HexaGaN-org/gan-buck-converter/docs/design/input_supply.md

# Input and Supply — Design Notes

Sheet: `sheets/input_supply.kicad_sch`

**Owner:** Reza Rahimzadeh · **Reviewer:** [NAME] · **Last updated:** 2026-11-12

---

## Purpose and requirements

Protect the board from the 48 V input, measure the input current, and generate the low-voltage rails every other sheet runs on (`+5V`, `+3V3`), from either the 48 V bus or an external 5 V bench supply.

Targets are in [specifications.md](../specifications.md); boundaries and interface signals are in the **Input and supply** section of [schematic-hierarchy.md](../schematic-hierarchy.md).

**Requirements**

- Accept the full input voltage range in the specifications: 40–51 V, 48 V nominal (decision #2).
- Carry the input current: 3.95 A at 150 W and 40 V, with parts sized for the 200 W headroom (5.3 A).
- Clamp input transients below the switch-node limit published by power_stage: **90 V** (the LM5113-Q1's HS rating), including ringing. Choose the TVS clamp voltage, the fuse rating and that limit together; GaN has essentially no avalanche capability, so the clamp must stop a transient before it gets there.
- Target an ordinary hot-plug below the TVS's breakdown voltage, so the TVS is reserved for faults. This target is **unverified**: the no-TVS model reaches about 56.6 V with nominal values and 0.5 µH leads, 0.1 V below the 56.7 V minimum breakdown specification, and up to 67.1 V across the assumed part ranges.
- Protect against reverse polarity on both J201 (48 V) and J202 (5 V).
- Supply about 150 mA on `+5V` (GaN driver bias, 3.3 V LDO, USB bridge, LEDs) from an aux regulator rated for at least 300 mA.
- Select automatically between J202 and the aux regulator, with reverse-current blocking. Favor a healthy aux supply after it starts while retaining J202-only bring-up; verify that the `+5V` rail rides through every source change without resetting the MCU. If the MCU does reset, the enable sheet holds both gates off.
- Set the mux crossover so aux can take over while J202 still supplies a healthy 5 V, subject to comparator and resistor tolerances (decision #28).
- Rate J202 for at least 0.5 A. Overcurrent on the 5 V path is limited by the bench supply and the mux's current limit (decision #15).
- Provide `+3V3` for the MCU (VDDIO and VDDA, decision #19) and logic, regulating through the `+5V` hand-over dip (input down to ≈ 4.4 V).
- Allow full low-voltage bring-up from J202 with no 48 V connected.
- Measure the board's input current with a high-side shunt (decision #17), so firmware can report input power, estimate efficiency and limit input current.

**Status (2026-11-10):** schematic complete, including the indicator LEDs, and `I_SH_IN_P` / `I_SH_IN_N` are wired to sensing on the root sheet.

---

## Decision log

One row per significant choice. Never delete a row: mark it *Superseded* and add the new decision below it.

| # | Date | Decision | Options considered | Rationale | Impact on other sheets | Status |
|---|---|---|---|---|---|---|
| 1 | 2026-11-03 | 5 V source selection with a two-input power mux (TPS2121-class), external input J202 has priority | Schottky diode-OR; a jumper | The mux selects automatically with milliohms of drop and blocks reverse current, so the bench supply can never back-feed the 48 V bus. A Schottky OR drops 0.3–0.5 V, which can push the GaN driver's bias out of its 4.5–5.5 V range. Plugging in a bench supply is deliberate, so it wins; unplugging hands the rail back to the aux regulator | power_stage: `+5V` must stay within 4.5–5.5 V | Superseded by #28 for source priority |
| 2 | 2026-11-04 | Input voltage range **40 V min, 48 V typ, 51 V max** | 36–54 V (the simulation's assumption), which needs an SMBJ54A: 87.1 V clamp, 2.9 V below the 90 V limit; 40–54 V (same TVS problem) | 51 V matches the SMBJ51CA 51 V standoff. Its 82.4 V clamp at the specified 7.3 A pulse leaves 7.6 V to the driver's 90 V recommended HS limit before wiring and switching overshoot; it is not a universal surge ceiling. 40 V matches the common floor of 48 V systems; going lower raises the 200 W input current to 5.8 A for no benefit on a bench board. Below 40 V the board can still run at reduced load for bring-up, with the firmware UVLO overridden | specifications.md updated. Everything on `V_IN` must survive at least the 82.4 V rated-pulse reference and the measured application transient. power_stage input ceramics still pass at 40 V (calculation below). sensing: `V_IN_SENSE` covers the range. Simulation updated, no change to the loop margins (feedforward) | Accepted |
| 3 | 2026-11-04 | J201: Kefa KF635-6.35-2P screw terminal (C475102), the same part as J301 | XT60 (polarized, but needs an adapter lead to the bench supply, the reason it was rejected for J301); 4 mm binding posts (two extra part numbers) | 32 A and 10 AWG against at most 5.3 A; bench leads land directly; no extra loading fee | Layout: J201 and J301 are identical terminals, and 48 V on J301 would destroy the 25 V output capacitors. Put them on opposite board edges with large `48 V IN` / `12 V OUT` silkscreen and the same polarity orientation | Superseded by #30 |
| 4 | 2026-11-04 | Front-end order: J201 → fuse F201 → TVS D201 across the input → reverse-polarity FET Q201 in the return → damping capacitor C203 → `V_IN` | TVS downstream of the reverse-polarity FET; fuse after the TVS | The fuse comes first so a TVS that fails short (their usual failure) opens it. The TVS sits at the point of entry so a surge is stopped before it reaches Q201 or the power stage; being bidirectional (#5), it ignores reversed leads | none | Accepted |
| 5 | 2026-11-04 | TVS: SMBJ51CA, **bidirectional**, 600 W (hongjiacheng, C41376101) | SMBJ51A unidirectional (Littelfuse C1973217); SMBJ54A (87.1 V clamp) | 51 V standoff = maximum input; 56.7 V minimum breakdown; 82.4 V clamp at the specified 7.3 A pulse. The original hot-plug model predicted a peak below breakdown, but decision #26's added U201 capacitance removes that modeled margin. Bidirectional polarity means reversed 48 V leads do not forward-bias it; a unidirectional part across J201 could conduct continuously behind a current-limited supply. Preferred part, no loading fee | power_stage: 82.4 V `V_IN` clamp reference at the specified pulse | TVS retained; hot-plug margin pending validation |
| 6 | 2026-11-04 | Reverse polarity: **low-side N-FET** Infineon BSC070N10NS3G (C501502) in the J201 return, drain to J201−, source to GND; gate from the protected input through R202 100 kΩ 1206, clamped to 12 V by zener D202 (BZT52C12) | High-side P-FET (best 100 V part at JLCPCB with a datasheet: Vishay SUM70101EL, 10.1 mΩ, D²PAK, $4.41); high-side N-FET with an ideal-diode controller (LM74700-Q1 / LM74800-Q1 are rated 65 V, below the 82.4 V clamp); series Schottky (≈ 2 W at 4 A) | Lowest loss (≈ 0.16 W at 3.95 A), $0.60, 5 × 6 mm, and its 100 V rating exceeds the TVS's 82.4 V clamp at the specified rated pulse, with no controller to protect. Larger surges and lead-inductance overshoot still need validation. The cost is that board GND is no longer the supply's negative; acceptable because this is a standalone board on a floating bench supply. **Revisit for any design that shares ground with other boards** (signal grounds would carry return current in parallel with the FET) | Bench: keep the 48 V supply floating; measure at the board's `V_IN` / GND test points, not at J201 | Accepted |
| 7 | 2026-11-04 | Fuse F201: Littelfuse 0451007.MRL, 7 A, 125 V DC, fast-acting, 2410 (C99548) | 7 A 1206 fuses rated 32 V (below the clamp voltage); time-lag 2410 parts (I²t 100+ A²s, no need) | Voltage rating above the 82.4 V clamp. 56 % of rating at 150 W and 40 V. Melting I²t 10.3 A²s is about 19× the current nominal hot-plug model's largest 0.53 A²s; confirm real lead conditions and repeated-pulse behavior. 50 A interrupting rating is intended for a current-limited bench supply. It protects wiring and the supply from a hard short; it cannot save the GaN FETs from switching faults | none | Accepted; updated hot-plug estimate in #26 |
| 8 | 2026-11-04 | Damping capacitor C203: JARSON FZ2A101M1313, 100 µF 100 V aluminum electrolytic, 320 mΩ ESR (C5260780), from `V_IN` to GND downstream of Q201 | No bulk capacitor; a polymer capacitor (ESR too low to damp anything) | Original calculation used only the power stage's 10.4 µF of ceramics and predicted about 54 V on a 51 V hot-plug with C203. It omitted U201's ceramics on the same `V_IN` bus; decision #26 and the current calculation below replace the hot-plug conclusion. C203 also lowers the input-filter output-impedance peak in the original model | none | Superseded by #27: 0.32 Ω is impedance, not a specified ESR; hot-plug margin pending validation |
| 9 | 2026-11-05 | Keep the single C203 (decision #8); judge its ripple current against its ambient-derated rating, not the 105 °C figure | Two 47 µF 100 V electrolytics in parallel (high-ESR parts are rated only 0.2 A each, which is worse); two low-ESR 47 µF parts (AISHI C3038651) plus a 0.20 Ω metal-strip damping resistor (Vishay WSL2512R2000FEA, C844905): works, 3 parts; a single larger-can 100 µF (Ymin VKME1452A101MV, C487440, 1.04 A) | An electrolytic's ripple rating is set at its maximum temperature (105 °C) to cap core temperature; at a 25–45 °C bench ambient the allowed ripple is typically 1.7–2× higher. The 0.75 A worst case is a sweep corner (40 V, 300 kHz, full load); at 48 V and 400 kHz it is 0.49 A, inside even the 105 °C rating. Moving C203 farther from the power stage barely helps (20 → 80 nH: 0.75 → 0.71 A), because ESR, not inductance, sets the split | none | Superseded by #27: revised model and exact JARSON datasheet remove the claimed ripple margin; ambient multiplier unverified |
| 10 | 2026-11-05 | Aux regulator U201: TI LM5164DDAR (C477928), 100 V 1 A synchronous buck, constant on-time | LM5163 (0.5 A, same family, $2.28; datasheet not checked); LM5017 / LM5018 (older 100 V parts); SCT2A10A (100 V, $2.89); SY8511 and other non-synchronous parts (need a catch diode); 60–80 V parts (below the 82.4 V clamp) | VIN absolute maximum 100 V, 17.6 V above the TVS clamp reference at its specified pulse; 6–100 V operating, so it also starts during reduced-voltage bring-up; synchronous, internally compensated and with an internal VCC regulator, so few parts; 1 A against a ≈ 150 mA load | none | Accepted |
| 11 | 2026-11-05 | U201 configuration: ≈ 620 kHz (R207 20 kΩ), Type-3 ripple injection (R205 / C202 / C204), EN/UVLO tied to `V_IN`, PGOOD unused, output on local net `5V_AUX` | 750 kHz with 16.9 kΩ (Extended part); Type-1 ripple (1 resistor, but ≈ 80 mV on the GaN driver's supply); an EN divider for a 38 V hardware UVLO (2 parts) | 620 kHz sits above the power stage's 300–500 kHz band and keeps 97 ns on-time at the 82.4 V clamp (50 ns minimum). Type 3 keeps output ripple ≈ 2 mV on the rail that drives the low-side GaN gate directly. Tying EN to `V_IN` costs nothing; input UVLO stays with firmware. `5V_AUX` must be a local label, not the `+5V` power symbol, or the bench supply on J202 back-feeds the regulator and charges `V_IN` through its high-side body diode | firmware: owns input UVLO (open questions) | Accepted |
| 12 | 2026-11-05 | Power mux U203: TI TPS2121RUXR (C485916) | TPS2116DRLR (C3235557, $0.39, 1.6–5.5 V, no overvoltage cutoff) | `+5V` drives the GaN driver's VDD, which drives the low-side gate with no clamp (power_stage #5). The TPS2121 survives 22 V on its inputs, and OV1 cuts J202 off before `+5V` exceeds the gate's limit; a bench supply set to 12 V by mistake destroys a TPS2116 and passes through. 56 mΩ on-resistance: ≈ 10 mV at 150 mA | power_stage: `+5V` protected against J202 overvoltage | Accepted |
| 13 | 2026-11-05 | Mux configuration: XCOMP fast switchover (≈ 5 µs), following TPS2121 datasheet Figure 10-9. IN1 = `5V_EXT`, IN2 = `5V_AUX`. PR1 and OV1 share one divider from IN1 (R210 75 k / R213 8.2 k / R216 20 k); CP2 from IN2 (R212 30 k / R215 10 k); OV2 and ST to GND; ILM R214 100 kΩ; SS C215 100 nF | Plain priority mode (≈ 100 µs switchover, needs ≈ 100 µF effective on `+5V`, about six 22 µF parts); separate OV1 and PR1 dividers as in Figure 10-9 (one more resistor); ST driving the SOURCE LED (ST is open-drain and needs a 6–20 kΩ pull-up) | At the TPS2121's typical 5 µs fast transfer, one 22 µF capacitor predicts ≈ 55 mV of dip; no maximum transfer time or minimum rail voltage is established. Ratiometric switch point: J202 hands over below 0.915 × `5V_AUX` (≈ 4.54–4.68 V). OV1 cuts J202 at 5.47 V nominal (5.21–5.68 V), between a 5.0 V bench setting and the GaN gate limit. Current limit ≈ 1.24 A. SOURCE LED (LED203) powered from `5V_EXT` instead, so it lights whenever J202 is live | power_stage, mcu: illustrative `+5V` value ≈ 4.48 V during a hand-over; see current margin review | Source preference and R212 superseded by #28; XCOMP and OV1 retained |
| 14 | 2026-11-05 | J202: JST B2B-XH-A(LF)(SN) 2-pin keyed header (C158012), with a dedicated banana-to-XH bench cable | 5.08 mm screw terminal (C8465); 2.54 mm pin header; barrel jack | A keyed wire-to-board connector physically can't take the 48 V bench leads; a screw terminal accepts any wire, and 48 V on J202 exceeds the TPS2121's 24 V absolute maximum. Keying also makes reversed polarity unlikely. 3 A rating; genuine JST, 600k in stock, $0.04 | Bench: build one J202 cable (XH housing and crimps to banana plugs) | Accepted |
| 15 | 2026-11-05 | J202 reverse polarity: high-side P-FET Q202 AO3401A (C15127, Basic), drain to J202 pin 1, source to `5V_EXT`, gate to GND. No PTC on J202 | PTC (e.g. 500 mA 1206); Schottky diode (0.3–0.4 V drop, too much for the driver's 4.5 V minimum); the TPS2121's GND-pin diode scheme (protects only the mux) | 60 mΩ at 4.5 V, ≈ 9 mV drop; gate rated ±12 V, so no zener at 5 V. Overcurrent is already limited by the bench supply, the TPS2121's ≈ 1.24 A current limit and the 3 A connector; between J202 and the mux there is only Q202 and a short trace. Changes the requirement that J202 have a fuse or PTC | none | Accepted |
| 16 | 2026-11-05 | USB-C (USBC701, comms_debug) stays data only; J202 remains the 5 V bring-up input | USB VBUS as mux IN1 in place of J202 | Keeps comms_debug.md's requirement that USB never powers the board or back-powers the MCU. VBUS can sag to ≈ 4.75 V, tight against the driver's 4.5 V minimum, and a board fault would load the laptop's port | none | Accepted |
| 17 | 2026-11-05 | Input current sense: **1 mΩ shunt R201, the same part as power_stage R301** (FOJAN FPM253WFR001TML, C7420016), high side, between the protected input (after F201 and D201; Q201 sits in the return) and the `V_IN` node, so it carries C203's, U201's and the power stage's current. Kelvin pair `I_SH_IN_P` / `I_SH_IN_N` to sensing through net ties (#21) | No input sensing (firmware infers input power from the output); 2 mΩ shunt (2× the signal, 22 mW, but a new Extended part); low-side shunt in the return (ground-referenced, but it splits board ground from J201− further and a bench ground loop can bypass it) | One unique part already on the board, so no loading fee; 16 mW at 40 V full load. Gives on-board input power for telemetry, an input-current limit, fault diagnosis (input power that doesn't match output power), and coarse on-board efficiency (about ±1–2 %, ±0.3 % after bench calibration). It is **not** accurate enough to label the edge-AI training data, which still comes from bench instruments | sensing: new amplifier channel with common mode at `V_IN`, surviving the 82.4 V transient. mcu: one more ADC pin. schematic-hierarchy: new signals `I_SH_IN_P`, `I_SH_IN_N`, `I_IN_SENSE` | Accepted |
| 18 | 2026-11-05 | 3.3 V LDO U202: ST LDL1117S33R (C435835), SOT-223, 1.2 A, from `+5V` | AMS1117-3.3 (C6186, Basic, no loading fee); ME6211C33 (C82942) and RT9013-33 (C47773), both SOT-23-5 | Dropout 350 mV typ / 600 mV max at 1.2 A; the original #13 illustrative 4.48 V hand-over point gives ≈ 1 V of headroom, but the actual minimum is unbounded and 3.3 V regulation through transfer requires measurement. The AMS1117's 1.1–1.3 V dropout needs ≥ 4.6 V in, and it wants 5 mA quiescent current and traditionally a 22 µF tantalum output. ME6211 / RT9013 are rated 6 V / 5.5 V maximum input, too close to the 5.68 V worst-case J202 cutoff, and ≈ 0.26 W in SOT-23-5 runs hot. LDL1117: 20 V absolute maximum, θJA 56 °C/W, ±2 % at 25 °C, ±3 % over temperature, stable with ceramics | mcu: `+3V3` 3.3 V ±3 % | Accepted |
| 19 | 2026-11-05 | No separate `+3V3A`: MCU VDDA stays on `+3V3`, as the MCU sheet already draws it | Ferrite bead (Murata BLM18PG121SN1D, C14709) plus 1 µF on this sheet feeding a `+3V3A` net to VDDA | TI permits a common source for VDDIO and VDDA. Saves two parts and a cross-sheet net, and needs no change on the MCU sheet, where VDDA is decoupled to `GNDA` and `GNDA` joins `GND` at one net tie. Revisit if the ADC noise floor turns out to matter (verification test 15) | schematic-hierarchy: `+3V3A` removed. sensing: clamp signals to `+3V3`, not `+3V3A` | Accepted |
| 20 | 2026-11-05 | Power LED LED202 (KENTO KT-0805G, green) on `+3V3` through R209 2.2 kΩ | Power LED on `+5V` | `+3V3` is the last rail in the chain, so a lit LED means every upstream rail is up. Green keeps it distinct from the yellow SOURCE LED. 2.2 kΩ reuses the MCU sheet's part | none | Accepted; R209 value superseded by #25 |
| 21 | 2026-11-05 | Shunt Kelvin connections through net ties NT201 and NT202, brought out as hierarchical labels `I_SH_IN_P` (fuse side) and `I_SH_IN_N` (`V_IN` side) | Labels directly on the shunt's power wires (how power_stage R301 is drawn today) | Without the ties, `I_SH_IN_N` would be the `V_IN` net under a second name and `I_SH_IN_P` the whole fuse node, so layout could tap the sense lines anywhere on 5 A copper. With a 3–5 mV signal, a few centimetres of power copper in the measurement path is a few percent of error. The ties make two separate nets that can only meet the power copper at the shunt's pads, and DRC enforces it | root sheet: sheet pins to sensing (pending). power_stage: R301 had the same issue; resolved 2026-11-06 with NT302 / NT301 (power_stage #14) | Accepted |
| 22 | 2026-11-05 | Test points TP201–TP205 on `5V_EXT`, `5V_AUX`, GND, `+5V` and `+3V3`. `V_IN` uses power_stage's `TP_VIN301`. No test point on `V_IN_RTN` | A second `V_IN` test point; a pad on `V_IN_RTN` | One `V_IN` pad is enough on one net. The ground pad sits beside the rail points so the 5 µs hand-over dip (test 9) can be scoped with a short ground spring; power_stage's ground pads are by the switch node and `V_OUT`. A pad on `V_IN_RTN` invites a ground clip that bypasses Q201 | none | Accepted |
| 23 | 2026-11-06 | Keep the J202 overvoltage cutoff as designed (#13: OV1 5.47 V nominal, 5.21–5.68 V) and treat it as a mistake-catcher, not a guarantee that `+5V` stays at or below 5.5 V | Retune OV1 to ≈ 5.30 V nominal (5.05–5.50 V), which keeps `+5V` ≤ 5.5 V but can cut off a 5.0 V bench supply at worst-case $V_{REF}$, and moves the hand-over ratio (#13) | No divider satisfies both: with $V_{REF}$ at ±4 %, a cutoff that never exceeds 5.5 V reaches down to 5.05 V. The bench rule is 5.0 V on J202, so the band between 5.5 V and the cutoff is reachable only with a mis-set supply. In that band the low-side GaN gate sees up to 5.68 V continuously, above Infineon's 5.5 V recommended maximum (its ±6.5 V rating is for pulsed, abnormal conditions only). Accepted risk on a bench board | power_stage: published `+5V` maximum now states this exception (power_stage #15) | Accepted |
| 24 | 2026-11-06 | Fast input-overvoltage trip: `V_IN_SENSE` on a CMPSS comparator routed through the ePWM X-BAR to the trip zone, threshold ≈ 55 V (≈ 1.43 V at sensing's $V_{IN}/38.5$ scale), latched | ADC-only input OVLO (the 53 V proposal in the open questions: tens of microseconds or slower, too slow for a surge); a hardware comparator on this sheet feeding the enable logic | The 7.6 V clamp margin (#2) covers `V_IN` alone. A surge that arrives while the converter is switching adds switch-node overshoot on top of the clamped `V_IN` (power_stage verification test 2 allows up to ≈ 32 V of overshoot at 48 V). The target is to stop switching within about a microsecond of a qualifying input surge, before the two voltages can stack toward the 90 V HS limit. The nominal 1 µs RC alone takes about 1.61 µs to cross a 55 V threshold for an ideal 51-to-56 V step, so the target remains unproven. 55 V sits above the 51 V maximum (plus ≈ 0.4 V of filtered switching ripple) and the proposed 53 V slow OVLO, and below the TVS's 56.7 V minimum breakdown. A hot-plug transient can latch the trip while the stage is idle; its revised nominal model peaks around 56.0–57.5 V, so firmware clears the latch before enabling switching | sensing: C405 changed to 1 nF, giving a nominal 1 µs RC time constant. mcu: `V_IN_SENSE` stays on pin 15, CMPSS3 low comparator with inverted output; its trip is separate from the CMPSS3 high overcurrent path. firmware: configure, latch, clear before enable. Verify end-to-end response on hardware | Accepted topology; response-time target pending verification |
| 25 | 2026-11-06 | Indicator LEDs per [indicator-leds.md](indicator-leds.md): LED202 `POWER` (KT-0805G) through R209 **330 Ω**; LED203 `EXT 5V` changed to white KT-0805W (C34499) through R211 **2.2 kΩ**; new LED201 `48V` (red NCD0805R1, C84256) fed from the fuse node through **R203 ∥ R204**, 100 kΩ 1206 each, cathode to GND. Supersedes #20's R209 value | 48V tap on `V_IN` (after R201), as first planned; a single 100 kΩ (≈ 0.5 mA) | One color scheme and ≈ 1 mA across the board (indicator-leds.md); the 2.2 kΩ that R209 had left the green POWER LED at 0.1–0.3 mA. Tapping the fuse node (like R202) keeps the LED's ≈ 1 mA out of the input-current reading. With the cathode on GND, a reversed input finds no path through the LED: Q201 blocks it | none | Accepted |
| 26 | 2026-11-11 | Increase U201's local input bank from C206/C207 to **C206/C207/C208/C209/C210**, five Samsung CL31B225KCHSNNE 2.2 µF, 100 V X7R 1206 parts in parallel | Keep two (below TI's recommended 2.2 µF after the recorded DC-bias loss); use four (small estimated corner margin at 51 V); change to a larger 1210 part | The [recorded Samsung curve readback](../guides/preferred-parts.md) retains 37.5% at 48 V and 29% at 60 V. Linear interpolation gives about 35.4% at 51 V: five parts estimate 3.89 µF there, or 2.98 µF after multiplying by the part's -10% initial tolerance and X7R's -15% temperature allowance from the [manufacturer specification](https://evelta.com/content/datasheets/110-CL31B225KCHSNNE.pdf). This is an engineering budget, **not a guaranteed minimum at bias**; verify the exact-part bias data and local VIN/GND placement before layout freeze. The additional bus capacitance changes the hot-plug model and TVS margin | input_supply: update hot-plug sensitivity; layout: all five form U201's local high-frequency bank | Schematic change made; capacitance and hot-plug margin pending validation |
| 27 | 2026-11-11 | Keep D201 and C203 provisionally while correcting the hot-plug model; do not claim ordinary 51 V live hot-plug is TVS-free | Replace the TVS or bulk cap immediately from nominal voltage alone | The revised model includes all five U201 input capacitors and a sensitivity TVS branch. The [exact JARSON FZ datasheet](https://atta.szlcsc.com/upload/public/pdf/source/20240702/CB724D03555E79E98CBC22F7BB5AFDA6.pdf) rates C203 at **0.45 A rms at 100 kHz/105 °C**, below the modeled 0.56 A at 40 V/300 kHz, and its 0.32 Ω number is impedance at 100 kHz/20 °C, not a guaranteed ESR. This leaves both ripple life and hot-plug damping unqualified. Ymin [VKME1452A101MV](https://www.ymin.cn/chip-miniature-type-aluminum-electrolytic-capacitors-vkm-product/) is a 100 V/100 µF, 1.04 A-rated candidate but gives no exact-part ESR/impedance data; it also needs a new footprint and assembly check. Ask for impedance/ripple data or select and model a documented alternative before freezing the BOM | layout: keep C203 placement flexible; test: measure actual hot-plug and C203 heating | Input protection and C203 part choice remain open |
| 28 | 2026-11-11 | Move the TPS2121 crossover earlier by changing R212 from 30 kΩ to 26.1 kΩ (UNI-ROYAL 0603WAF2612T5E, JLC C23356); keep R215 10 kΩ, the J202 OV1 divider, the 4.96 V aux set point, and C214 unchanged. Healthy aux may take over before J202 is removed; J202-only bring-up still works. Supersedes #1 priority and #13 R212 setting | Retune aux or add output hold-up now; keep J202 unconditionally preferred; add an XREF reference and qualification circuit | The nominal XCOMP ratio rises from 0.915 to 1.014. At 4.96 V aux, the nominal falling-J202 crossover is near 5.03 V; during aux rise with J202 near 4.99 V, takeover is near 4.92 V. Source selection with both rails near 5 V is tolerance dependent (only about 10 mV nominal CP2−PR1 at 4.99 V ext/4.96 V aux, versus 40 mV maximum comparator offset). A screening calculation using 1 % resistors, 40 mV offset, 4.81 V low aux, 150 mA, 5 µs and 13.6 µF effective C214 gives a lowest illustrative rail near 4.52 V, including an assumed 10 mV mux drop; 300 mA, a longer transfer, or lower effective capacitance can cross 4.5 V. TPS2121 specifies no maximum fast-transfer time | input_supply: measure both ramp-up source change and J202 removal; power_stage: check U301 VDD; layout: no new capacitor or active part | Schematic updated; rail margin and source selection pending bench validation |
| 29 | 2026-11-11 | Replace C203 with Ymin VKME1452A101MV (LCSC C487440), 100 µF/100 V, 1.04 A rms at 100 kHz/105 °C; supersedes #27's provisional JARSON part choice | Keep the JARSON 0.45 A part; Vishay MAL215099907E3 at 0.66 A | The modeled worst operating ripple was 0.47 A rms, a 2.21× nameplate margin at the stated rating conditions; with power_stage's three-part bank (its decision #24) it is 0.68 A rms and 1.53×. The new part is smaller, Ø10 × 14.5 mm, and now uses the C487440-specific JLCImport land pattern and 3D model. Its ESR is not published for the exact part, so hot-plug damping and TVS pulse exposure remain assumptions in the model. The imported footprint has 4.50 × 1.65 mm pads on 9.00 mm centers, with pad 1 positive; confirm board placement/rotation, JLC assembly availability, and measured transient behavior before release | layout: C203 footprint and placement change; simulations: ESR remains a swept assumption | Exact-part JLC CAD footprint assigned; placement preview, stock and damping pending verification |

| 30 | 2026-11-13 | Replace J201 with Amass XT30PW-M30.G.Y PCB male (C431092), pad 2 positive, pad 1 `V_IN_RTN`; supersedes #3 | Keep the screw terminal; use XT60 at the input | Different size from the 12 V output connector, polarized cable interface, 15 A listing against at most 5.3 A estimated input; the source cable uses a female XT30U-F solder plug and must be built before bench use | Layout: right edge placement, solder and mounting holes, copper routing, cable clearance, and [harness note](input-output-connectors.md). JLCPCB: Extended, Economic-compatible wave soldering | Implemented in schematic and PCB footprint; routing and physical fit pending |
---

## Calculations

One row per calculation. Note where each input came from (specification, datasheet, measurement) in Notes.

| Calculation | Formula | Result | Notes |
|---|---|---|---|
| Input current, 150 W | $P_{out} / (\eta V_{in})$ | 3.95 A at 40 V · 3.29 A at 48 V · 3.10 A at 51 V | η ≈ 95 % (specifications) |
| Input current, 200 W | same | 5.26 A at 40 V · 4.39 A at 48 V | Rating case for F201, Q201, J201 and copper |
| TVS clamp margin | $V_{HS,max} - V_{C}$ | $90 - 82.4 = 7.6$ V | SMBJ51CA $V_C$ at $I_{PP}$ = 7.3 A (datasheet); LM5113-Q1 HS 90 V (power_stage). Trace inductance between D201 and the protected node spends this margin |
| TVS dynamic resistance (worst case) | $(V_C - V_{BR,max}) / I_{PP}$ | $(82.4 - 62.7) / 7.3 \approx 2.7\,\Omega$ | Clamp ≈ $V_{BR} + I R_{dyn}$: about 65 V at 1 A, 71 V at 3 A. A bench supply can't drive the rated current, so real clamps sit low on this slope |
| Input ceramics at 40 V (power_stage check) | $I_{out} D(1-D) / (f_{sw} \Delta V_{in})$ | $12.5 \cdot 0.21 / (300\,kHz \cdot 1\,V) \approx 8.7$ µF needed | D = 0.3. At the 400 kHz nominal frequency the need is 6.6 µF. power_stage's three-part bank (decision #24) gives at least its 8.12 µF 48 V estimate at 40 V (less DC-bias loss), so it meets the 400 kHz figure and is close to the 300 kHz one. The bias estimate is typical, not a guaranteed minimum |
| Q201 conduction loss | $I^2 R_{DS(on),hot}$ | $3.95^2 \cdot 10.5\,m\Omega \approx 0.16$ W (0.29 W at 5.3 A) | 7 mΩ max at 10 V (datasheet) × 1.5 assumed hot |
| Q201 gate-source voltage | zener clamp | ≈ 11–12 V from 15 V input up to the 82.4 V clamp | BZT52C12: 11.4–12.6 V at its 5 mA test current, a little lower at 0.3–0.4 mA. $R_{DS(on)}$ is specified at 10 V; FET limit ±20 V |
| Q201 turn-on time constant | $R_{202} C_{iss}$ | $100\,k\Omega \cdot 3\,nF \approx 0.3$ ms | The body diode carries the current meanwhile; the converter isn't switching yet (UVLO) |
| R202 voltage and power | $(V_{IN} - V_Z)$; $(V_{IN} - V_Z)^2 / R$ | 39 V, 15 mW at 51 V; 70 V, 50 mW at the 82.4 V clamp | 1206 rated 200 V / 250 mW. An 0603 (≈ 75 V working voltage) is too close |
| D202 current | $(V_{IN} - V_Z) / R_{202}$ | 0.28 mA at 40 V, 0.39 mA at 51 V | R202 taps upstream of the shunt, so this current isn't measured: 0.01 % of full-load input current |
| Fuse loading | $I_{in} / I_{rated}$ | 56 % at 150 W, 40 V; 76 % at 200 W, 40 V | Littelfuse suggests ≤ 75 % continuous at 25 °C |
| Hot-plug characteristic impedance | $Z_0 = \sqrt{L_{lead} / C_{cer}}$ | $\sqrt{1\,\mu H / 11.51\,\mu F} \approx 0.295\,\Omega$ | The 51 V estimate interpolates the power-stage bank (three 10 µF + four 100 nF, power_stage decision #24) between 8.12 µF at 48 V and 6.14 µF at 60 V (7.62 µF at 51 V), then adds U201's five capacitors at about 3.89 µF total. These are unverified typical curve readbacks; lead inductance and 0.32 Ω C203 ESR are assumed. |
| Hot-plug peak, 51 V | `simulations/input_hotplug_sim.py` | With C203 and nominal values, about 56.6 / 55.1 / 54.6 V for 0.5 / 1 / 2 µH leads | One-node, no-TVS screening model with an ideal 51 V step and 50 mΩ round trip assumed. The illustrative ceramic range is 8.34–15.14 µF using separate X7S/X7R tolerance and temperature factors; sweeping that range, C203 at 80–120 µF, and assumed ESR from 0.16–0.64 Ω gives up to 67.1 V. These are **not** guaranteed component corners. D201 is upstream of Q201, so the lumped-node result does not prove its pad voltage. Do not claim normal live hot-plug stays below breakdown. |
| TVS pulse sensitivity, 51 V | Piecewise-linear $I_{TVS} = \max(0, (V-V_{BR})/R_{dyn})$ | For $V_{BR}=56.7$ V the nominal lead sweep stays just below breakdown, so the TVS does not conduct; with the assumed ESR/capacitance sweep, up to 2.86 A peak and 1.21 mJ | Illustrative same-node model, not a guaranteed I–V or pulse-rating check. The [Hongjiacheng SMBJ51CA datasheet](https://xonstorage.z8.web.core.windows.net/pdf/hongjiacheng_smbj170a__xonlink.pdf) gives 56.7–62.7 V breakdown at 1 mA and 82.4 V maximum clamp at 7.28 A for a 10/1000 µs pulse. Its 600 W rating must be evaluated with pulse width and temperature; unknown board parasitics and bench-source behavior dominate here. |
| Hot-plug I²t | $\int i^2\,dt$ (simulation) | Up to about 0.53 A²s in the nominal no-TVS lead sweep | Against 10.3 A²s melting I²t for F201. The ideal-step model also predicts up to 229 A peak inrush; source current limit and Q201's initial body-diode path are omitted. Neither figure is a fuse or semiconductor surge approval. |
| Input-filter stability (Middlebrook) | peak $\lvert Z_{out,filter} \rvert$ vs $V_{in}^2 / P_{in}$ | 0.27 Ω with C203 (1.60 Ω without) vs 10.1 Ω at 40 V, full load | Nominal 11.51 µF lumped-bank model over 1–100 kHz; layout parasitics can change the result. |
| C203 ripple current | harmonic split of the pulsed input current (simulation) | About 0.44 A rms at 48 V, 400 kHz; 0.68 A at 40 V, 300 kHz | The model uses the 51 V ceramic estimate at all operating voltages and assumes 20 nH of can ESL plus trace. [Ymin rates the selected C203 at 1.04 A rms](https://www.ymin.cn/chip-miniature-type-aluminum-electrolytic-capacitors-vkm-product/) at 100 kHz/105 °C, 1.53× the modeled worst operating estimate. C203 carries more ripple since power_stage decision #24 reduced the ceramic bank beside it. Actual ripple and can temperature need measurement; published ESR data for this exact part are unavailable. |
| **Input current sense (R201)** | | | |
| Shunt loss | $I_{in}^2 R$ | $3.95^2 \cdot 1\,m\Omega \approx 16$ mW at 40 V, 150 W; 28 mW at 5.3 A | 3 W part, so no thermal concern |
| Shunt signal | $I_{in} R$ | 3.3 mV at 48 V / 150 W · 3.95 mV at 40 V · 5.3 mV at 200 W, 40 V · 0.66 mV at 20 % load | Amplifier offset (tens of µV) is a few percent at 20 % load: calibrate the zero at start-up with switching off |
| **Aux regulator (U201, LM5164)** | | | Equations from the LM5164 datasheet (SNVSAU4D) |
| Output voltage | $1.2\,V (1 + R_{206}/R_{208})$ | $1.2 (1 + 470/150) = 4.96$ V | Type-3 ripple adds about half the FB ripple as offset (≈ 12 mV at FB, ≈ 50 mV at the output), so ≈ 5.0 V expected; confirm on the bench |
| Switching frequency | $2500\,V_{OUT} / R_{207}$ (kHz, V, kΩ) | $2500 \cdot 4.96 / 20 \approx 620$ kHz | Eq. 1. Above the power stage's 300–500 kHz band |
| On-time | $R_{207} / (2.5\,V_{IN})$ (µs, kΩ, V) | 200 ns at 40 V · 167 ns at 48 V · 97 ns at the 82.4 V clamp | Eq. 11. Minimum 50 ns; below 300 ns the minimum off-time is 250 ns |
| Highest input before frequency fold-back | $V_{OUT} / (t_{ON,min} F_{SW})$ | $4.96 / (50\,ns \cdot 620\,kHz) \approx 160$ V | Eq. 17 |
| Inductor ripple | $\frac{V_{OUT}}{F_{SW} L}(1 - V_{OUT}/V_{IN})$ | 0.153 A p-p at 48 V (0.19 A with L at −20 %) | Eq. 18. 47 µH; continuous conduction above ≈ 76 mA load |
| Peak inductor current | $I_{OUT} + \Delta I_L / 2$ | 0.38 A at a 0.3 A design load | L201 saturates at 2 A, above the 1.5 A current limit as the datasheet asks |
| Output capacitance | $\Delta I_L / (8 F_{SW} \Delta V_{OUT})$ | 1.2 µF needed for 25 mV; C205 gives 13.6 µF effective, ≈ 2 mV ripple | Eq. 21. C12891 keeps 62 % at 5 V |
| Input capacitance | $I_{OUT} D(1-D) / (F_{SW} \Delta V_{IN})$ | 0.09 µF ripple-only estimate; five 2.2 µF parts C206/C207/C208–C210 give about 4.13 µF at 48 V and 3.89 µF at 51 V using the recorded bias-curve percentages | Eq. 23 is a ripple estimate, not the full layout recommendation. [TI recommends at least 2.2 µF high-frequency input capacitance](https://www.ti.com/lit/ds/symlink/lm5164.pdf) close to U201. At 51 V, the preliminary 3.89 µF becomes about 2.98 µF if -10% initial tolerance and -15% temperature allowance are applied multiplicatively. The curve values are typical readbacks, so this is not a guaranteed minimum; verify the exact part and layout. |
| Type-3 CA (C202) | $C_A \ge 10 / (F_{SW} (R_{FB1} \parallel R_{FB2}))$ | ≥ 142 pF; 1 nF fitted | Eq. 24 |
| Type-3 RA·CA (R205·C202) | $R_A C_A \le t_{ON}(V_{IN} - V_{OUT}) / 20\,mV$ | ≤ 3.6 × 10⁻⁴ s; 300 kΩ × 1 nF = 3.0 × 10⁻⁴ s | Eq. 25. FB ripple 24 mV at 48 V, 23 mV at 40 V, 16 mV at 12 V (≥ 12 mV minimum) |
| Type-3 CB (C204) | $C_B \ge t_{settle} / (3 R_{FB1})$ | ≥ 53 pF for 75 µs; 100 pF C0G fitted | Eq. 26 |
| R205 (RA) voltage | $V_{SW} - V_{OUT}$ | up to ≈ 77 V at the clamp | 0805 (150 V); 0603 (75 V) is too close |
| **Power mux (U203, TPS2121)** | | | Equations and limits from the TPS2121 datasheet (SLVSEA3F); $V_{REF}$ 1.06 V typ (1.01–1.10 V) |
| J202 overvoltage cutoff (OV1) | $V_{REF}(R_{210}+R_{213}+R_{216}) / R_{216}$ | 5.47 V nominal, 5.21–5.68 V | Keep the bench supply at 5.0 V |
| Aux feedback-only corner | 1.181–1.218 V FB reference and 1 % extremes of R206 = 470 kΩ, R208 = 150 kΩ | 4.81–5.11 V ideal DC | Screening range before Type-3 ripple-injection offset, output ripple, temperature effects beyond the reference specification and wiring drop; measure the actual rail. |
| Hand-over point (XCOMP) | k1 = 28.2/103.2 = 0.2733; k2 = 10/36.1 = 0.2770; IN2 is selected when k1 × V_EXT falls below k2 × V_AUX | Nominal falling-J202 crossover V_EXT ≈ 1.014 × V_AUX = 5.03 V at 4.96 V aux. With V_EXT near 4.99 V, aux-ramp crossover is about 4.92 V. | Comparator offset up to 40 mV and 1 % resistors shift either crossover; aux selection with both rails near 5 V is not guaranteed. |
| Fast-mode condition | V_CP2 ≥ V_REF | 0.2770 × 4.96 = 1.374 V versus 1.10 V maximum V_REF | Nominal XCOMP fast-mode condition is met above about 3.97 V aux, and remains met at both screened crossover corners. |
| Source comparison near nominal | V_CP2 − V_PR1 at V_EXT = 4.99 V, V_AUX = 4.96 V | About +10 mV, favoring aux nominally | Smaller than the TPS2121 40 mV maximum comparator offset; source selection varies with tolerances. |
| J202 valid with no 48 V | $V_{REF} / k_1$ | 3.88 V (3.70–4.03 V) | Plain priority mode when CP2 = 0 |
| Screened crossover corners | Use 1 % extremes of both dividers and a 40 mV adverse comparator offset | During aux rise with V_EXT = 4.99 V, earliest takeover is near V_AUX = 4.64 V; with V_AUX = 4.81 V, latest falling-J202 transfer is near V_EXT = 4.59 V. | With 150 mA, 5 µs, 13.6 µF and an assumed 10 mV mux drop, the latter gives about 4.52 V at OUT. These combined corners are a screening calculation, not a guaranteed minimum. |
| Hand-over dip | ΔV = t_FSW × I_OUT / C_OUT | 5 µs × 0.15 A / 13.6 µF ≈ 55 mV. The combined low-aux, 1 % divider and 40 mV offset screening case gives an illustrative floor near 4.52 V after an assumed 10 mV mux drop. | Nominally aux takes over while J202 is still healthy, so later J202 removal causes no transfer. The screening floor is not a guaranteed minimum: TPS2121 gives 5 µs only typically and the capacitance, load and source voltages require hardware validation. |
| Current limit | $65.2 / R_{214}^{0.861}$ (A, kΩ) | 1.24 A at 100 kΩ; fast trip ≈ 2.4 × that | Eq. 2; 100 kΩ is the largest allowed value |
| Soft-start | Table 9-1 | 780 V/s with 100 nF (C215); ≈ 16 mA inrush into ≈ 20 µF | |
| Divider currents | $V / R$ | 48 µA (PR1/OV1 chain), about 138 µA (CP2 at 5 V aux) | |
| Q202 drop | $I \cdot R_{DS(on)}$ | $0.15\,A \cdot 60\,m\Omega \approx 9$ mV | AO3401A at 4.5 V drive |
| EXT 5V LED (LED203) current | $(V_{EXT} - V_F) / R_{211}$ | $(5 - 2.9) / 2.2\,k\Omega \approx 0.95$ mA (0.82–1.09) | KT-0805W $V_F$ 2.6–3.2 V |
| **3.3 V LDO (U202, LDL1117S33R)** | | | ST LDL1117 datasheet |
| `+3V3` load budget (estimate) | sum of loads | ≈ 120–150 mA; designed for 300 mA | MCU ≈ 100 mA (ESTIMATE: confirm in the TMS320F280039C datasheet §6.5.1, internal VREG at 120 MHz), LEDs ≈ 5–10 mA, USB bridge I/O and enable logic ≈ 10–20 mA |
| Headroom in the hand-over dip | V_IN − V_OUT versus dropout | At the revised illustrative 4.52 V screening point, 4.52 − 3.3 = 1.22 V versus ≤ 600 mV dropout (max, at 1.2 A) | The 4.52 V point is not a guaranteed minimum; measure the actual rail and U202 output through both source transitions. |
| Dissipation | $(V_{IN} - V_{OUT}) I$ | 0.26 W at 5.0 V, 150 mA (≈ +15 °C); 0.51 W at 300 mA (≈ +29 °C); 0.71 W at 5.68 V, 300 mA (≈ +40 °C) | θJA 56 °C/W (ST datasheet, with copper on the tab) |
| Capacitors | datasheet | C211 1 µF at VIN (≥ 1 µF required); C212 10 µF 0603 at VOUT | ST characterizes the output with 4.7 µF ceramic; C212's effective value at 3.3 V is lower than 10 µF but should stay above that |
| POWER LED (LED202) current | $(3.3 - V_F) / R_{209}$ | ≈ 1.4 mA (0.6–2.1) | KT-0805G $V_F$ 2.6–3.1 V; R209 330 Ω (#25) |
| 48V LED (LED201) current | $(V - V_F) / (R_{203} \parallel R_{204})$ | 0.76 mA at 40 V · 0.92 mA at 48 V · 0.98 mA at 51 V · 1.6 mA at the 82.4 V clamp | NCD0805R1 $V_F$ ≈ 2.1 V. Each 1206 dissipates 24 mW at 51 V, 64 mW at the clamp (250 mW rated). Tapped at the fuse node, so not seen by R201 |

---

## Part selection

Refs follow the current schematic, including the 2026-11-11 U201 capacitor addition.

| Ref des | Part | Manufacturer / MPN | LCSC # | Key parameters that justified it | Datasheet |
|---|---|---|---|---|---|
| J201 | 48 V input connector | Amass XT30PW-M30.G.Y | C431092 | Right angle PCB male, 15 A, pad 2 positive to F201, pad 1 `V_IN_RTN`; JLCPCB Extended / Economic wave soldering; [harness and footprint](input-output-connectors.md) | [JLCPCB](https://jlcpcb.com/partdetail/XT30PW-M30.G.Y/C431092) |
| F201 | Input fuse | Littelfuse 0451007.MRL | C99548 | 7 A fast-acting, 125 V DC, 50 A interrupting, melting I²t 10.3 A²s, 2410 | [LCSC](https://www.lcsc.com/product-detail/C99548.html) |
| D201 | Input TVS | hongjiacheng SMBJ51CA | C41376101 | Bidirectional 600 W; $V_{RWM}$ 51 V, $V_{BR}$ 56.7 V min, $V_C$ 82.4 V at 7.3 A; SMB; Preferred (no loading fee) | [LCSC](https://www.lcsc.com/product-detail/C41376101.html) |
| Q201 | Reverse-polarity FET | Infineon BSC070N10NS3G | C501502 | N-channel 100 V, 7 mΩ max at $V_{GS}$ = 10 V, 90 A, ±20 V gate, TDSON-8 5 × 6 mm. Pins 1–3 source, 4 gate, 5–8 and the exposed pad drain | [LCSC](https://www.lcsc.com/product-detail/C501502.html) |
| R202 | Q201 gate pull-up | UNI-ROYAL 1206W4F1003T5E | C17900 | 100 kΩ 1 %, 1206, 250 mW, 200 V; Basic. 1206 for voltage, not power | [LCSC](https://www.lcsc.com/product-detail/C17900.html) |
| D202 | Q201 gate clamp | hongjiacheng BZT52C12 | C19077410 | 12 V zener, 350 mW, SOD-123; Preferred | [LCSC](https://www.lcsc.com/product-detail/C19077410.html) |
| C203 | Input bulk and hot-plug damping capacitor | Ymin VKME1452A101MV | C487440 | 100 µF ±20 %, 100 V SMD aluminum electrolytic, Ø10 × 14.5 mm, 1.04 A rms ripple at 100 kHz/105 °C, 10000 h at 105 °C. ESR is unpublished; the screening model's 0.32 Ω is an assumption. Exact C487440 JLCImport footprint assigned; board placement, JLC assembly stock and damping still need confirmation; decision #29 | [Ymin VKM series](https://www.ymin.cn/chip-miniature-type-aluminum-electrolytic-capacitors-vkm-product/) |
| R201 | Input current-sense shunt | FOJAN FPM253WFR001TML | C7420016 | 1 mΩ 1 % 3 W 2512, ±50 ppm/°C; same part as power_stage R301 | |
| NT201, NT202 | Shunt Kelvin net ties | KiCad `Device:NetTie_2` | — | Footprint only (copper), no part placed | |
| U201 | Aux regulator | TI LM5164DDAR | C477928 | 100 V (abs max) 1 A synchronous buck, COT, internal compensation and VCC; SO-8 PowerPAD; EP to GND | [Datasheet](../datasheets/lm5164.pdf) |
| L201 | Aux inductor | cjiang FNR8040S470MT | C168137 | 47 µH ±20 %, 2 A $I_{sat}$, 1.7 A rated, 177 mΩ, shielded 8 × 8 mm | [LCSC](https://www.lcsc.com/product-detail/C168137.html) |
| C206, C207, C208–C210 | U201 input | Samsung CL31B225KCHSNNE | C170101 | Five 2.2 µF 100 V X7R 1206 parts; this MPN remains on U201 after the power-stage bank changes. Estimated 3.89 µF at 51 V before tolerance/temperature; confirm exact-part DC-bias data | [Samsung product](https://product.samsungsem.com/mlcc/CL31B225KCHSNN.do) |
| C201 | U201 bootstrap | FH 0603B222K500NT | C1604 | 2.2 nF 50 V X7R 0603, Basic. Must be 2.2 nF: a larger value can damage the LM5164 | |
| R207 | U201 RON (frequency) | UNI-ROYAL 0603WAF2002T5E | C4184 | 20 kΩ 1 %, Basic | |
| R205 | Type-3 RA, SW to the RA/CA node | UNI-ROYAL 0805W8F3003T5E | C17616 | 300 kΩ 1 % **0805** (150 V), Preferred | |
| C202 | Type-3 CA, RA/CA node to `5V_AUX` | Samsung CL10B102KB8NNNC | C1588 | 1 nF 50 V X7R 0603, Basic | |
| C204 | Type-3 CB, RA/CA node to FB | Samsung CL10C101JB8NNNC | C14858 | 100 pF 50 V **C0G** 0603, Basic | |
| R206, R208 | U201 feedback divider | UNI-ROYAL 0603WAF4703T5E; 0603WAF1503T5E | C23178; C22807 | 470 kΩ / 150 kΩ 1 %, Basic | |
| C205 | U201 output | Samsung CL31A226KAHNNNE | C12891 | 22 µF 25 V X5R 1206, Basic; 62 % kept at 5 V | |
| U203 | Power mux | TI TPS2121RUXR | C485916 | 2.8–22 V (24 V abs max), 56 mΩ, OV per input, 5 µs fast switchover, VQFN-HR-12 2 × 2.5 mm | [Datasheet](../datasheets/tps2121.pdf) |
| J202 | 5 V bring-up input | JST B2B-XH-A(LF)(SN) | C158012 | 2-pin keyed XH header, 2.5 mm pitch, 3 A, through-hole | [LCSC](https://www.lcsc.com/product-detail/C158012.html) |
| Q202 | J202 reverse-polarity FET | AOS AO3401A | C15127 | P-channel 30 V, 60 mΩ at 4.5 V, ±12 V gate, SOT-23; Basic | |
| C213 | U203 IN1 (`5V_EXT`) | Samsung CL31A226KAHNNNE | C12891 | 22 µF 25 V 1206; large input capacitance for a long bench cable, per the TPS2121 datasheet | |
| C214 | U203 OUT (`+5V`) | Samsung CL31A226KAHNNNE | C12891 | 22 µF 25 V 1206; 13.6 µF effective for the hand-over dip | |
| C215 | U203 SS | YAGEO CC0603KRX7R9BB104 | C14663 | 100 nF 50 V X7R 0603, Basic | |
| R210, R213, R216 | PR1 / OV1 chain from IN1 | UNI-ROYAL 0603WAF7502T5E; 0603WAF8201T5E; 0603WAF2002T5E | C23242; C25981; C4184 | 75 kΩ → PR1 → 8.2 kΩ → OV1 → 20 kΩ → GND, 1 %, Basic | |
| R212, R215 | CP2 divider from IN2 | UNI-ROYAL 0603WAF2612T5E; 0603WAF1002T5E | C23356; C25804 | 26.1 kΩ → CP2 → 10 kΩ → GND, 1 %; R212 Extended | |
| R214 | U203 ILM | UNI-ROYAL 0603WAF1003T5E | C25803 | 100 kΩ 1 %, Basic | |
| LED203, R211 | `EXT 5V` LED on `5V_EXT` | KENTO KT-0805W; UNI-ROYAL 0603WAF2201T5E | C34499; C4190 | White 0805 LED ($V_F$ 2.6–3.2 V), 2.2 kΩ (≈ 0.95 mA); Basic | |
| LED201, R203, R204 | `48V` LED, fuse node → R203 ∥ R204 → LED → GND | NationStar NCD0805R1; UNI-ROYAL 1206W4F1003T5E | C84256; C17900 | Red 0805 LED ($V_F$ 1.6–2.6 V); 100 kΩ 1206 (200 V, 250 mW) ×2, same part as R202; Basic | |
| U202 | 3.3 V LDO | ST LDL1117S33R | C435835 | 1.2 A, 350 mV typ dropout, 20 V abs max, ±2 %, SOT-223; pin 1 GND, pin 2 VOUT, pin 3 VIN, tab = VOUT | [Datasheet](../datasheets/ldl1117.pdf) |
| C211 | U202 input | Samsung CL10A105KB8NNNC | C15849 | 1 µF 50 V X5R 0603, Basic | |
| C212 | U202 output | Samsung CL10A106MA8NRNC | C96446 | 10 µF 25 V X5R 0603, Basic | |
| LED202, R209 | `POWER` LED on `+3V3` | KENTO KT-0805G; UNI-ROYAL 0603WAF3300T5E | C2297; C23138 | Green 0805 LED ($V_F$ 2.6–3.1 V), 330 Ω (#25); Basic | |
| TP201–TP205 | Test points: `5V_EXT`, `5V_AUX`, GND, `+5V`, `+3V3` | KiCad `Connector:TestPoint` | — | Footprint only (`TestPoint_Pad_D2.0mm`, as on power_stage), no part placed; excluded from BOM and position files | |

---

## Values published to other sheets

Numbers other sheets depend on. Update the dependent sheet's owner when one changes.

| Value | Result | Used by | Notes |
|---|---|---|---|
| `V_IN` operating range | 40–51 V (48 V nominal) | all sheets, firmware | UVLO thresholds still to be set (open questions) |
| `V_IN` rated-pulse clamp reference | 82.4 V at the TVS's specified 7.3 A pulse; not a universal worst-case voltage | power_stage, sensing, this sheet | Check 100 V-class ICs/capacitors and 1206 (200 V) resistors against the measured application surge including lead inductance. The `V_IN_SENSE` divider also sees this node. |
| Input overvoltage trip (fast) | ≈ 55 V (1.43 V on `V_IN_SENSE`), CMPSS3 low comparator on pin 15 to a one-shot ePWM trip | sensing, mcu, firmware | Decision #24. Nominal filter τ = 1 µs; low-comparator output inverted to trip above the DAC threshold. Can latch on a hot-plug while idle; firmware clears it before enabling |
| `V_IN` hot-plug peak | About 54.6–56.6 V in the current nominal lumped model, depending on assumed leads | power_stage | Not a guaranteed peak: the assumed capacitance and C203 ESR sweep reaches 67.1 V without TVS, and an illustrative same-node TVS model gives brief conduction. D201 is physically upstream of Q201, so measure the real input transient before claiming part-voltage or hot-plug margin. |
| Board GND vs J201 negative | GND sits I × 10 mΩ (≈ 40 mV) above J201−, which is net `V_IN_RTN` | sensing, firmware, bench | Measure `V_IN` against board GND, never against J201−. Never connect `V_IN_RTN` to GND anywhere but through Q201 |
| Input current, full load | 3.95 A at 40 V (150 W); 5.3 A at 200 W | power_stage, layout | Copper and connector sizing |
| Input shunt | 1 mΩ high side (R201); Kelvin pair `I_SH_IN_P` / `I_SH_IN_N` through NT201 / NT202; 0.66–5.3 mV over the load range | sensing, firmware | Common mode is `V_IN`: 40–51 V in operation, 82.4 V at the TVS rated-pulse clamp; validate the actual surge waveform |
| `+5V` steady state | ≈ 5.0 V from `5V_AUX` (4.96 V set point); bench voltage minus ≈ 20 mV from J202 | power_stage, mcu, comms_debug | GaN driver VDD 4.5–5.5 V |
| `+5V` minimum during source change | About 4.52 V in the revised adverse-corner screening example at 150 mA and a 5 µs transfer; no guaranteed minimum established | power_stage, mcu, enable | The revised ratio normally selects aux before J202 removal. With low aux, resistor and comparator corners it can still wait for J202 to sag; at 300 mA or a longer transfer the rail can drop below the LM5113-Q1 4.5 V minimum. No dedicated 5 V hardware inhibit is fitted. Firmware holds PWM off until the rail is stable at startup, but that alone does not address a dip during active switching. Scope U301 VDD and both driver inputs through both transitions. |
| `+5V` overvoltage protection | J202 is cut off above 5.21–5.68 V | power_stage | The high end exceeds the GaN gate's 5.5 V recommended maximum; accepted for a mis-set bench supply only (decision #23). `5V_AUX` is regulated, so it has no cutoff (OV2 grounded) |
| `+5V` current limit | ≈ 1.24 A (TPS2121 ILM) | all `+5V` loads | Fast trip at ≈ 3 A |
| `+3V3` | 3.3 V ±2 % at 25 °C, ±3 % over temperature; 1.2 A rating, designed for 300 mA | mcu, comms_debug, enable, sensing | Feeds MCU VDDIO **and** VDDA (decision #19); there is no `+3V3A` |

---

## Layout notes

What the layout owner must know: loops to keep small, parts to place first, keep-outs, thermal needs.

- **D201 right at J201**, with short, wide connections to both terminals. Every nanohenry between them adds L·di/dt on top of the 82.4 V clamp and spends the 7.6 V margin.
- **`V_IN_RTN` is its own copper.** It runs from J201− to D201 and Q201's drain pads only; it reaches GND only through Q201. A stray via or pour that touches GND bypasses the reverse-polarity protection.
- Route D202's anode straight to Q201's source pad, not into the general ground pour, so the zener clamps the FET's actual gate-source voltage.
- Q201's drain pads and exposed pad carry the full input current: pour copper on them for current and heat.
- J201 XT30 input and J301 XT60 output are different sizes. Their present placement is tentative and puts both near the right board edge; move J301 and its `12V OUT` label so the connectors have safe mating clearance. Check J201 pad 2 positive and J301 pad 3 positive on the active JLC footprints, and leave room to grip and fully mate the [soldered harness plugs](input-output-connectors.md). J202 can sit anywhere convenient: its keyed JST XH plug is a third, distinct interface.
- Place C203 between Q201 and the power stage, not inside the power loop. The trace inductance between C203 and the power-stage ceramics keeps switching ripple out of C203 (the ripple estimate assumes about 20 nH).
- Size `V_IN`, `V_IN_RTN` and GND copper for 5.3 A (200 W at 40 V).
- **R201 (shunt):** in the high-side path after the front end, before C203 and U201's tap. Place each net tie (NT201, NT202) against the **inner edge** of its shunt pad, and route `I_SH_IN_P` / `I_SH_IN_N` as a tight pair from there to the sensing amplifier, away from the switch node.
- **U201 (LM5164):** Place C206, C207 and C208–C210 as one local bank across VIN (2) and GND (1), with the shortest two parts immediately at the pins and the other three closely beside them. All five need a short return to the same local GND copper to count as high-frequency input capacitance. Keep SW (8) short to L201; put R206, R208 and C204 at FB (5); route the Type-3 network and FB away from SW except R205's own end; tie the exposed pad to GND copper.
- **U203 (TPS2121):** C213 and C214 as close to IN1 and OUT as possible; wide traces for IN1, IN2 and OUT. Keep the dividers short to PR1, OV1 and CP2.
- **U202 (LDL1117):** the tab is **VOUT**, not GND. Give it a copper pour on the `+3V3` net for heat, kept clear of ground copper. C211 at pin 3, C212 at pin 2.
- **Test points:** TP203 (GND) right beside TP201, TP202, TP204 and TP205, so a scope probe's ground spring reaches.
- **48V LED (LED201):** beside J201, without pushing D201 away from J201 (indicator-leds.md). LED201's cathode goes to GND, never to `V_IN_RTN`.

---

## Grounding and scope measurements

The present Q201 interrupts the input return between J201− (`V_IN_RTN`) and board `GND`. With correct polarity, an earth-bonded supply negative and an earthed scope ground clip on board `GND` form a parallel return around Q201; USB, JTAG and grounded loads can do the same. Use a supply whose **DC output floats from earth** for the prototype, while keeping instrument chassis protective earth connected. Attach ordinary scope ground clips only to board `GND`, never J201−. Reversing the leads alone does not create the same bypass: supply negative then lands on J201+, and Q201 blocks J201−. A clip on J201− would instead contact supply positive. [Tektronix explains the probe-ground earth connection and ground-loop current](https://www.tek.com/en/documents/whitepaper/abcs-probes-primer).

Moving reverse protection to the positive rail and directly joining J201− to board `GND` is **not a complete grounded-scope fix**. It removes the low-side FET from the return, but an earth-bonded supply negative and scope still provide parallel return paths, so some current can flow through the probe ground lead. Worse, if the input leads are reversed with the grounded scope attached, supply positive lands on J201− and can flow through board `GND`, the scope lead and earth to supply negative. That short bypasses F201, which is on J201+. A high-side-only replacement must not be presented as safe for that hookup.

Board-level alternatives need a new design: an isolated measurement output can keep a scope earth connection away from board `GND` for selected signals, subject to bandwidth and fault-rating checks; a coordinated two-pole input disconnect can isolate J201− during reversed hookup, but does not by itself remove the normal-operation earth loop. Neither is implemented. Retain the floating-output bench setup until the complete input and probing arrangement is reviewed.

---

## Verification

How bring-up confirms this sheet works.

| # | Test | Method / equipment | Pass criterion | Result | Date |
|---|---|---|---|---|---|
| 1 | Low-voltage bring-up | Current-limited 5 V bench supply on J202, no 48 V connected | MCU, firmware, sensing and enable logic all work | | |
| 2 | 48 V hand-over | Apply 48 V with J202 connected, then unplug J202 | `+5V` stays in regulation; the MCU does not reset | | |
| 3 | Hot-plug | With PWM disabled and a current-limited **floating** supply, use suitable differential/isolated probes to record D201's pad-to-pad voltage and `V_IN` at C203 against board GND (single shot, starting near 1 µs/div) during a controlled 51 V live connection with the intended shortest and longest leads. Record input current with a suitable current probe if available. Never clip an earthed scope ground to J201− / `V_IN_RTN`. | Record both node peaks, ringing, lead/source behavior and any TVS pulse; fit measured parameters back into `input_hotplug_sim.py`. Compare measured TVS pulse width/current/temperature against its datasheet derating and keep every connected component within its voltage limit. Repeat only after the first pulse is reviewed; absence of heating alone is not proof. | | |
| 4 | Reverse polarity | With the 48 V supply floating and USB/JTAG/scope earth paths disconnected, use a clearly marked, deliberately cross-wired XT30 test harness to apply reversed polarity at J201 with the supply limited to 0.5 A, then restore the normal harness | Under 1 mA drawn while reversed; board works normally afterwards. Check separately that the intended bench hookup cannot earth J201 negative and board GND around Q201 | | |
| 5 | Q201 enhancement | Measure $V_{GS}$ of Q201 at 40 and 51 V; measure J201− to GND at full load | $V_{GS}$ 11–12.6 V; drop below 60 mV at 3.95 A | | |
| 6 | C203 ripple heating | Thermocouple on C203 after 30 min at full load, 300 kHz and 40 V | Rise below 5 °C above the board; otherwise act on the open question | | |
| 7 | TVS idle in normal operation | Thermal camera on D201 at 51 V, full load | No heating | | |
| 8 | Aux regulator | `5V_AUX` (TP202) with no load and at 300 mA, at 12, 40 and 51 V; scope SW and FB | 4.9–5.1 V; steady switching near 620 kHz with no bursting; FB ripple 15–30 mV | | |
| 9 | Both 5 V source changes | With J202 supplying 5.0 V and PWM disabled, apply 48 V and scope TP201 (5V_EXT), TP202 (5V_AUX), TP204 (+5V), U301 VDD and J202 current during aux rise. Then remove J202 with 48 V still present; repeat at the highest intended +5 V load and near the lowest allowed 48 V input. | Record which source wins, crossover voltages, minimum U301 VDD and transfer time in both directions. Keep U301 VDD at 4.5–5.5 V throughout tested changes and confirm the MCU does not reset. A dip below 4.5 V requires hold-up or PWM inhibition before full-power switching. | | |
| 10 | J202 overvoltage cutoff | With PWM disabled, raise J202 slowly from 5.0 V with 48 V off, then with 48 V on; record U301 VDD during the sweep | J202 cuts off between 5.2 and 5.7 V. This characterizes the accepted mis-set-supply protection, not a normal operating point: keep U301 VDD at or below 5.5 V whenever switching is enabled | | |
| 11 | J202 reverse polarity | Reverse the J202 cable with the bench supply limited to 0.2 A | Under 1 mA drawn; board works normally afterwards | | |
| 12 | Input current reading | Compare `I_IN_SENSE` (firmware readout) with a bench meter at 0, 20 %, 50 % and 100 % load | Within ±2 % of reading above 50 % load after zero calibration; record the gain correction | | |
| 13 | 3.3 V rail | `+3V3` (TP205) with `+5V` swept 4.4–5.7 V, MCU running; scope during test 9 | 3.20–3.40 V throughout, including the hand-over dip; no oscillation on C212 | | |
| 14 | U202 temperature | Thermocouple on the U202 tab after 30 min with the MCU running and `+5V` from J202 at 5.5 V | Below 85 °C | | |
| 15 | ADC noise floor | Sample a grounded or DC-held ADC input with the power stage switching at full load | Noise small enough for the current-sense resolution sensing needs; otherwise revisit decision #19 | | |

---

## Open questions

- **Mounting holes and the reverse-polarity FET.** H101–H104 are plated 3.2 mm holes with their pads on no net (`MountingHole_3.2mm_M3_Pad`, no-connect flags on the schematic). Plating gives the screw heads a durable bearing surface; leaving the pads unconnected keeps the board isolated from the mounting hardware. Never tie them to `GND`. In layout, check that every inner plane clears each plated barrel, and keep other copper clear of the mounting hardware on both outer layers: a fixed J201−-to-GND short defeats Q201 in either input orientation. With normal lead polarity, an earthed 48 V supply negative plus earthed USB, JTAG, or scope ground provides a parallel return around Q201 and can carry input current through external equipment. It does not automatically make a simple reversed-lead hookup power the board, because the supply negative then lands on J201+ instead. Use a floating supply for this standalone prototype; see [grounding and scope measurements](#grounding-and-scope-measurements) before planning a shared-ground installation.
- **MCU current.** The `+3V3` budget assumes ≈ 100 mA for the F280039C; confirm from its datasheet §6.5.1.
- **C203 damping and assembly (decisions #27 and #29):** The selected Ymin VKME1452A101MV has adequate nameplate ripple margin against the present model, but no published exact-part ESR or impedance. The 0.32 Ω hot-plug model input remains a scenario, not a property of the replacement. Obtain ESR/impedance versus frequency and temperature or measure samples; rerun the hot-plug/filter analysis with that data and verify test 3 on hardware. The [Ymin VKM dimensional table](https://www.ymin.cn/chip-miniature-type-aluminum-electrolytic-capacitors-vkm-product/) confirms a 10 mm can, 14.5 mm height and 10.3 mm square base for this part. The C487440-specific JLCImport footprint and STEP model are now in the project, replacing the Vishay-derived assignment. Its two pads are 4.50 × 1.65 mm on 9.00 mm centers. The imported symbol marks pin 1 positive; the netlist connects C203 pin 1 to `V_IN` and pin 2 to GND. Check the 14.5 mm height, orientation and solder joints in the JLC assembly preview after placement. The JLC CAD data confirms the catalog mapping, but is not a manufacturer land-pattern approval. Confirm JLC assembly availability and live stock. Verification test 6 checks ripple heating.
- **Other evaluated part:** [Vishay MAL215099907E3](https://www.vishay.com/docs/28395/150crz.pdf) (JLC C1984845) is 100 µF/100 V, rated 0.66 A rms at 105 °C/100 kHz, with 0.35 Ω maximum **impedance** at 20 °C/100 kHz and a 12.5 × 12.5 × 13 mm nominal can. [JLC lists Economic SMT assembly](https://jlcpcb.com/partdetail/VishayIntertech-MAL215099907E3/C1984845), but live stock is unverified. It offers less ripple margin than the selected Ymin part, and its impedance is not a guaranteed hot-plug ESR.
- **Input UVLO and OVLO.** Proposed: UVLO on at 38 V, off at 36 V (hysteresis); input overvoltage lockout at 53 V, between the 51 V maximum and the TVS's 56.7 V breakdown. This is the slow, ADC-based layer; the fast ≈ 55 V CMPSS trip is decided (#24). Decide with sensing (`V_IN_SENSE`) and firmware, then fill in specifications.md. U201's EN is tied to `V_IN` (decision #11), so input UVLO is firmware's job; a 2-resistor EN divider could add a hardware UVLO later.
- **Fuse at 200 W, 40 V** runs at 76 % of its rating. Fine for 150 W; choose 8 A if sustained 200 W runs at low input are planned.
- **Bench rules** (also in the README's safety section): keep the 48 V supply floating (no earth strap), and set its OVP at about 55 V. A supply set above about 57 V drives the TVS into continuous conduction. Until the input path is measured, connect leads with the supply output off and enable it afterward; deliberate 51 V live hot-plug is a controlled verification test, not the routine operating procedure.
- **Lead inductance and resistance** in the hot-plug simulation are assumptions; verification test 3 replaces them with a measurement.
- **5V_AUX set point.** Confirm it lands near 5.0 V (test 8). The R212 change makes aux takeover during J202-first startup depend on the actual aux voltage and mux comparator corner; measure both transitions rather than assuming one fixed source. A low aux setting shrinks the handover margin. R208 can be trimmed after measurement without raising the driver above 5.5 V.
- **Driver-supply hand-over validation.** The R212 change lets healthy aux take over before J202 is unplugged in the nominal case, without changing C214 or the aux set point. It does not prove the LM5113-Q1 4.5 V minimum at every load and transfer corner because TPS2121 gives no maximum fast-transfer time. The added 5 V hardware monitor was removed at the owner's request. Firmware will leave PWM off until `+5V` is stable at startup, but a dip during active switching has no dedicated hardware inhibit. Scope U301 VDD and both driver inputs during aux ramp-up and J202 loss before full-power switching. If guaranteed uninterrupted 4.5 V operation is required, add effective output hold-up or qualify a faster transfer path.
- **Normal cold start.** The LM5113-Q1 datasheet instructs VDD before the half-bridge input bus. The current bench rule applies J202 first, but standalone 48 V-only start does the reverse. Obtain TI confirmation for this exact single-source startup with HI/LI held low, or add a rated bus switch so U201 establishes `+5V` before the power stage receives 48 V. A first-board cold-start waveform is required either way; observing one successful start does not override the datasheet sequence instruction.
- **J202 cable**: build one XH-to-banana lead and label it 5 V.
