HexaGaN-org/gan-buck-converter/docs/design/figures/common-source-inductance.png

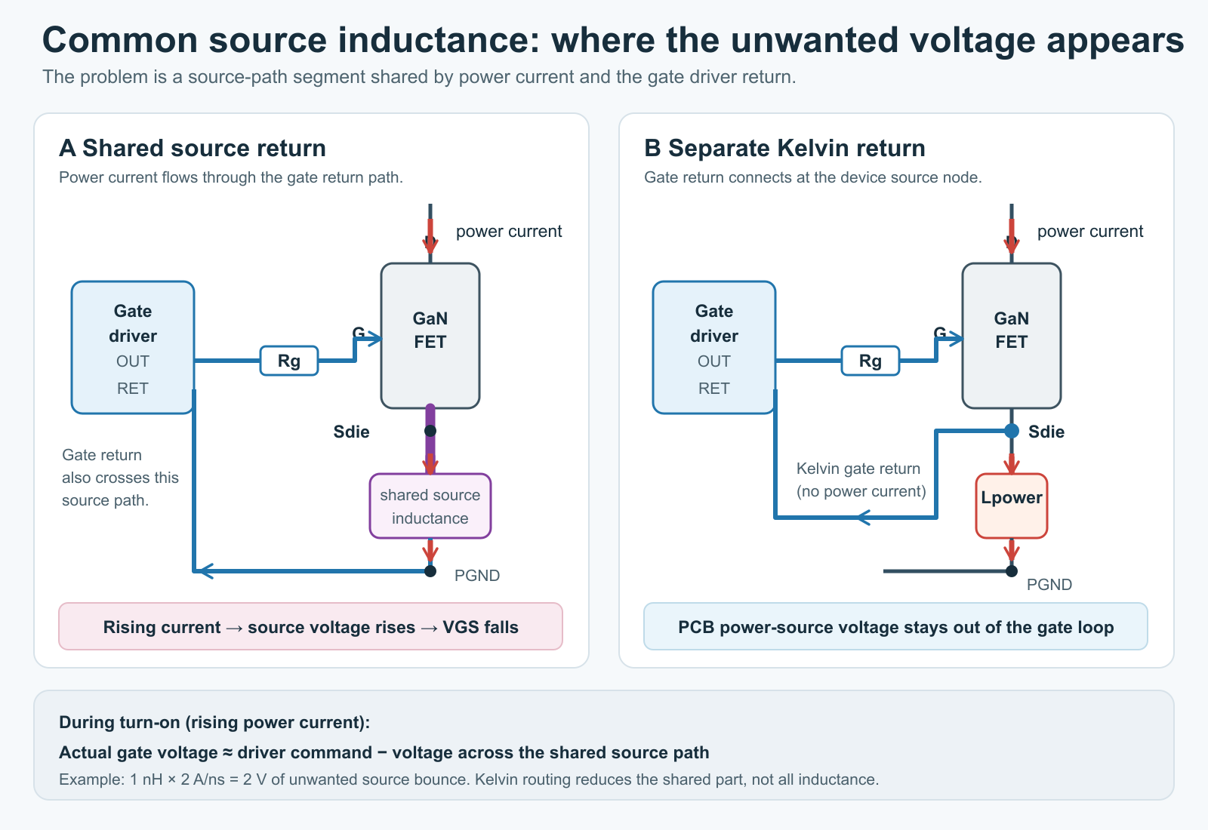
docs/design/figures/common-source-inductance.png
