HexaGaN-org/gan-buck-converter/docs/design/figures/gan-current-loop-fields.png

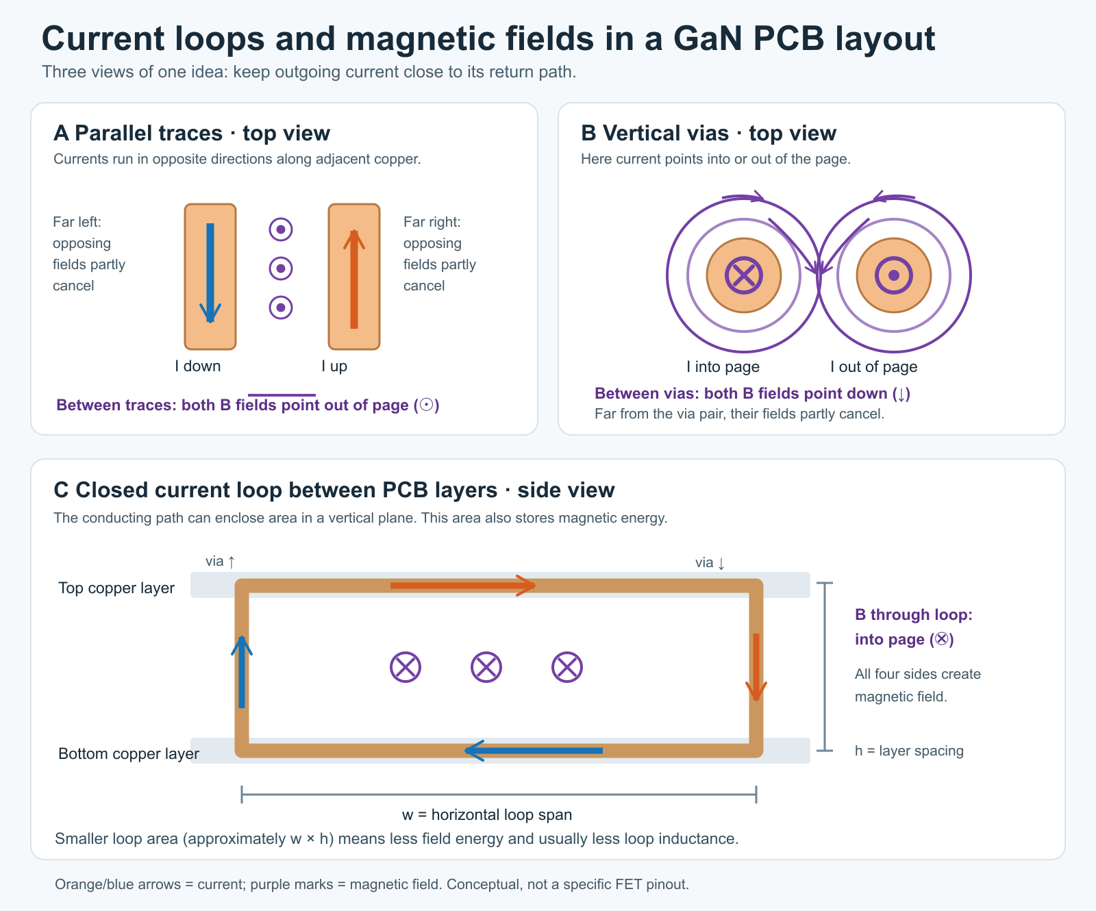
docs/design/figures/gan-current-loop-fields.png
