HexaGaN-org/gan-buck-converter/docs/gan-buck-converter-block-diagram.png

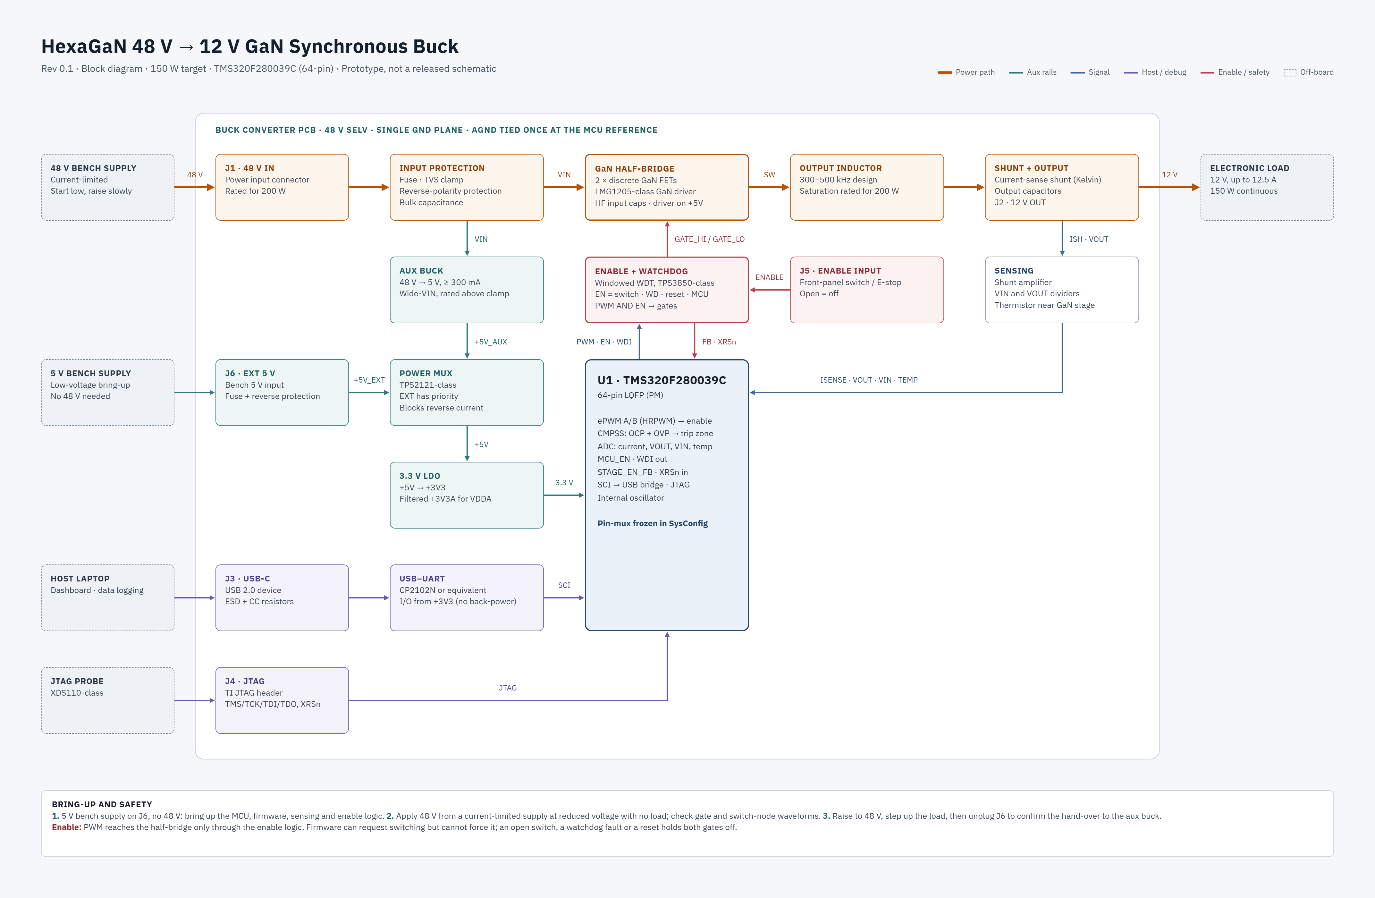
docs/gan-buck-converter-block-diagram.png
