HexaGaN-org/gan-buck-converter/simulations/ltspice/output/ngspice_02_edges.png

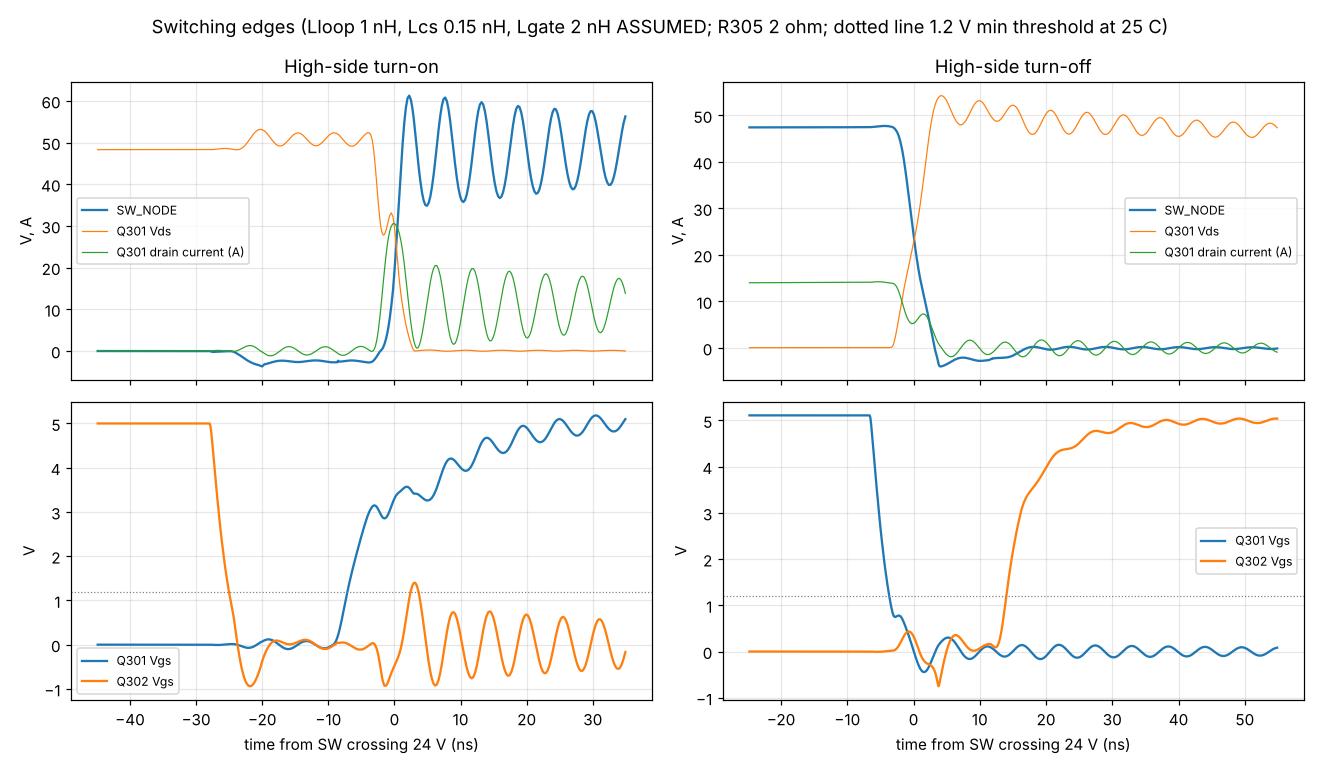
simulations/ltspice/output/ngspice_02_edges.png
