HexaGaN-org/gan-buck-converter/docs/gan-buck-converter-BOM.xlsx

Sheet: input_supply
input_supply — sheets/input_supply.kicad_sch (page 2): 48 V input, protection and aux rails
Cost and notes, one row per unique part (fill the yellow cells). The KiCad symbol fields (MPN, LCSC number, footprint) are the record of what is on the board: refresh this tab from a KiCad BOM export whenever the sheet's parts change. Reference designators on this sheet use the 200 range. Line number and extended cost fill in automatically.
Line | Ref Des | Qty / board | Description | Value / Rating | Package / Footprint | Manufacturer | MPN | LCSC # | JLC Part Type | Unit Cost (USD) | Ext. Cost / board (USD) | Assembly | Status | Notes
 | C201 | 1 | LM5164 bootstrap capacitor | 2.2 nF, 50 V, X7R | 0603 | FH (Guangdong Fenghua Advanced Tech) | 0603B222K500NT | C1604 | Basic | $0.0109 |  | JLC | Selected | Must be 2.2 nF (LM5164 datasheet). Decision #11
 | C202 | 1 | LM5164 Type-3 ripple injection, CA | 1 nF, 50 V, X7R | 0603 | Samsung Electro-Mechanics | CL10B102KB8NNNC | C1588 | Basic | $0.0098 |  | JLC | Selected | Decision #11
 | C203 | 1 | Input bulk and hot-plug damping capacitor | 100 µF, 100 V, 1.04 A rms | SMD Ø10 × 14.5 mm | Ymin | VKME1452A101MV | C487440 | Extended | $0.3481 |  | JLC | Selected | Decisions #8, #29. 1.04 A rms rating vs 0.68 A modeled worst case
 | C204 | 1 | LM5164 Type-3 ripple injection, CB | 100 pF, 50 V, C0G | 0603 | Samsung Electro-Mechanics | CL10C101JB8NNNC | C14858 | Basic | $0.0083 |  | JLC | Selected | Decision #11
 | C205, C213, C214 | 3 | LM5164 output (C205); mux IN1 (C213) and OUT (C214) | 22 µF, 25 V, X5R | 1206 | Samsung Electro-Mechanics | CL31A226KAHNNNE | C12891 | Basic | $0.1176 |  | JLC | Selected | Same part as power_stage output ceramics. Decisions #11, #13
 | C206–C210 | 5 | LM5164 input | 2.2 µF, 100 V, X7R | 1206 | Samsung Electro-Mechanics | CL31B225KCHSNNE | C170101 | Extended | $0.1185 |  | JLC | Selected | Same part as power_stage input bank
 | C211 | 1 | LDO input | 1 µF, 50 V, X5R | 0603 | Samsung Electro-Mechanics | CL10A105KB8NNNC | C15849 | Basic | $0.0140 |  | JLC | Selected | Decision #18
 | C212 | 1 | LDO output | 10 µF, 25 V, X5R | 0603 | Samsung Electro-Mechanics | CL10A106MA8NRNC | C96446 | Basic | $0.0352 |  | JLC | Selected | Decision #18
 | C215 | 1 | Mux soft-start (SS) | 100 nF, 50 V, X7R | 0603 | YAGEO | CC0603KRX7R9BB104 | C14663 | Basic | $0.0067 |  | JLC | Selected | Decision #13
 | D201 | 1 | Input TVS, bidirectional | SMBJ51CA, 51 V standoff, 82.4 V clamp, 600 W | SMB | hongjiacheng | SMBJ51CA | C41376101 | Preferred Extended | $0.0470 |  | JLC | Selected | Decisions #2, #5
 | D202 | 1 | Q201 gate clamp zener | 12 V, 350 mW | SOD-123 | hongjiacheng | BZT52C12 | C19077410 | Preferred Extended | $0.0169 |  | JLC | Selected | Decision #6
 | F201 | 1 | Input fuse, fast-acting | 7 A, 125 V DC | 2410 | Littelfuse | 0451007.MRL | C99548 | Extended | $0.2493 |  | JLC | Selected | Decision #7
 | J201 | 1 | 48 V input connector, screw terminal | 2-pin, 32 A, 6.35 mm pitch | THT | Cixi Kefa Elec | KF635-6.35-2P | C475102 | Extended | $0.2078 |  | JLC | Selected | Through-hole: JLCPCB hand-solders it. Same part as J301. Decision #3
 | J202 | 1 | 5 V bring-up input, keyed header | 2-pin, 3 A, 2.5 mm pitch | THT | JST | B2B-XH-A(LF)(SN) | C158012 | Extended | $0.0409 |  | JLC | Selected | Through-hole: JLCPCB hand-solders it. Decision #14
 | L201 | 1 | LM5164 inductor, shielded | 47 µH, 2 A Isat, 177 mΩ | 8 × 8 mm | cjiang (Changjiang Microelectronics Tech) | FNR8040S470MT | C168137 | Extended | $0.1289 |  | JLC | Selected | Decision #11
 | LED201 | 1 | 48V indicator LED, red | Red, 1.6–2.6 V | 0805 | Foshan NationStar Optoelectronics | NCD0805R1 | C84256 | Basic | $0.0131 |  | JLC | Selected | See design/indicator-leds.md
 | LED202 | 1 | POWER indicator LED, green | Green | 0805 | Hubei KENTO Elec | KT-0805G | C2297 | Basic | $0.0164 |  | JLC | Selected | See design/indicator-leds.md
 | LED203 | 1 | EXT 5V indicator LED, white | White, 2.6–3.2 V | 0805 | Hubei KENTO Elec | KT-0805W | C34499 | Basic | $0.0198 |  | JLC | Selected | See design/indicator-leds.md
 | Q201 | 1 | Reverse-polarity FET, low side (J201 return) | N-ch 100 V, 7 mΩ, 90 A | TDSON-8 5 × 6 mm | Infineon Technologies | BSC070N10NS3G | C501502 | Extended | $0.6036 |  | JLC | Selected | Decision #6
 | Q202 | 1 | J202 reverse-polarity FET, high side | P-ch 30 V, 60 mΩ at 4.5 V | SOT-23 | Alpha & Omega Semicon | AO3401A | C15127 | Basic | $0.0962 |  | JLC | Selected | Decision #15
 | R201 | 1 | Input current-sense shunt, high side | 1 mΩ, 1 %, 3 W | 2512 | FOJAN | FPM253WFR001TML | C7420016 | Extended | $0.0645 |  | JLC | Selected | Same part as power_stage R301, so no extra loading fee. Kelvin pair I_SH_IN_P / I_SH_IN_N. Decision #17
 | R202–R204 | 3 | Q201 gate pull-up (R202); 48V LED resistors in parallel (R203, R204) | 100 kΩ, 1 %, 250 mW, 200 V | 1206 | UNI-ROYAL(Uniroyal Elec) | 1206W4F1003T5E | C17900 | Basic | $0.0096 |  | JLC | Selected | 1206 for voltage rating. Decision #6
 | R205 | 1 | LM5164 Type-3 ripple injection, RA | 300 kΩ, 1 %, 150 V | 0805 | UNI-ROYAL(Uniroyal Elec) | 0805W8F3003T5E | C17616 | Preferred Extended | $0.0072 |  | JLC | Selected | 0805 for voltage rating. Decision #11
 | R206 | 1 | LM5164 feedback, top | 470 kΩ, 1 % | 0603 | UNI-ROYAL(Uniroyal Elec) | 0603WAF4703T5E | C23178 | Basic | $0.0030 |  | JLC | Selected | Decision #11
 | R207, R216 | 2 | LM5164 RON (R207); mux OV1 divider bottom (R216) | 20 kΩ, 1 % | 0603 | UNI-ROYAL(Uniroyal Elec) | 0603WAF2002T5E | C4184 | Basic | $0.0021 |  | JLC | Selected | Decisions #11, #13
 | R208 | 1 | LM5164 feedback, bottom | 150 kΩ, 1 % | 0603 | UNI-ROYAL(Uniroyal Elec) | 0603WAF1503T5E | C22807 | Basic | $0.0017 |  | JLC | Selected | Decision #11
 | R209 | 1 | POWER LED resistor | 330 Ω, 1 % | 0603 | UNI-ROYAL(Uniroyal Elec) | 0603WAF3300T5E | C23138 | Basic | $0.0020 |  | JLC | Selected | See design/indicator-leds.md
 | R210 | 1 | Mux PR1/OV1 divider, top | 75 kΩ, 1 % | 0603 | UNI-ROYAL(Uniroyal Elec) | 0603WAF7502T5E | C23242 | Basic | $0.0021 |  | JLC | Selected | Decision #13
 | R211 | 1 | EXT 5V LED resistor | 2.2 kΩ, 1 % | 0603 | UNI-ROYAL(Uniroyal Elec) | 0603WAF2201T5E | C4190 | Basic | $0.0018 |  | JLC | Selected | See design/indicator-leds.md
 | R212 | 1 | Mux CP2 divider, top | 26.1 kΩ, 1 % | 0603 | UNI-ROYAL(Uniroyal Elec) | 0603WAF2612T5E | C23356 | Extended | $0.0018 |  | JLC | Selected | Decision #28: 26.1 kΩ so healthy aux takes over before J202 is unplugged
 | R213 | 1 | Mux PR1/OV1 divider, middle | 8.2 kΩ, 1 % | 0603 | UNI-ROYAL(Uniroyal Elec) | 0603WAF8201T5E | C25981 | Basic | $0.0035 |  | JLC | Selected | Decision #13
 | R214 | 1 | Mux current limit (ILM) | 100 kΩ, 1 % | 0603 | UNI-ROYAL(Uniroyal Elec) | 0603WAF1003T5E | C25803 | Basic | $0.0029 |  | JLC | Selected | ≈ 1.24 A. Decision #13
 | R215 | 1 | Mux CP2 divider, bottom | 10 kΩ, 1 % | 0603 | UNI-ROYAL(Uniroyal Elec) | 0603WAF1002T5E | C25804 | Basic | $0.0024 |  | JLC | Selected | Decision #13
 | U201 | 1 | Aux regulator, 100 V 1 A synchronous buck | LM5164, 5 V out, ≈ 620 kHz | SO-8 PowerPAD | Texas Instruments | LM5164DDAR | C477928 | Extended | $2.5667 |  | JLC | Selected | Decisions #10, #11
 | U202 | 1 | 3.3 V LDO | 1.2 A, 350 mV dropout, 20 V abs max | SOT-223 | STMicroelectronics | LDL1117S33R | C435835 | Extended | $0.4956 |  | JLC | Selected | Tab = VOUT. Decision #18
 | U203 | 1 | Power mux, 2 inputs, fast switchover | 2.8–22 V, 56 mΩ, OV cutoff | VQFN-HR-12 2 × 2.5 mm | Texas Instruments | TPS2121RUXR | C485916 | Extended | $0.9185 |  | JLC | Selected | Decisions #12, #13
 | Sheet total |  |  |  |  |  |  |  |  | Cost / board

Sheet: power_stage
power_stage — sheets/power_stage.kicad_sch (page 3): GaN FETs, gate driver, inductor, output
Cost and notes, one row per unique part (fill the yellow cells). The KiCad symbol fields (MPN, LCSC number, footprint) are the record of what is on the board: refresh this tab from a KiCad BOM export whenever the sheet's parts change. Reference designators on this sheet use the 300 range. Line number and extended cost fill in automatically.
Line | Ref Des | Qty / board | Description | Value / Rating | Package / Footprint | Manufacturer | MPN | LCSC # | JLC Part Type | Unit Cost (USD) | Ext. Cost / board (USD) | Assembly | Status | Notes
 | C301–C303 | 3 | Input ceramic, main bank | 10 µF, 100 V, X7S | 1210 | Samsung Electro-Mechanics | CL32Y106KCV6PNE | C22380050 | Extended | $0.8807 |  | JLC | Selected | Decision #24; 8.12 µF typical at 48 V with the four 100 nF parts (5.9 µF needed at 400 kHz). Exact-part bias and ripple-current data pending
 | C304–C307 | 4 | Input ceramic, closest to FETs (power loop) | 100 nF, 100 V, X7R | 0603 | Samsung Electro-Mechanics | CL10B104KC8NNNC | C15725 | Extended | $0.0138 |  | JLC | Selected | Decision #22; 42 % typical at 48 V
 | C308, C309 | 2 | Output ceramic | 22 µF, 25 V, X5R | 1206 | Samsung Electro-Mechanics | CL31A226KAHNNNE | C12891 | Basic | $0.1198 |  | JLC | Selected | 26 % kept at 12 V (Samsung data). High-frequency bypass beside the polymers. Decision #24
 | C311, C313 | 2 | Bootstrap capacitor (C313); driver VDD bypass at pins (C311) | 100 nF, 50 V, X7R | 0603 | YAGEO | CC0603KRX7R9BB104 | C14663 | Basic | $0.0083 |  | JLC | Selected | Decision #5
 | C312 | 1 | Driver VDD bypass, bulk | 10 µF, 25 V, X5R | 0603 | Samsung Electro-Mechanics | CL10A106MA8NRNC | C96446 | Basic | $0.0352 |  | JLC | Selected | Decision #16
 | C314, C315 | 2 | HI / LI input-filter capacitors | 22 pF, 50 V, C0G | 0603 | Samsung Electro-Mechanics | CL10C220JB8NNNC | C1653 | Basic | $0.0089 |  | JLC | Selected | Datasheet Figure 16
 | C316, C317 | 2 | Output bulk, polymer | 270 µF, 16 V, 10 mΩ | SMD D6.3 × 7.7 mm | NCC(Nippon Chemi-Con) | APXJ160ARA271MF80J | C2944013 | Extended | $0.4000 |  | JLC | Selected | Carries the output ripple and the load step; pad 1 positive. 10 mΩ max ESR, 5.08 A rms ripple at 105 °C / 100 kHz (NCC PXJ catalog). Decision #24
 | D301 | 1 | External bootstrap diode, VDD → HB | 100 V Schottky | SOD-123 | hongjiacheng | BAT46W | C7420332 | Preferred Extended | $0.0206 |  | JLC | Selected | Required by LM5113-Q1 datasheet 7.3.2. Check symbol pin 1 = cathode
 | J301 | 1 | 12 V output connector, screw terminal | 2-pin, 32 A, 6.35 mm pitch | THT | Cixi Kefa Elec | KF635-6.35-2P | C475102 | Extended | $0.2078 |  | JLC | Selected | Through-hole: JLCPCB hand-solders it. Decision #12
 | L301 | 1 | Output inductor | 6.8 µH ±20 %, 31 A Isat, 2.1 mΩ | SMD 22.5 × 22 mm | Sunltech Tech | SLB2212P6R8MTT | C2842794 | Extended | $2.7208 |  | JLC | Selected | Decision #8
 | LED301 | 1 | 12V indicator LED, green | Green | 0805 | Hubei KENTO Elec | KT-0805G | C2297 | Basic | $0.0164 |  | JLC | Selected | See design/indicator-leds.md
 | Q301, Q302 | 2 | GaN FET, enhancement mode, 100 V | 100 V, 3.3 mΩ max | PG-TSON-6, 3 × 5 mm | Infineon Technologies | IGC033S10S1 | C41381300 | Extended | $3.4638 |  | JLC | Selected | Same part high and low side. Unit cost: LCSC 10+ tier, Nov 2026
 | R301 | 1 | Current-sense shunt, in series with L301 | 1 mΩ, 1 %, 3 W | 2512 | FOJAN | FPM253WFR001TML | C7420016 | Extended | $0.0645 |  | JLC | Selected | Kelvin pair I_SH_OUT_P / I_SH_OUT_N. Decision #11
 | R302 | 1 | 12V LED resistor | 10 kΩ, 1 % | 0603 | UNI-ROYAL(Uniroyal Elec) | 0603WAF1002T5E | C25804 | Basic | $0.0024 |  | JLC | Selected | See design/indicator-leds.md
 | R304 | 1 | Bootstrap series resistor | 100 Ω, 1 % | 0603 | UNI-ROYAL(Uniroyal Elec) | 0603WAF1000T5E | C22775 | Basic | $0.0023 |  | JLC | Selected | Datasheet 7.3.2
 | R305 | 1 | High-side turn-on gate resistor (HOH) | 2 Ω, 1 % | 0603 | UNI-ROYAL(Uniroyal Elec) | 0603WAF200KT5E | C22977 | Basic | $0.0022 |  | JLC | Selected | Tune 0–4.7 Ω on the bench (verification test 6)
 | R306, R307 | 2 | HI / LI input-filter resistors | 1 kΩ, 1 % | 0603 | UNI-ROYAL(Uniroyal Elec) | 0603WAF1001T5E | C21190 | Basic | $0.0017 |  | JLC | Selected | Datasheet Figure 16
 | U301 | 1 | GaN half-bridge gate driver | 90 V (HS), 5 V supply, 5.2 V bootstrap clamp | WSON-10, 4 × 4 mm | Texas Instruments | LM5113QDPRRQ1 | C2677036 | Extended | $4.2985 |  | JLC | Selected | LM5113-Q1. Unit cost: LCSC 1+ tier, Nov 2026
 | R303, C310 | 2 | Switch-node RC snubber | Values from the measured ringing | 1206 | — | — |  | DNP |  |  | DNP | TBD | Not fitted; footprints only. Power-stage test 13 sets the values
 | Sheet total |  |  |  |  |  |  |  |  | Cost / board

Sheet: sensing
sensing — sheets/sensing.kicad_sch (page 4): Current, voltage and temperature sensing
Cost and notes, one row per unique part (fill the yellow cells). The KiCad symbol fields (MPN, LCSC number, footprint) are the record of what is on the board: refresh this tab from a KiCad BOM export whenever the sheet's parts change. Reference designators on this sheet use the 400 range. Line number and extended cost fill in automatically.
Line | Ref Des | Qty / board | Description | Value / Rating | Package / Footprint | Manufacturer | MPN | LCSC # | JLC Part Type | Unit Cost (USD) | Ext. Cost / board (USD) | Assembly | Status | Notes
 | C401–C403, C407–C414 | 11 | Op-amp / INA241 bypass, REF1 bypass, RC filters | 100 nF, 50 V, X7R | 0603 | YAGEO | CC0603KRX7R9BB104 | C14663 | Basic | $0.0067 |  | JLC | Selected
 | C404, C405 | 2 | V_OUT / V_IN sense RC filters | 1 nF, 50 V, X7R | 0603 | Samsung Electro-Mechanics | CL10B102KB8NNNC | C1588 | Basic | $0.0098 |  | JLC | Selected
 | C406 | 1 | I_OUT sense output RC filter | 22 pF, 50 V, C0G | 0603 | Samsung Electro-Mechanics | CL10C220JB8NNNC | C1653 | Basic | $0.0089 |  | JLC | Selected
 | D401, D402 | 2 | Output clamps on the two INA241 channels | 30 V, 200 mA, series pair | SOT-23 | Nexperia | BAT54S,215 | C47546 | Extended | $0.0223 |  | JLC | Selected
 | R401, R402 | 2 | V_OUT / V_IN divider, top | 750 kΩ, 1 %, 200 V | 1206 | UNI-ROYAL(Uniroyal Elec) | 1206W4F7503T5E | C25835 | Extended | $0.0044 |  | JLC | Selected
 | R403, R404, R407, R411, R412, R416 | 6 | Sense-channel RC filter resistors | 1 kΩ, 1 % | 0603 | UNI-ROYAL(Uniroyal Elec) | 0603WAF1001T5E | C21190 | Basic | $0.0017 |  | JLC | Selected
 | R405 | 1 | V_OUT divider, bottom | 150 kΩ, 1 % | 0603 | UNI-ROYAL(Uniroyal Elec) | 0603WAF1503T5E | C22807 | Basic | $0.0017 |  | JLC | Selected
 | R406, R408, R413 | 3 | V_IN divider bottom (R406); RTD amplifier feedback (R408, R413) | 20 kΩ, 1 % | 0603 | UNI-ROYAL(Uniroyal Elec) | 0603WAF2002T5E | C4184 | Basic | $0.0021 |  | JLC | Selected
 | R409, R414 | 2 | RTD amplifier gain-set | 4.02 kΩ, 1 % | 0603 | UNI-ROYAL(Uniroyal Elec) | 0603WAF4021T5E | C23040 | Extended | $0.0018 |  | JLC | Selected
 | R410, R415 | 2 | RTD bias from +3V3 | 10 kΩ, 1 % | 0603 | UNI-ROYAL(Uniroyal Elec) | 0603WAF1002T5E | C25804 | Basic | $0.0024 |  | JLC | Selected
 | U401, U402, U404, U407 | 4 | Divider buffers and RTD amplifiers | 10 MHz RRIO op-amp | SOT-23-5 | Texas Instruments | TLV9061IDBVR | C398358 | Extended | $0.0931 |  | JLC | Selected
 | U403, U405 | 2 | Current-sense amplifiers, I_OUT and I_IN | Gain 50 V/V, −5 to 110 V CM | SOT-23-8 | Texas Instruments | INA241A3IDDFR | C6051860 | Extended | $3.7849 |  | JLC | Selected
 | U406, U408 | 2 | FET temperature sensors (Pt1000 RTD) | 1 kΩ Pt RTD, class F0.3 | 1206 | Vishay Intertech | PTS120601B1K00P100 | C141528 | Extended | $3.1961 |  | JLC | Selected
 | Sheet total |  |  |  |  |  |  |  |  | Cost / board

Sheet: mcu
mcu — sheets/mcu.kicad_sch (page 5): Microcontroller (U1) and support
Cost and notes, one row per unique part (fill the yellow cells). The KiCad symbol fields (MPN, LCSC number, footprint) are the record of what is on the board: refresh this tab from a KiCad BOM export whenever the sheet's parts change. Reference designators on this sheet use the 500 range. Line number and extended cost fill in automatically.
Line | Ref Des | Qty / board | Description | Value / Rating | Package / Footprint | Manufacturer | MPN | LCSC # | JLC Part Type | Unit Cost (USD) | Ext. Cost / board (USD) | Assembly | Status | Notes
 | C501 | 1 | VREFHI capacitor | 2.2 µF, 10 V, X7R | 0603 | Murata Electronics | GRM188R71A225KE15D | C86018 | Extended | $0.0300 |  | JLC | Selected | JLC stock 4 (min. order 370) on 2026-11-12: find an alternative or pre-order
 | C502 | 1 | XRSn reset filter | 22 nF, 50 V, X7R | 0603 | Samsung Electro-Mechanics | CL10B223KB8NNNC | C21122 | Basic | $0.0056 |  | JLC | Selected
 | C503, C504 | 2 | Crystal load capacitors | 18 pF, 50 V, C0G | 0603 | Samsung Electro-Mechanics | CL10C180JB8NNNC | C1647 | Basic | $0.0137 |  | JLC | Selected
 | Cvdd501–Cvdd504, Cvdda501 | 5 | VDD core and VDDA decoupling | 4.7 µF, 6.3 V, X7R | 0603 | Samsung Electro-Mechanics | CL10B475KQ8NQNC | C107368 | Extended | $0.0398 |  | JLC | Selected
 | Cvddio501–Cvddio503 | 3 | VDDIO decoupling | 220 nF, 25 V, X7R | 0603 | Samsung Electro-Mechanics | CL10B224KA8NNNC | C21120 | Basic | $0.0093 |  | JLC | Selected
 | LED501 | 1 | FAULT indicator LED, red | Red, 1.6–2.6 V | 0805 | Foshan NationStar Optoelectronics | NCD0805R1 | C84256 | Basic | $0.0131 |  | JLC | Selected
 | LED502 | 1 | HEARTBEAT indicator LED, green | Green | 0805 | Hubei KENTO Elec | KT-0805G | C2297 | Basic | $0.0164 |  | JLC | Selected
 | R501 | 1 | TMS pull-up | 2.2 kΩ, 1 % | 0603 | UNI-ROYAL(Uniroyal Elec) | 0603WAF2201T5E | C4190 | Basic | $0.0018 |  | JLC | Selected
 | R502 | 1 | XRSn pull-up | 4.7 kΩ, 5 % | 0603 | HKR(Hong Kong Resistors) | RCT034K7JLF | C177333 | Extended | $0.0015 |  | JLC | Selected
 | R503 | 1 | Crystal X2 series resistor (0 Ω, tunable) | 0 Ω | 0603 | UNI-ROYAL(Uniroyal Elec) | 0603WAJ0000T5E | C15402 | Extended | $0.0015 |  | JLC | Selected
 | R504–R507 | 4 | Boot-mode and TDI / TDO pull-ups | 10 kΩ, 5 % | 0603 | HKR(Hong Kong Resistors) | RCT0310KJLF | C177337 | Extended | $0.0014 |  | JLC | Selected
 | R508 | 1 | FAULT LED resistor | 1 kΩ, 1 % | 0603 | UNI-ROYAL(Uniroyal Elec) | 0603WAF1001T5E | C21190 | Basic | $0.0017 |  | JLC | Selected
 | R509 | 1 | HEARTBEAT LED resistor | 330 Ω, 1 % | 0603 | UNI-ROYAL(Uniroyal Elec) | 0603WAF3300T5E | C23138 | Basic | $0.0020 |  | JLC | Selected
 | U501 | 1 | Microcontroller, TMS320F280039C | C28x, 120 MHz, 384 KB flash | LQFP-64, 10 × 10 mm | Texas Instruments | F280039CSPMR | C20345419 | Extended | $7.3228 |  | JLC | Selected | JLC stock 199 on 2026-11-12
 | X501 | 1 | 16 MHz crystal | 16 MHz, 12 pF, ±20 ppm | HC-49S SMD | ZHUHAI MONEC ELEC | ESD16.0000F12M25F | C353726 | Extended | $0.0966 |  | JLC | Selected | JLC stock 8 on 2026-11-12: reserve before ordering
 | Sheet total |  |  |  |  |  |  |  |  | Cost / board

Sheet: enable
enable — sheets/enable.kicad_sch (page 6): Hardware enable and watchdog
Cost and notes, one row per unique part (fill the yellow cells). The KiCad symbol fields (MPN, LCSC number, footprint) are the record of what is on the board: refresh this tab from a KiCad BOM export whenever the sheet's parts change. Reference designators on this sheet use the 600 range. Line number and extended cost fill in automatically.
Line | Ref Des | Qty / board | Description | Value / Rating | Package / Footprint | Manufacturer | MPN | LCSC # | JLC Part Type | Unit Cost (USD) | Ext. Cost / board (USD) | Assembly | Status | Notes
 | C601 | 1 | Watchdog timing capacitor (WDT) | 220 pF, 50 V, C0G | 0603 | Samsung Electro-Mechanics | CL10C221JB8NNNC | C27675 | Extended | $0.0087 |  | JLC | Selected
 | C602–C606 | 5 | Logic and supervisor decoupling | 100 nF, 50 V, X7R | 0603 | YAGEO | CC0603KRX7R9BB104 | C14663 | Basic | $0.0083 |  | JLC | Selected
 | D601 | 1 | SUP_OK to XRSn diode | 100 V Schottky | SOD-123 | hongjiacheng | BAT46W | C7420332 | Preferred Extended | $0.0206 |  | JLC | Selected
 | LED601 | 1 | ARMED indicator LED, yellow | Yellow | 0805 | Hubei KENTO Elec | KT-0805Y | C2296 | Basic | $0.0149 |  | JLC | Selected
 | R601, R603, R604, R607–R611 | 8 | Request-line pull-downs, SUP_OK pull-up, switch pull-down | 10 kΩ, 1 % | 0603 | UNI-ROYAL(Uniroyal Elec) | 0603WAF1002T5E | C25804 | Basic | $0.0024 |  | JLC | Selected
 | R602 | 1 | SUP_OK to XRSn link (remove to isolate the watchdog for JTAG) | 0 Ω | 0603 | UNI-ROYAL(Uniroyal Elec) | 0603WAJ0000T5E | C15402 | Extended | $0.0015 |  | JLC | Selected
 | R605, R606, R612 | 3 | STAGE_EN_FB, switch series and ARMED LED resistors | 1 kΩ, 1 % | 0603 | UNI-ROYAL(Uniroyal Elec) | 0603WAF1001T5E | C21190 | Basic | $0.0017 |  | JLC | Selected
 | SW601 | 1 | Enable slide switch | SPDT, 50 mA | SMD, 8 × 2.8 mm | SHOU HAN | MSK12C02 | C431540 | Extended | $0.0544 |  | JLC | Selected
 | U601 | 1 | Supervisor with watchdog | 2.93 V, watchdog, open drain | SOT-23-6 | Texas Instruments | TPS3813K33DBVR | C93238 | Extended | $1.9334 |  | JLC | Selected
 | U602–U604 | 3 | Enable gating, dual AND | Dual 2-input AND | VSSOP-8 | Texas Instruments | SN74LVC2G08DCUR | C91875 | Extended | $0.5184 |  | JLC | Selected
 | U605 | 1 | Both-high inhibit, NAND | Single 2-input NAND | SOT-23-5 | Texas Instruments | SN74LVC1G00DBVR | C7826 | Extended | $0.2456 |  | JLC | Selected
 | Sheet total |  |  |  |  |  |  |  |  | Cost / board

Sheet: comms_debug
comms_debug — sheets/comms_debug.kicad_sch (page 7): USB serial and JTAG
Cost and notes, one row per unique part (fill the yellow cells). The KiCad symbol fields (MPN, LCSC number, footprint) are the record of what is on the board: refresh this tab from a KiCad BOM export whenever the sheet's parts change. Reference designators on this sheet use the 700 range. Line number and extended cost fill in automatically.
Line | Ref Des | Qty / board | Description | Value / Rating | Package / Footprint | Manufacturer | MPN | LCSC # | JLC Part Type | Unit Cost (USD) | Ext. Cost / board (USD) | Assembly | Status | Notes
 | C701, C703, C706, C707 | 4 | CP2102N and USB decoupling | 100 nF, 50 V, X7R | 0603 | YAGEO | CC0603KRX7R9BB104 | C14663 | Basic | $0.0067 |  | JLC | Selected
 | C702, C704, C705 | 3 | CP2102N bulk decoupling | 4.7 µF, 6.3 V, X7R | 0603 | Samsung Electro-Mechanics | CL10B475KQ8NQNC | C107368 | Extended | $0.0398 |  | JLC | Selected
 | D701 | 1 | USB ESD protection | 2-line, 5.25 V | SOT-23-6 | STMicroelectronics | USBLC6-2SC6 | C7519 | Extended | $0.1567 |  | JLC | Selected
 | H701 | 1 | TI 20-pin JTAG header (1.27 mm) | 2 × 10, 1.27 mm pitch | SMD | Samtec | FTR-110-03-G-D-06-TR | C3332048 | Extended | $6.1860 |  | JLC | Selected | JLC stock 26 on 2026-11-12: reserve before ordering
 | R701, R705 | 2 | USB-C CC pull-downs | 5.1 kΩ, 1 % | 0603 | UNI-ROYAL(Uniroyal Elec) | 0603WAF5101T5E | C23186 | Basic | $0.0015 |  | JLC | Selected
 | R702 | 1 | CP2102N VBUS sense divider, top | 22.1 kΩ, 1 % | 0603 | UNI-ROYAL(Uniroyal Elec) | 0603WAF2212T5E | C25961 | Extended | $0.0019 |  | JLC | Selected
 | R703 | 1 | CP2102N VBUS sense divider, bottom | 47.5 kΩ, 1 % | 0603 | UNI-ROYAL(Uniroyal Elec) | 0603WAF4752T5E | C23061 | Extended | $0.0019 |  | JLC | Selected
 | R704 | 1 | JTAG pull-up (1.02 kΩ, 0.1 %) | 1.02 kΩ, 0.1 %, 25 ppm | 0603 | YAGEO | RT0603BRD071K02L | C705734 | Extended | $0.0537 |  | JLC | Selected
 | R706 | 1 | JTAG VTRef series resistor | 100 Ω, 1 % | 0603 | UNI-ROYAL(Uniroyal Elec) | 0603WAF1000T5E | C22775 | Basic | $0.0023 |  | JLC | Selected
 | R707, R708 | 2 | JTAG TMS / EMU pull-ups | 4.7 kΩ, 5 % | 0603 | HKR(Hong Kong Resistors) | RCT034K7JLF | C177333 | Extended | $0.0015 |  | JLC | Selected
 | U701 | 1 | USB-UART bridge | USB 2.0 to UART | QFN-24, 4 × 4 mm | SKYWORKS/SILICON LABS | CP2102N-A02-GQFN24R | C969151 | Extended | $1.9824 |  | JLC | Selected
 | USBC701 | 1 | USB-C receptacle | USB 2.0, 16-pin | SMD | Korean Hroparts Elec | TYPE-C-31-M-12 | C165948 | Extended | $0.1868 |  | JLC | Selected
 | Sheet total |  |  |  |  |  |  |  |  | Cost / board
