HexaGaN-org/gan-buck-converter/hardware/gan-buck-converter/gan-buck-converter.pdf

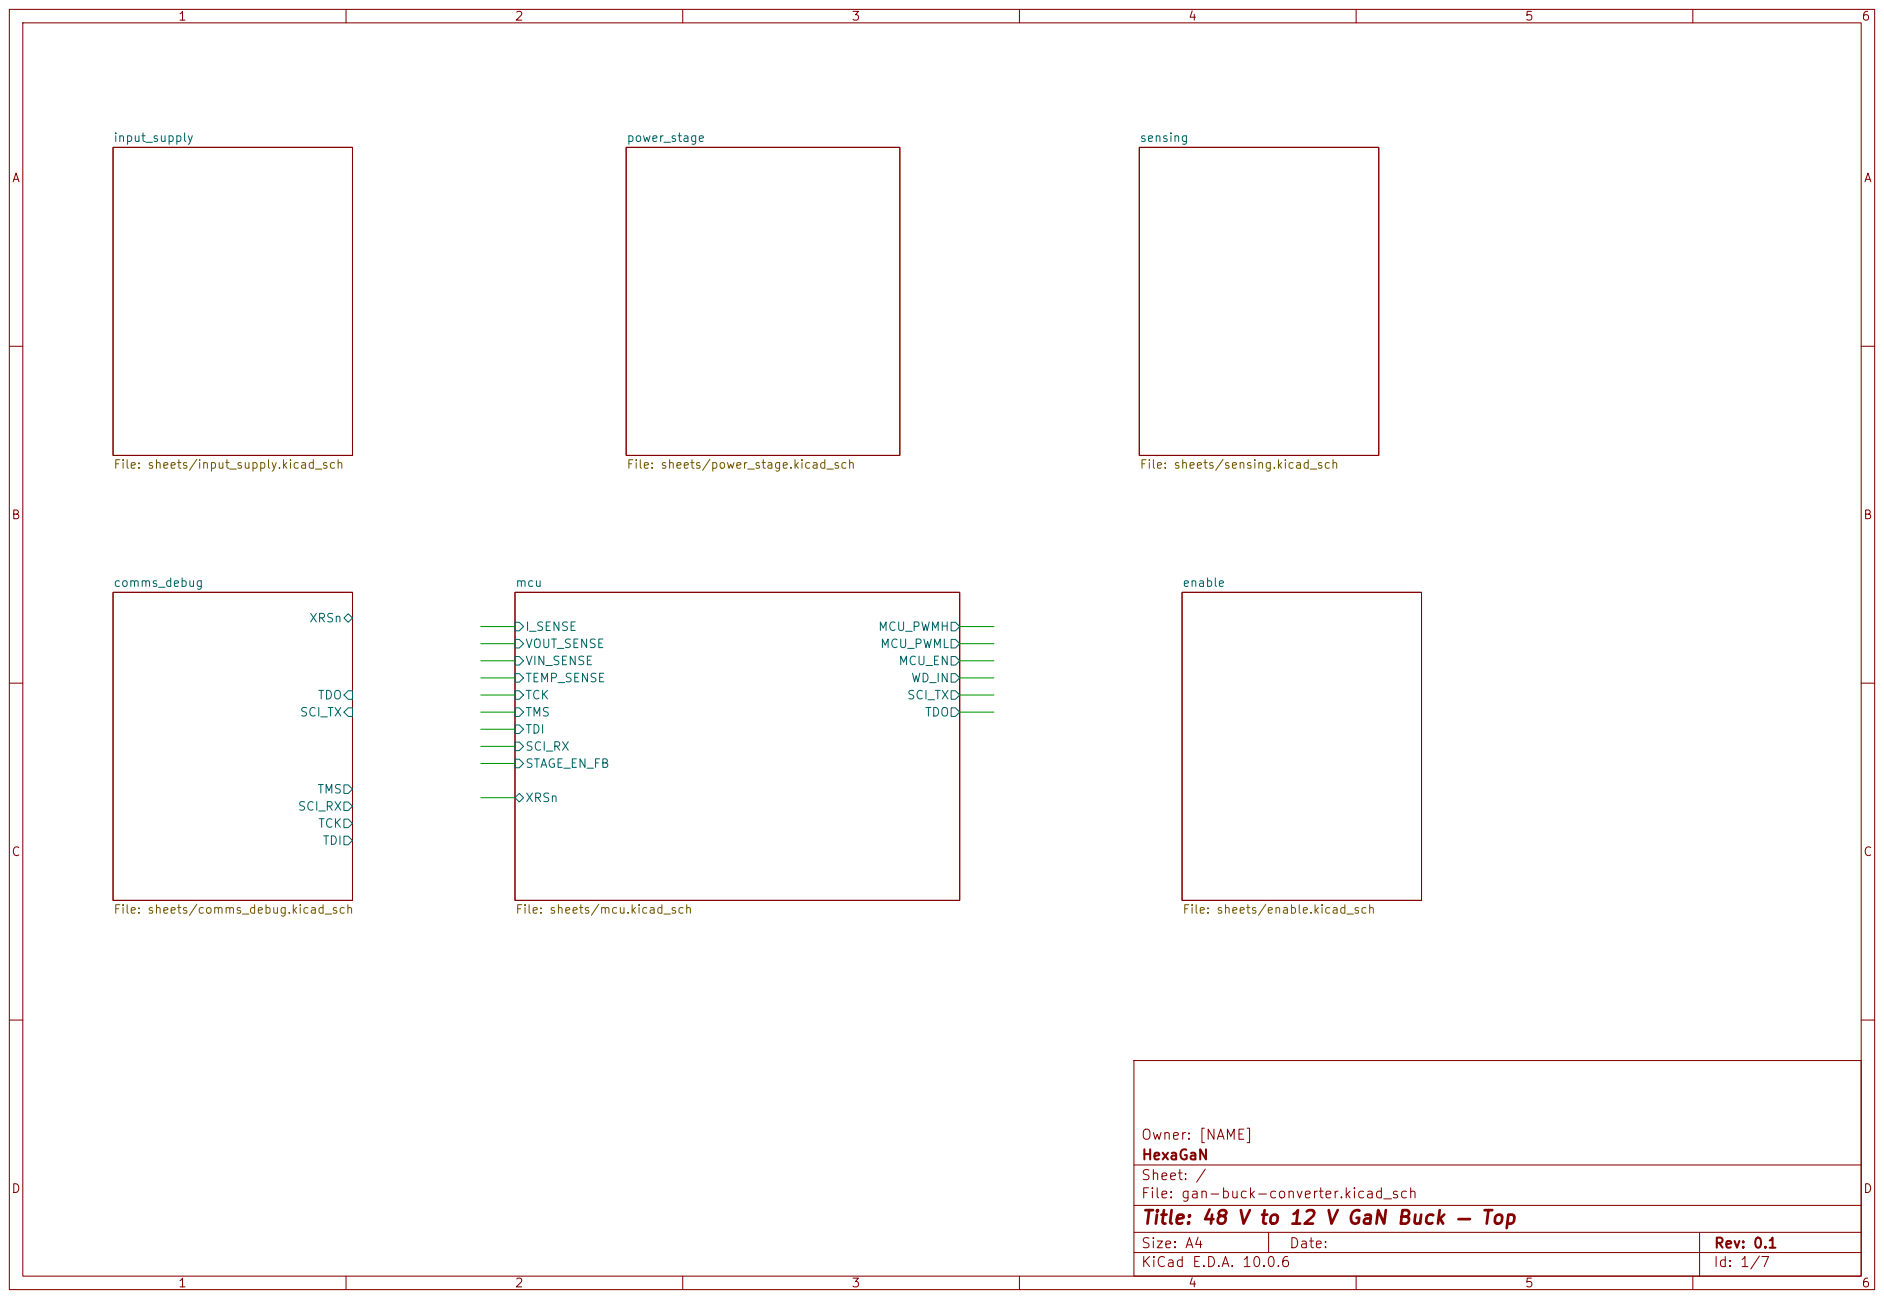
[picture p17: page 1]

Owner: [NAME]
HexaGaN
Sheet: /
File: gan-buck-converter.kicad_sch
Title: 48 V to 12 V GaN Buck — Top

Size: A4 | Rev: 0.1
KiCad E.D.A. 10.0.6 | Id: 1/7

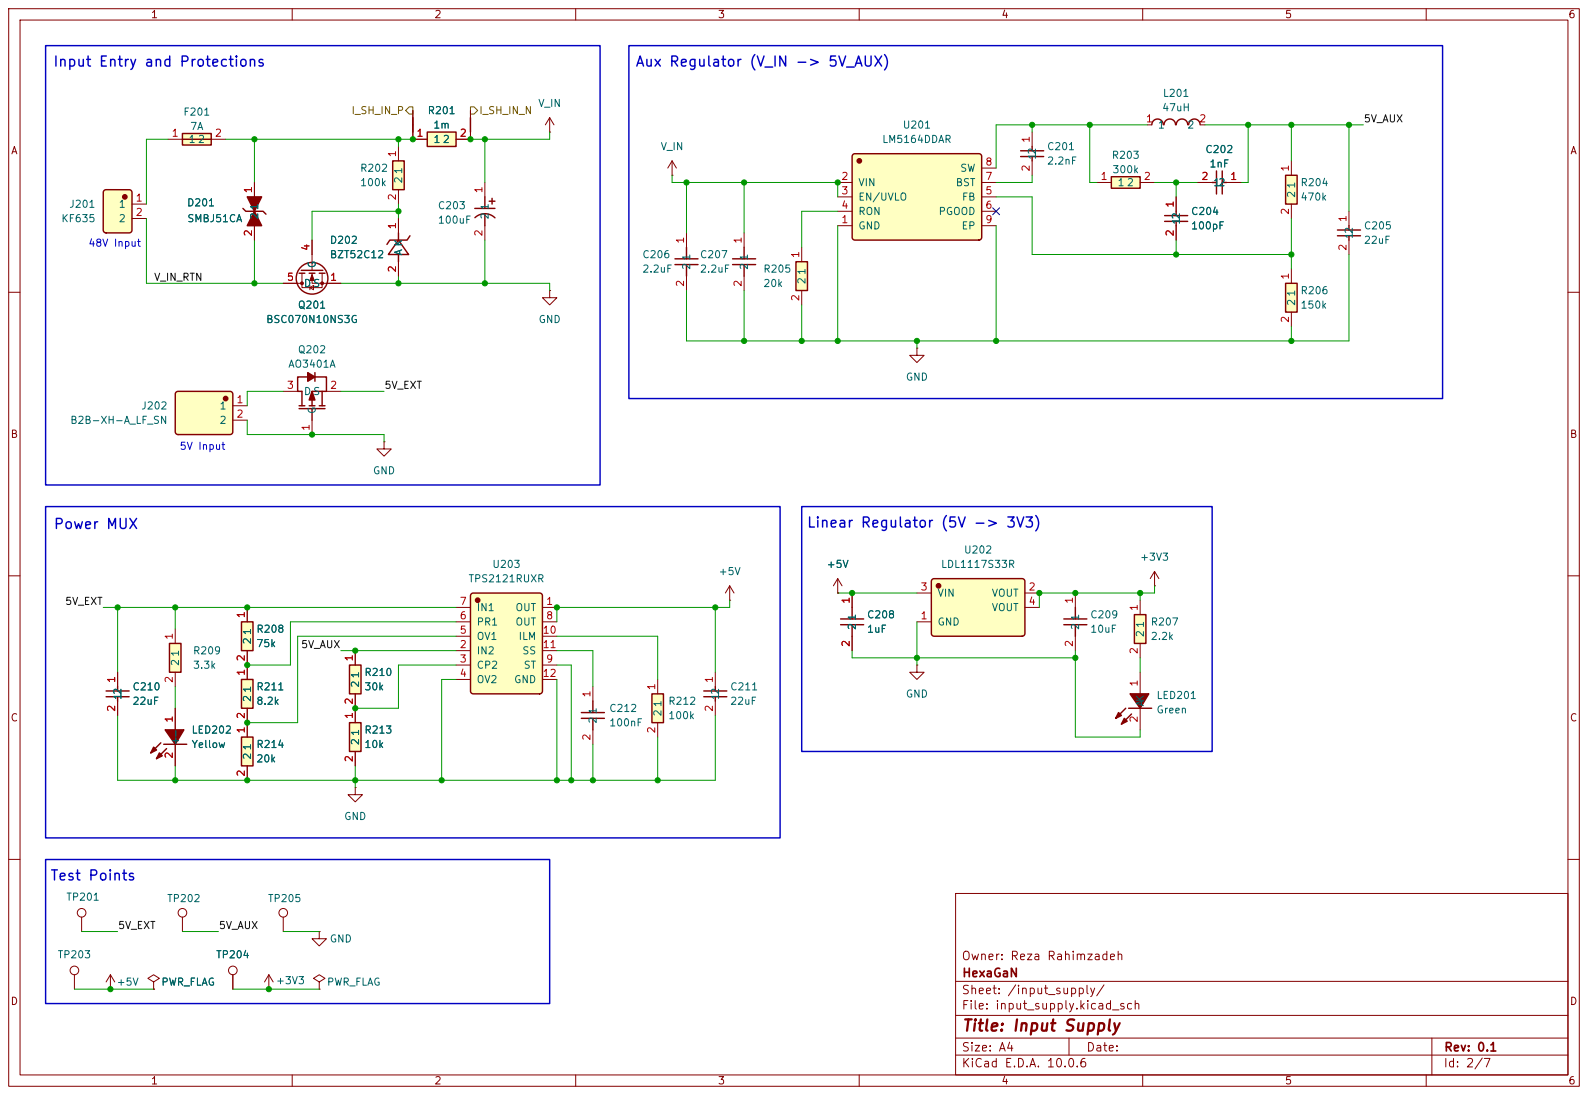
[picture p18: page 2]

Aux Regulator (V_IN -> 5V_AUX) 48V Input
Input Entry and Protections

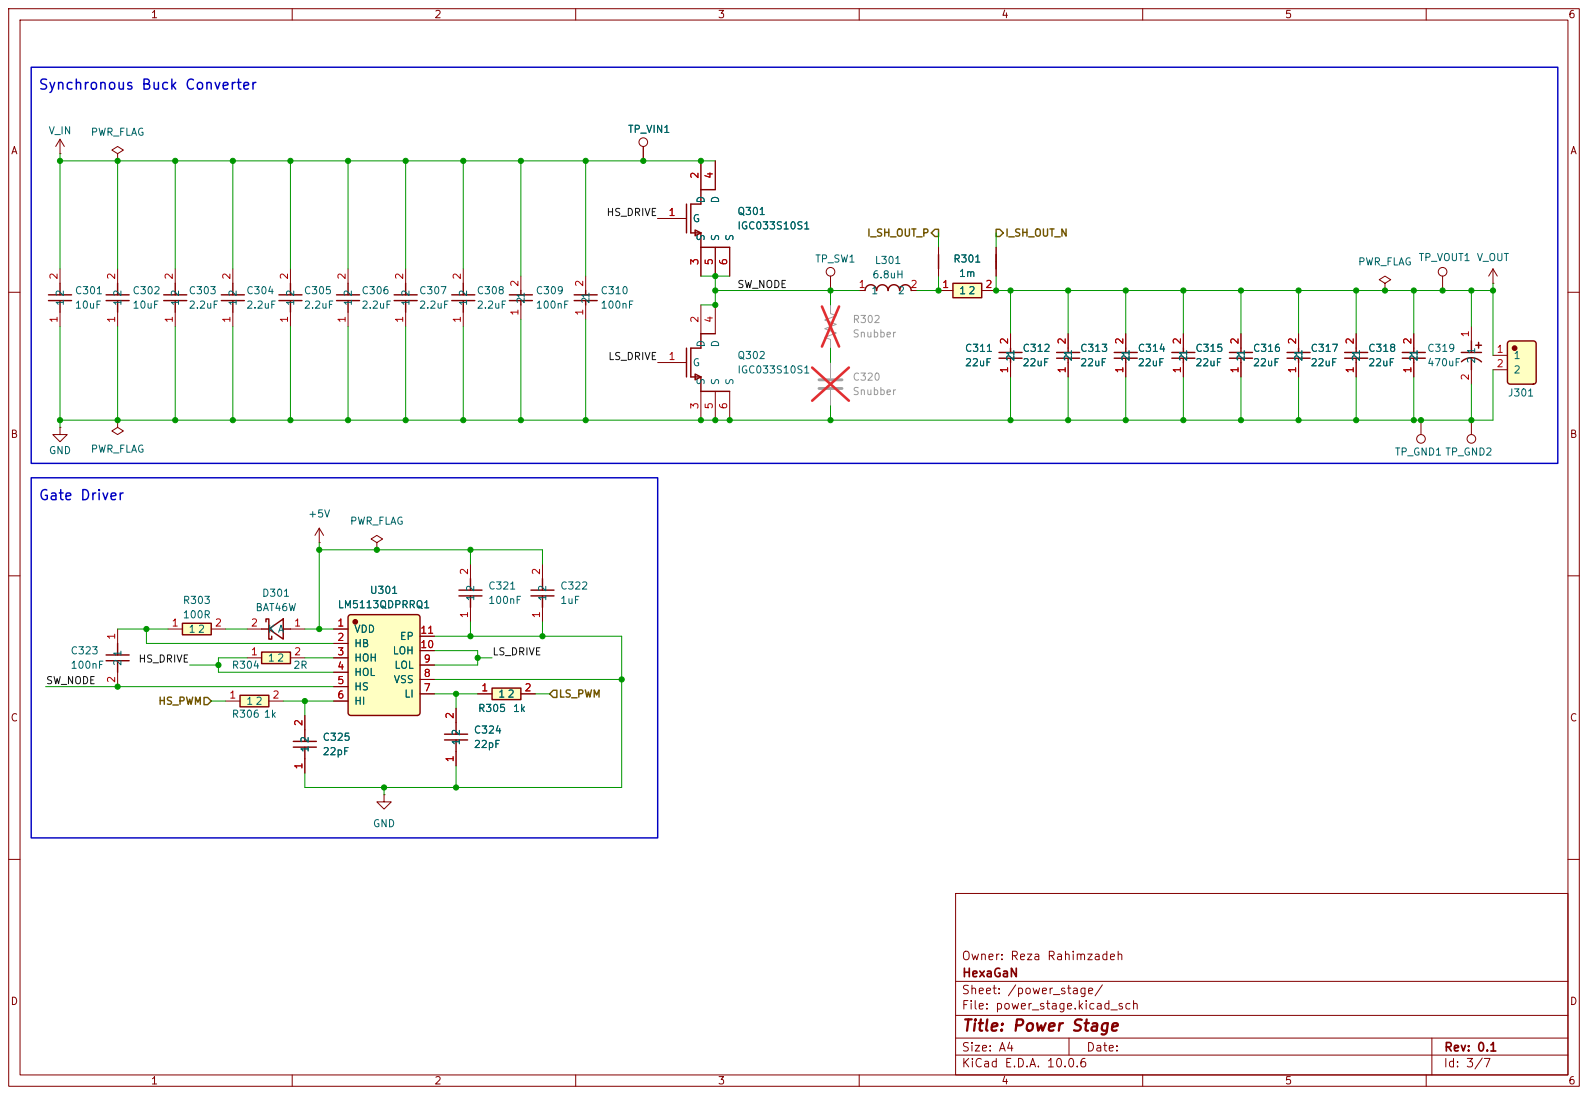
[picture p19: page 3]

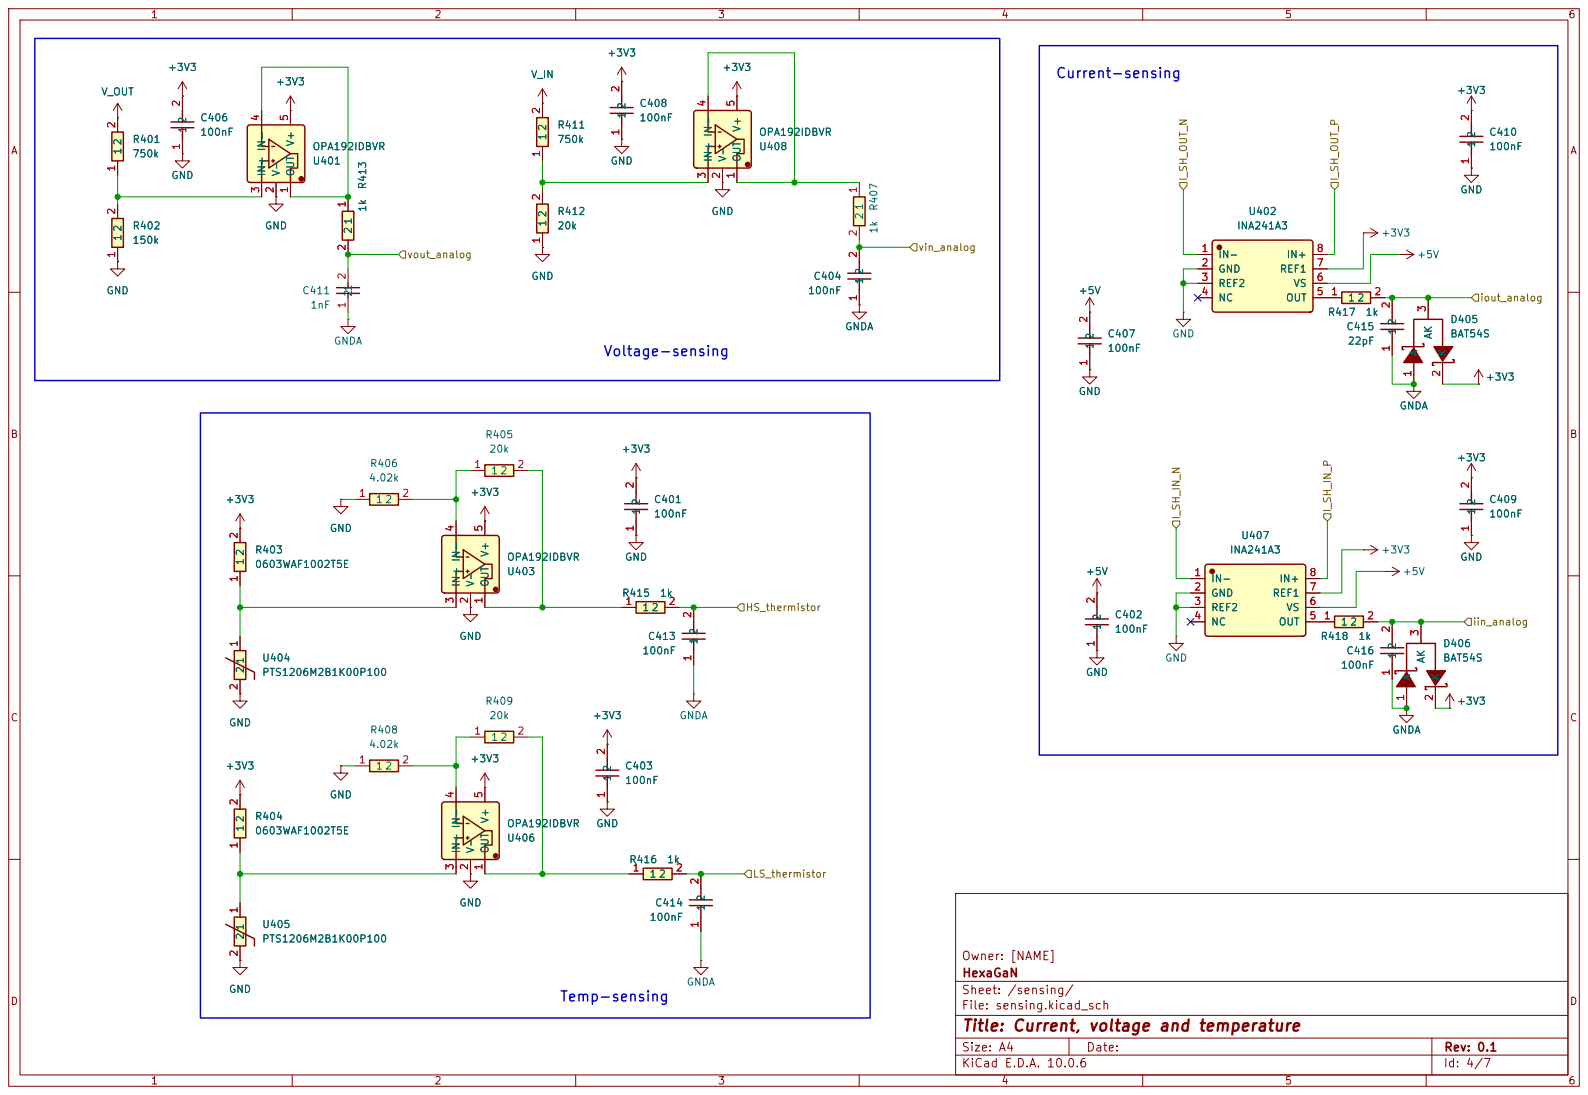
[picture p20: page 4]

Owner: [NAME]
HexaGaN
Sheet: /sensing/
File: sensing.kicad_sch
Title: Current, voltage and temperature

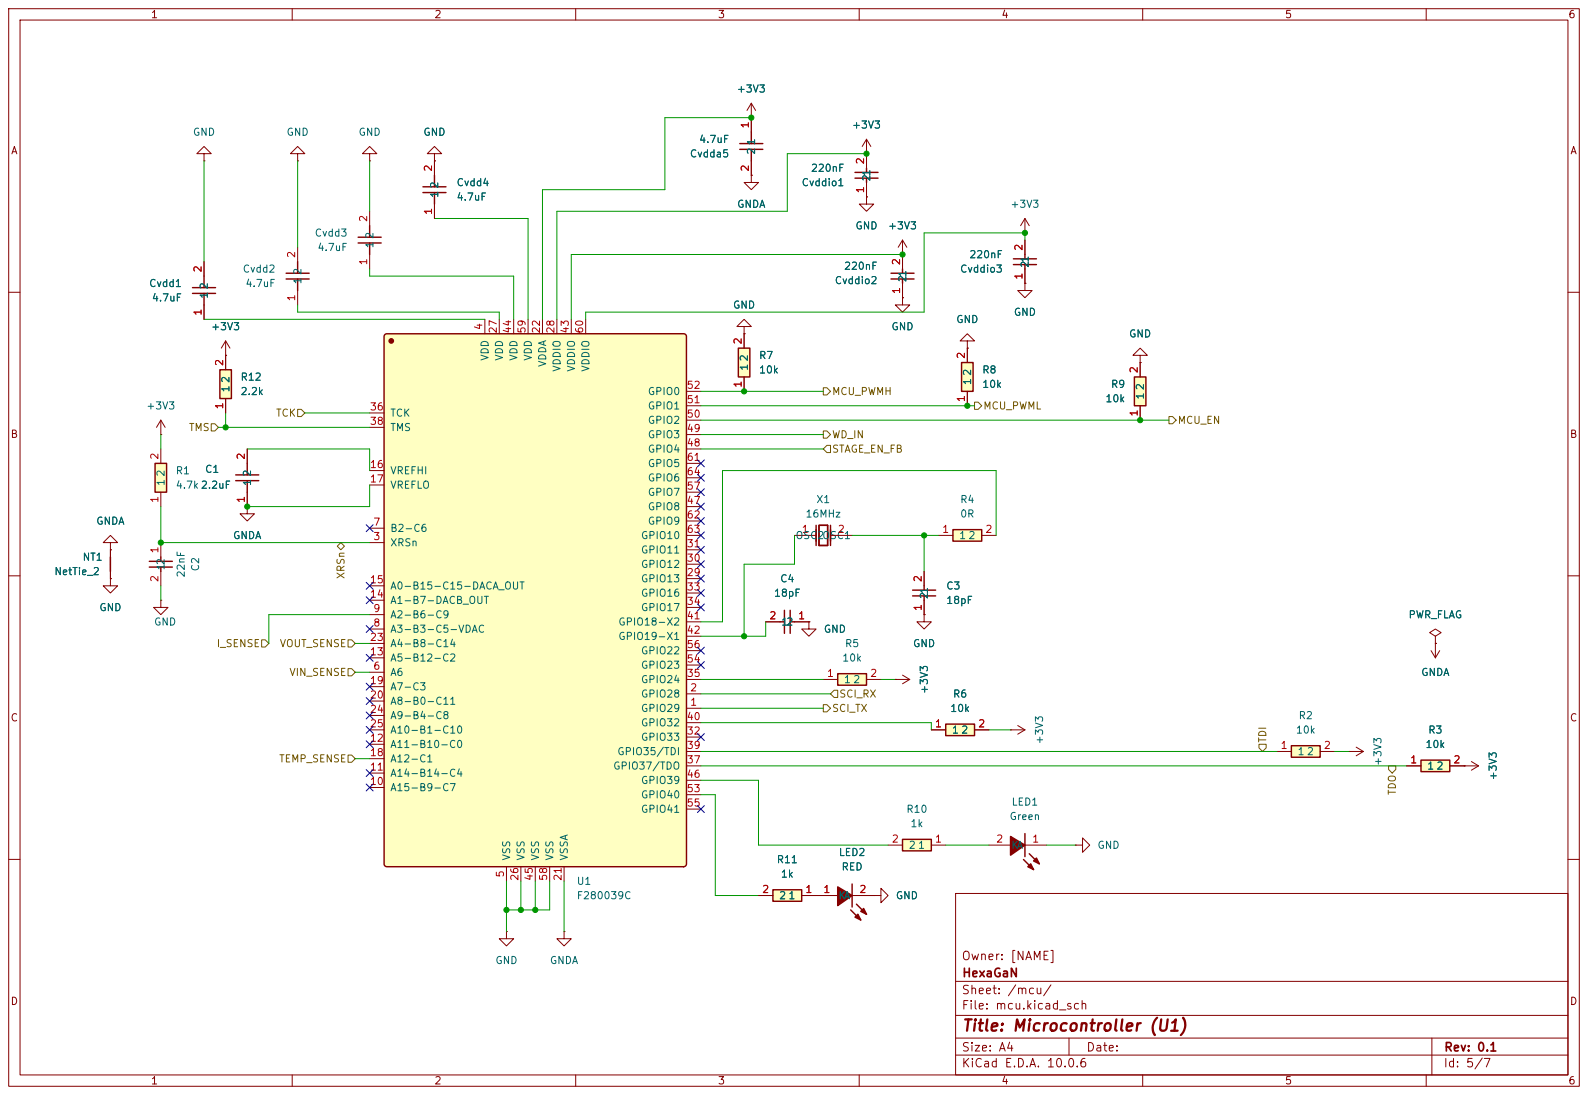
[picture p21: page 5]

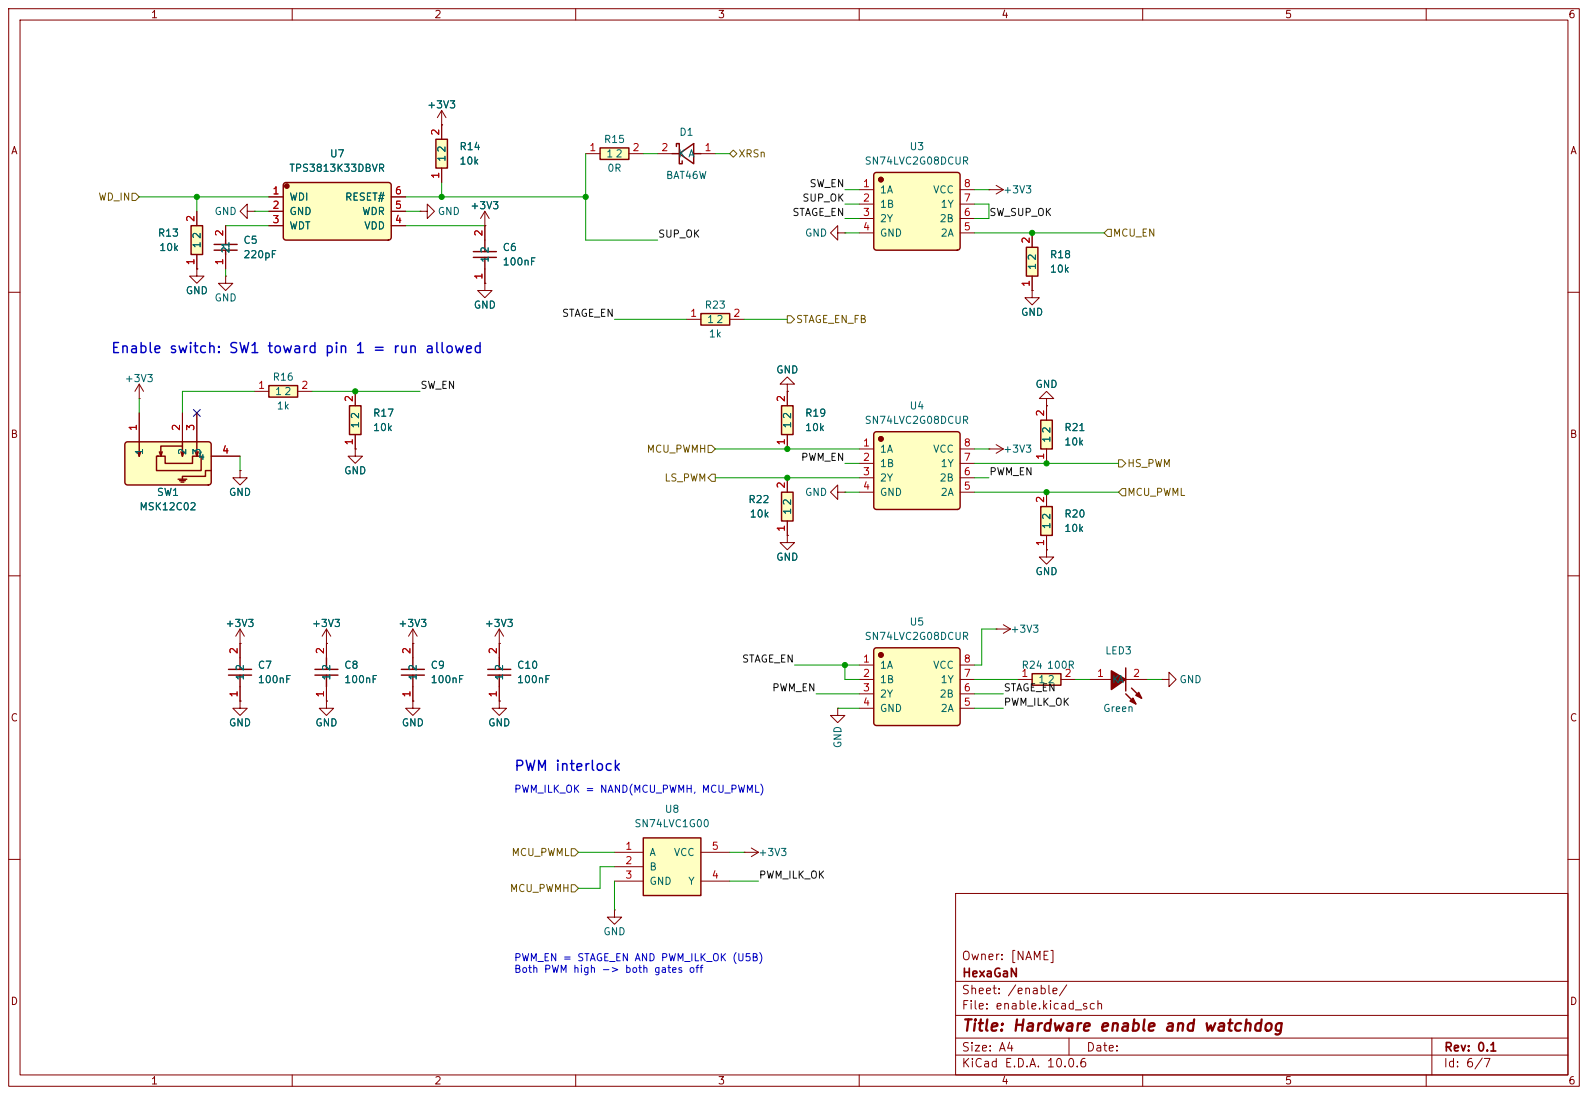
[picture p22: page 6]

10k GND WDI 1 GND 2 WDT 3
TPS3813K33DBVR

Enable switch: SW1 toward pin 1 = run allowed

PWM_EN = STAGE_EN AND PWM_ILK_OK (U5B) Both PWM high -> both gates off PWM_ILK_OK = NAND(MCU_PWMH, MCU_PWML)

HexaGaN
Sheet: /enable/
File: enable.kicad_sch
Title: Hardware enable and watchdog

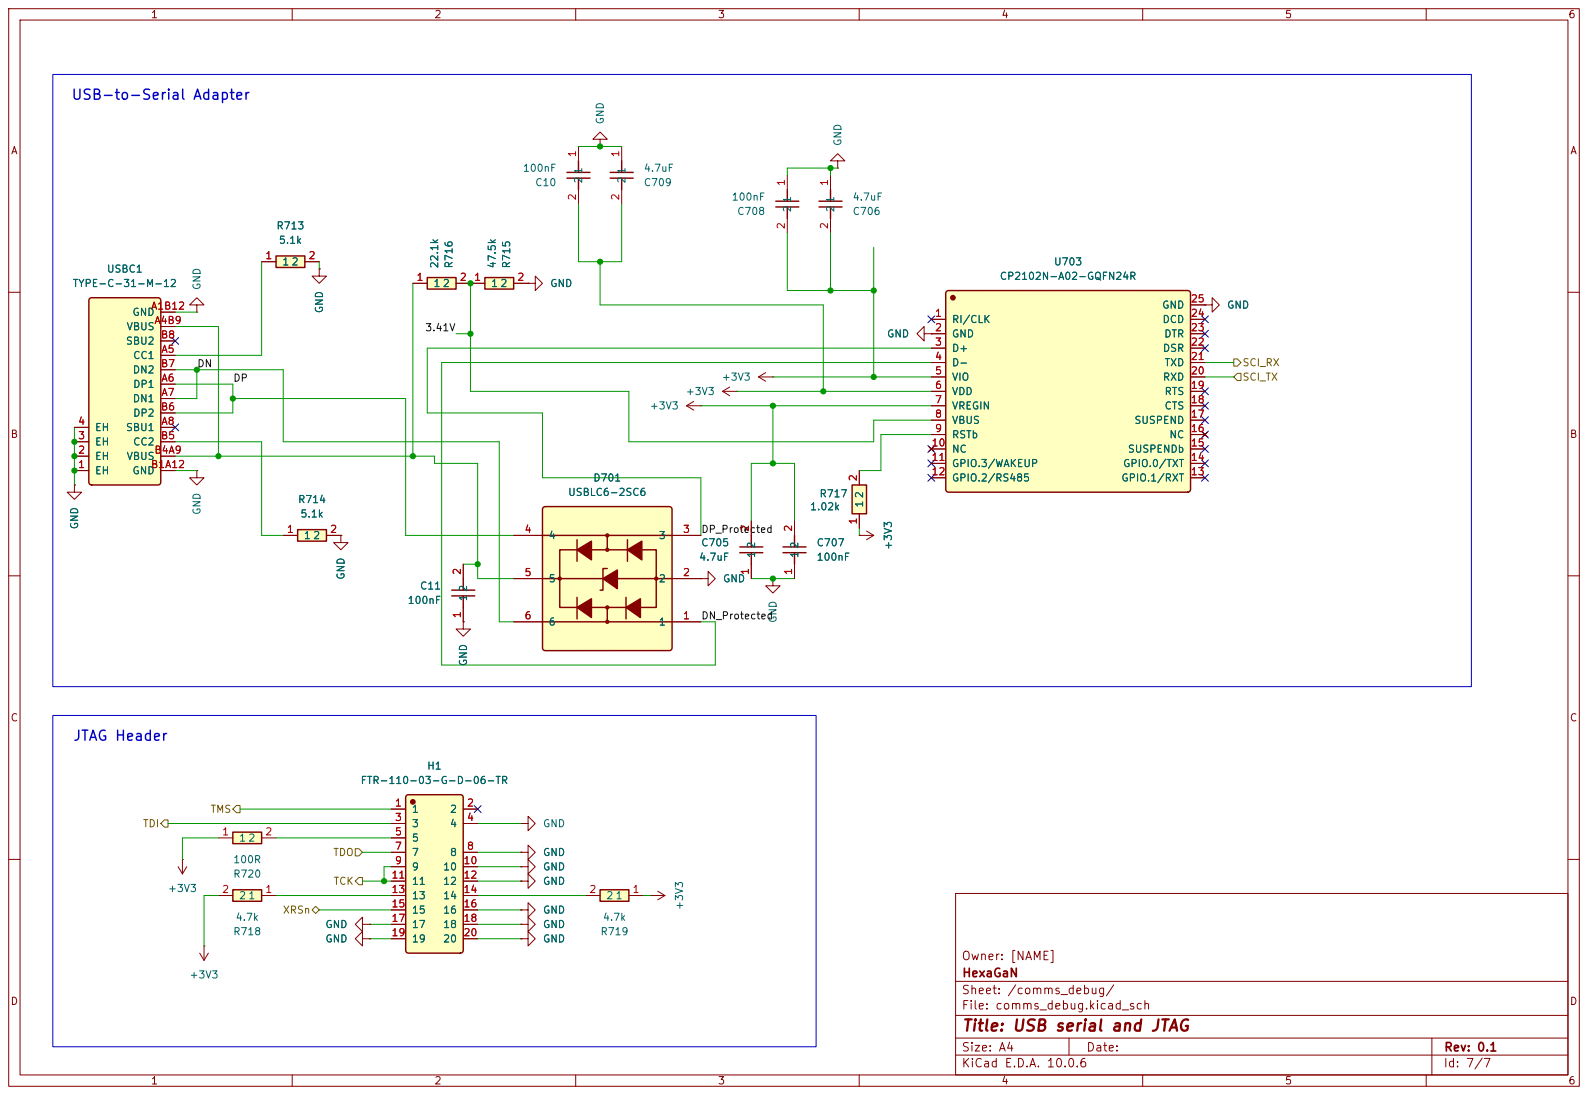
[picture p23: page 7]

3.41V USB-to-Serial Adapter
100nFGND

Owner: [NAME]
HexaGaN
Sheet: /comms_debug/
File: comms_debug.kicad_sch
Title: USB serial and JTAG
