HexaGaN-org/gan-buck-converter/hardware/gan-buck-converter/gan-buck-converter.kicad_pcb

## KiCad design hardware/gan-buck-converter/gan-buck-converter.kicad_pcb (2026-11-13)

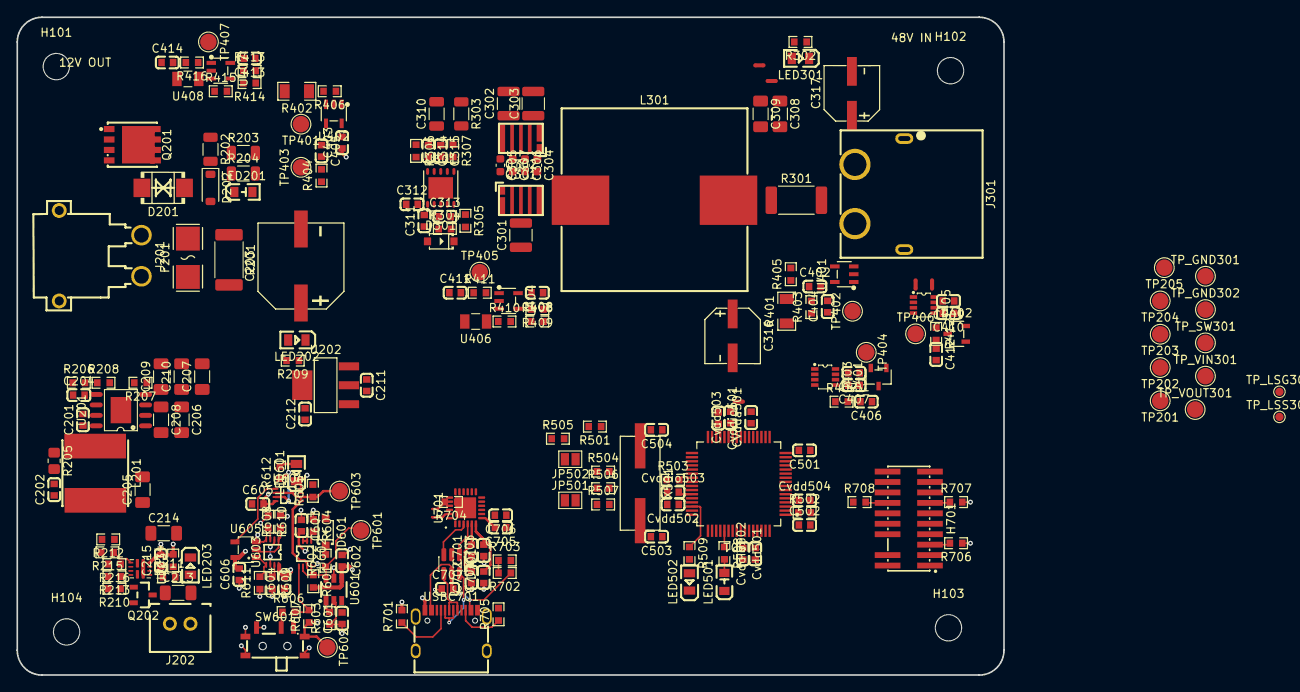
[picture p24: board gan-buck-converter.kicad_pcb from above]

Board: 4 copper layers, 120.0 x 80.0 mm, 219 parts (0 on the bottom side), 110 nets.

Parts:
C201: 2.2nF; 0603B222K500NT
C202, C404, C405: 1nF; CL10B102KB8NNNC
C203: 100uF; VKME1452A101MV
C204: 100pF; CL10C101JB8NNNC
C205, C213, C214, C308, C309: 22uF; C_1206_3216Metric_Pad1.33x1.80mm_HandSolder
C206, C207, C208, C209, C210: 2.2uF; C_1206_3216Metric_Pad1.33x1.80mm_HandSolder
C211: 1uF; CL10A105KB8NNNC
C212, C312: 10uF; CL10A106MA8NRNC
C215, C311, C313, C401, C402, C403, C407, C408, C409, C410, C411, C412, C413, C414, C602, C603, C604, C605, C606, C701, C703, C706, C707: 100nF; CC0603KRX7R9BB104
C301, C302, C303: 10uF; C_1210_3225Metric
C304, C305, C306, C307: 100nF; C_0603_1608Metric
C310: Snubber; C_1206_3216Metric
C314, C315, C406: 22pF; CL10C220JB8NNNC
C316, C317: 270uF; APXJ160ARA271MF80J
C501: 2.2uF; GRM188R71A225KE15D
C502: 22nF; CL10B223KB8NNNC
C503, C504: 18pF; CL10C180JB8NNNC
C601: 220pF; CL10C221JB8NNNC
C702, C704, C705: 4.7uF; CL10B475KQ8NQNC
Cvdd501, Cvdd502, Cvdd503, Cvdd504: 4.7uF; CL10B475KQ8NQNC
Cvdda501: 4.7uF; CL10B475KQ8NQNC
Cvddio501, Cvddio502, Cvddio503: 220nF; CL10B224KA8NNNC
D201: SMBJ51CA; SMBJ51CA_C41376101
D202: BZT52C12; D_SOD-123
D301, D601: BAT46W; BAT46W_C7420332
D401, D402: BAT54S; BAT54S_215
D701: USBLC6-2SC6; SC-74-6_1.55x2.9mm_P0.95mm
F201: 7A; 0451007_MRL
H101, H102, H103, H104: MountingHole_Pad; MountingHole_3.2mm_M3
H701: FTR-110-03-G-D-06-TR
J201: XT30PW-M
J202: B2B-XH-A_LF_SN
J301: XT60PW-F_C428722
JP501: BOOT_GPIO24; SolderJumper-2_P1.3mm_Open_Pad1.0x1.5mm
JP502: BOOT_GPIO32; SolderJumper-2_P1.3mm_Open_Pad1.0x1.5mm
L201: 47uH; FNR8040S470MT
L301: 6.8uH; SLB2212P6R8MTT
LED201: 48V; FC-2012HRK-620D
LED202: POWER; 0805G_Green
LED203: 5V EXT; whiteLEDSMD
LED301: 12V; 0805G_Green
LED501: FAULT; FC-2012HRK-620D
LED502: HEARTBEAT; 0805G_Green
LED601: ARMED; 17-21SUYC_TR8
NT201, NT202, NT301, NT302, NT501: NetTie_2; NetTie-2_SMD_Pad0.5mm
Q201: BSC070N10NS3G
Q202: AO3401A
Q301, Q302: IGC033S10S1; IGC033S10S1_C41381300
R201, R301: 1m; R_2512_6332Metric_Pad1.40x3.35mm_HandSolder
R202, R203, R204: 100k; R_1206_3216Metric
R205: 300k; R_0805_2012Metric_Pad1.20x1.40mm_HandSolder
R206: 470k; 0603WAF4703T5E
R207, R216, R406, R408, R413: 20k; 0603WAF2002T5E
R208, R405: 150k; 0603WAF1503T5E
R209, R509: 330R; 0603WAF3300T5E
R210: 75k; 0603WAF7502T5E
R211, R501: 2.2k; 0603WAF2201T5E
R212: 26.1k; 0603WAF2612T5E
R213: 8.2k; 0603WAF8201T5E
R214: 100k; 0603WAF1003T5E
R215, R302, R410, R415, R601, R603, R604, R607, R608, R609, R610, R611: 10k; 0603WAF1002T5E
R303: Snubber; R_1206_3216Metric
R304, R706: 100R; 0603WAF1000T5E
R305: 2R; 0603WAF200KT5E
R306, R307, R403, R404, R407, R411, R412, R416, R508, R605, R606, R612: 1k; 0603WAF1001T5E
R401, R402: 750k; 1206W4F7503T5E
R409, R414: 4.02k; 0603WAF4021T5E_C23040
R502, R707, R708: 4.7k; RCT034K7JLF
R503, R602: 0R; 0603WAJ0000T5E
R504, R505, R506, R507: 10k; RCT0310KJLF
R701, R705: 5.1k; 0603WAF5101T5E
R702: 22.1k; 0603WAF2212T5E
R703: 47.5k; 0603WAF4752T5E
R704: 1.02k; RT0603BRD071K02L
SW601: MSK12C02
TP201: 5V_EXT; TestPoint_Pad_D2.0mm
TP202: 5V_AUX; TestPoint_Pad_D2.0mm
TP203, TP602: GND; TestPoint_Pad_D2.0mm
TP204: 5V; TestPoint_Pad_D2.0mm
TP205: 3V3; TestPoint_Pad_D2.0mm
TP401: GNDA; TestPoint_Pad_D2.0mm
TP402: V_OUT_SENSE; TestPoint_Pad_D2.0mm
TP403: V_IN_SENSE; TestPoint_Pad_D2.0mm
TP404: I_OUT_SENSE; TestPoint_Pad_D2.0mm
TP405: HS_TEMP_SENSE; TestPoint_Pad_D2.0mm
TP406: I_IN_SENSE; TestPoint_Pad_D2.0mm
TP407: LS_TEMP_SENSE; TestPoint_Pad_D2.0mm
TP601: SUP_OK; TestPoint_Pad_D2.0mm
TP603: STAGE_EN; TestPoint_Pad_D2.0mm
TP_GND301, TP_GND302: TestPoint; TestPoint_Pad_D2.0mm
TP_LSG301: LS_GATE; TestPoint_Pad_D1.0mm
TP_LSS301: LS_SOURCE; TestPoint_Pad_D1.0mm
TP_SW301: TestPoint; TestPoint_Pad_D2.0mm
TP_VIN301: TestPoint; TestPoint_Pad_D2.0mm
TP_VOUT301: TestPoint; TestPoint_Pad_D2.0mm
U201: LM5164DDAR
U202: LDL1117S33R
U203: TPS2121RUXR; Texas_VQFN-HR-12_2x2.5mm_P0.5mm
U301: LM5113QDPRRQ1
U401, U402, U404, U407: TLV9061; TLV9061IDBVR
U403, U405: INA241A3; INA241A3IDDFR
U406, U408: PTS120601B1K00P100; Vishay_PTS1206
U501: F280039C; F280039CSPM
U601: TPS3813K33DBVR
U602, U603, U604: SN74LVC2G08DCUR
U605: SN74LVC1G00; SN74LVC1G00DBVR
U701: CP2102N-A02-GQFN24R; CP2102N_QFN24_4x4mm_P0.5mm_EP2.55x2.55mm
USBC701: TYPE-C-31-M-12
X501: 16MHz; ESD16_0000F12M25F

Connections:
+3V3: C212.1, C401.2, C402.2, C403.2, C408.2, C409.2, C413.2, C602.2, C603.2, C604.2, C605.2, C606.2, C701.2, C702.2, C703.2, C704.2, C705.2, C706.2, Cvdda501.1, Cvddio501.2, Cvddio502.2, Cvddio503.2, D401.2 (K), D402.2 (K), R209.1, R410.2, R415.2, R501.2, R502.2, R504.2, R505.2, R506.2, R507.2, R601.2, R704.1, R706.1, R707.2, R708.1, SW601.1, TP205.1 (1_1), U202.2 (VOUT), U202.4 (VOUT), U401.5 (V+), U402.5 (V+), U403.7 (REF1), U404.5 (V+), U405.7 (REF1), U407.5 (V+), U501.22 (VDDA), U501.28 (VDDIO), U501.43 (VDDIO), U501.60 (VDDIO), U601.4 (VDD), U602.8 (VCC), U603.8 (VCC), U604.8 (VCC), U605.5 (VCC), U701.5 (VIO), U701.6 (VDD), U701.7 (VREGIN)
+5V: C211.1, C214.1, C311.2, C312.2, C407.2, C410.2, D301.1 (A), TP204.1 (1_1), U202.3 (VIN), U203.1 (OUT), U203.8 (OUT), U301.1 (VDD), U403.6 (VS), U405.6 (VS)
/Comms and Debug/3.41V: R702.2, R703.1, U701.8 (VBUS)
/Comms and Debug/DN: D701.6, USBC701.A7 (DN1), USBC701.B7 (DN2)
/Comms and Debug/DN_Protected: D701.1, U701.4 (D-)
/Comms and Debug/DP: D701.4, USBC701.A6 (DP1), USBC701.B6 (DP2)
/Comms and Debug/DP_Protected: D701.3, U701.3 (D+)
/Comms and Debug/SCI_RX: U501.2 (GPIO28), U701.21 (TXD)
/Comms and Debug/SCI_TX: U501.1 (GPIO29), U701.20 (RXD)
/Comms and Debug/TCK: H701.9, H701.11, U501.36 (TCK)
/Comms and Debug/TDI: H701.3, R506.1, U501.39 (GPIO35/TDI)
/Comms and Debug/TDO: H701.7, R507.1, U501.37 (GPIO37/TDO)
/Comms and Debug/TMS: H701.1, R501.1, U501.38 (TMS)
/Comms and Debug/XRSn: C502.1, D601.1 (A), H701.15, R502.1, U501.3 (XRSn)
/Enable/HS_PWM: R307.1, R609.1, U603.7 (1Y)
/Enable/LS_PWM: R306.2, R610.2, U603.3 (2Y)
/Enable/MCU_EN: R604.2, U501.50 (GPIO2), U602.5 (2A)
/Enable/MCU_PWMH: R608.1, U501.52 (GPIO0), U603.1 (1A), U605.2 (B)
/Enable/MCU_PWML: R611.2, U501.51 (GPIO1), U603.5 (2A), U605.1 (A)
/Enable/PWM_EN: U603.2 (1B), U603.6 (2B), U604.3 (2Y)
/Enable/PWM_ILK_OK: U604.5 (2A), U605.4 (Y)
/Enable/STAGE_EN: R605.1, TP603.1 (1_1), U602.3 (2Y), U604.1 (1A), U604.2 (1B), U604.6 (2B)
/Enable/STAGE_EN_FB: R605.2, U501.48 (GPIO4)
/Enable/SUP_OK: R601.1, R602.1, TP601.1 (1_1), U601.6 (RESET#), U602.2 (1B)
/Enable/SW_EN: R606.2, R607.2, U602.1 (1A)
/Enable/SW_SUP_OK: U602.6 (2B), U602.7 (1Y)
/Enable/WD_IN: R603.2, U501.49 (GPIO3), U601.1 (WDI)
/Input Supply/5V_AUX: C202.1, C205.1, L201.2, R206.1, R212.1, TP202.1 (1_1), U203.2 (IN2)
/Input Supply/5V_EXT: C213.1, Q202.2 (S), R210.1, R211.1, TP201.1 (1_1), U203.7 (IN1)
/Input Supply/I_SH_IN_N: NT202.2, U405.1 (IN-)
/Input Supply/I_SH_IN_P: NT201.2, U405.8 (IN+)
/Input Supply/V_IN_RTN: D201.2, J201.1 (-), Q201.5 (D), Q201.6 (D), Q201.7 (D), Q201.8 (D)
/Microcontroller/BOOT_GPIO24: JP501.1 (A), R504.1, U501.35 (GPIO24)
/Microcontroller/BOOT_GPIO32: JP502.1 (A), R505.1, U501.40 (GPIO32)
/Microcontroller/HS_TEMP_SENSE: C411.2, R411.2, TP405.1 (1_1), U501.23 (A4-B8-C14)
/Microcontroller/I_IN_SENSE: C412.2, D402.3 (AK), R412.2, TP406.1 (1_1), U501.9 (A2-B6-C9)
/Microcontroller/I_OUT_SENSE: C406.2, D401.3 (AK), R407.2, TP404.1 (1_1), U501.8 (A3-B3-C5-VDAC)
/Microcontroller/LS_TEMP_SENSE: C414.2, R416.2, TP407.1 (1_1), U501.13 (A5-B12-C2)
/Microcontroller/V_IN_SENSE: C405.2, R404.2, TP403.1 (1_1), U501.15 (A0-B15-C15-DACA_OUT)
/Microcontroller/V_OUT_SENSE: C404.2, R403.2, TP402.1 (1_1), U501.14 (A1-B7-DACB_OUT)
/Power Stage/HS_DRIVE: Q301.1 (G), R305.1, U301.4 (HOL)
/Power Stage/I_SH_OUT_N: NT302.2, U403.1 (IN-)
/Power Stage/I_SH_OUT_P: NT301.2, U403.8 (IN+)
/Power Stage/LS_DRIVE: Q302.1 (G), TP_LSG301.1 (1_1), U301.9 (LOL), U301.10 (LOH)
/Power Stage/SW_NODE: C313.2, L301.1, Q301.3 (S), Q301.5 (S), Q301.6 (S), Q302.2 (D), Q302.4 (D), R303.1, TP_SW301.1 (1_1), U301.5 (HS)
GND: C203.2, C205.2, C206.2, C207.2, C208.2, C209.2, C210.2, C211.2, C212.2, C213.2, C214.2, C215.2, C301.1, C302.1, C303.1, C304.1, C305.1, C306.1, C307.1, C308.1, C309.1, C310.2, C311.1, C312.1, C314.1, C315.1, C316.2, C317.2, C401.1, C402.1, C403.1, C407.1, C408.1, C409.1, C410.1, C413.1, C502.2, C503.1, C504.1, C601.1, C602.1, C603.1, C604.1, C605.1, C606.1, C701.1, C702.1, C703.1, C704.1, C705.1, C706.1, C707.1, Cvdd501.2, Cvdd502.2, Cvdd503.2, Cvdd504.2, Cvddio501.1, Cvddio502.1, Cvddio503.1, D202.2 (A), D701.2, H701.4, H701.8, H701.10, H701.12, H701.16, H701.17, H701.18, H701.19, H701.20, J202.2, J301.4 (-), JP501.2 (B), JP502.2 (B), LED201.1 (-), LED202.2 (K), LED203.2 (K), LED301.2 (K), LED501.1 (-), LED502.2 (K), LED601.2 (-), NT501.1, Q201.1 (S), Q201.2 (S), Q201.3 (S), Q202.1 (G), Q302.3 (S), Q302.5 (S), Q302.6 (S), R207.2, R208.2, R214.2, R215.2, R216.2, R405.1, R406.1, R409.1, R414.1, R603.1, R604.1, R607.1, R608.2, R609.2, R610.1, R611.1, R701.2, R703.2, R705.2, SW601.4, TP203.1 (1_1), TP602.1 (1_1), TP_GND301.1 (1_1), TP_GND302.1 (1_1), TP_LSS301.1 (1_1), U201.1 (GND), U201.9 (EP), U202.1 (GND), U203.4 (OV2), U203.9 (ST), U203.12 (GND), U301.8 (VSS), U301.11 (EP), U401.2 (V-), U402.2 (V-), U403.2 (GND), U403.3 (REF2), U404.2 (V-), U405.2 (GND), U405.3 (REF2), U406.2, U407.2 (V-), U408.2, U501.5 (VSS), U501.26 (VSS), U501.45 (VSS), U501.58 (VSS), U601.2 (GND), U601.5 (WDR), U602.4 (GND), U603.4 (GND), U604.4 (GND), U605.3 (GND), U701.2 (GND), U701.25 (GND), USBC701.1 (EH), USBC701.2 (EH), USBC701.3 (EH), USBC701.4 (EH), USBC701.A1B12 (GND), USBC701.B1A12 (GND)
GNDA: C404.1, C405.1, C406.1, C411.1, C412.1, C414.1, C501.1, Cvdda501.2, D401.1 (A), D402.1 (A), NT501.2, TP401.1 (1_1), U501.17 (VREFLO), U501.21 (VSSA)
unnamed: C202.2, C204.1, R205.2
unnamed: C310.1, R303.2
unnamed: C707.2, D701.5, R702.1, USBC701.A4B9 (VBUS), USBC701.B4A9 (VBUS)
unnamed: Cvdd501.1, U501.59 (VDD)
unnamed: Cvdd502.1, U501.44 (VDD)
unnamed: Cvdd503.1, U501.27 (VDD)
unnamed: Cvdd504.1, U501.4 (VDD)
unnamed: D201.1, F201.2, NT201.1, R201.1, R202.1, R203.1, R204.1
unnamed: D202.1 (K), Q201.4 (G), R202.2
unnamed: D301.2 (K), R304.2
unnamed: D601.2 (K), R602.2
unnamed: H701.5, R706.2
unnamed: H701.13, R707.1
unnamed: H701.14, R708.2
unnamed: F201.1, J201.2 (+)
unnamed: L301.2, NT301.1, R301.1
unnamed: LED201.2 (+), R203.2, R204.2
unnamed: LED202.1 (A), R209.2
unnamed: LED203.1 (A), R211.2
unnamed: LED301.1 (A), R302.2
unnamed: LED501.2 (+), R508.2
unnamed: LED502.1 (A), R509.2
unnamed: LED601.1 (+), R612.2
unnamed: J202.1, Q202.3 (D)
unnamed: R606.1, SW601.2
unnamed: C201.2, U201.7 (BST)
unnamed: C204.2, R206.2, R208.1, U201.5 (FB)
unnamed: R207.1, U201.4 (RON)
unnamed: C201.1, L201.1, R205.1, U201.8 (SW)
unnamed: R212.2, R215.1, U203.3 (CP2)
unnamed: R214.1, U203.10 (ILM)
unnamed: R213.2, R216.1, U203.5 (OV1)
unnamed: R210.2, R213.1, U203.6 (PR1)
unnamed: C215.1, U203.11 (SS)
unnamed: C313.1, R304.1, U301.2 (HB)
unnamed: C315.2, R307.2, U301.6 (HI)
unnamed: R305.2, U301.3 (HOH)
unnamed: C314.2, R306.1, U301.7 (LI)
unnamed: R401.1, R405.2, U401.3 (IN+)
unnamed: R403.1, U401.1 (OUT), U401.4 (IN-)
unnamed: R402.1, R406.2, U402.3 (IN+)
unnamed: R404.1, U402.1 (OUT), U402.4 (IN-)
unnamed: R407.1, U403.5 (OUT)
unnamed: R410.1, U404.3 (IN+), U406.1
unnamed: R408.1, R409.2, U404.4 (IN-)
unnamed: R408.2, R411.1, U404.1 (OUT)
unnamed: R412.1, U405.5 (OUT)
unnamed: R415.1, U407.3 (IN+), U408.1
unnamed: R413.1, R414.2, U407.4 (IN-)
unnamed: R413.2, R416.1, U407.1 (OUT)
unnamed: R503.2, U501.41 (GPIO18-X2)
unnamed: C504.2, U501.42 (GPIO19-X1), X501.1 (OSC1)
unnamed: R509.1, U501.46 (GPIO39)
unnamed: R508.1, U501.53 (GPIO40)
unnamed: C501.2, U501.16 (VREFHI)
unnamed: C601.2, U601.3 (WDT)
unnamed: R612.1, U604.7 (1Y)
unnamed: R704.2, U701.9 (RSTb)
unnamed: R701.1, USBC701.A5 (CC1)
unnamed: R705.1, USBC701.B5 (CC2)
unnamed: C503.2, R503.1, X501.2 (OSC2)
V_IN: C203.1, C206.1, C207.1, C208.1, C209.1, C210.1, C301.2, C302.2, C303.2, C304.2, C305.2, C306.2, C307.2, NT202.1, Q301.2 (D), Q301.4 (D), R201.2, R402.2, TP_VIN301.1 (1_1), U201.2 (VIN), U201.3 (EN/UVLO)
V_OUT: C308.2, C309.2, C316.1, C317.1, J301.3 (+), NT302.1, R301.2, R302.1, R401.2, TP_VOUT301.1 (1_1)
