HexaGaN-org/gan-buck-converter/(commit log)

2026-11-03 Add README, specifications template, .gitignore and .gitattributes
    - README: project overview, repo layout, tools, KiCad library rules,
    48 V bring-up safety and contributing habits
    - docs/specifications.md: one-page design targets, all [TBD]
    - .gitignore: KiCad, CCS/C2000 build output, fab outputs, OS clutter
    - .gitattributes: LF line endings for KiCad and SysConfig files
    Claude-Session: https://claude.ai/code/session_0172acSrzGhkyg3ZJSpKQFiT
2026-11-03 Set 150 W power target in specifications
    Output 12 V at 12.5 A (150 W), with layout and part ratings sized for
    200 W headroom; 3.3 A input at 48 V; switching frequency 300-500 kHz;
    natural-convection cooling. Add a test-equipment table so the target
    is confirmed against the lab's supply, load and scope.
    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
2026-11-03 Choose TMS320F280039C (64-pin PM) as the MCU
    Same device as the universal control board, so tools, firmware and
    the LaunchPad carry over; the 64-pin package keeps the schematic and
    layout simple. Rationale recorded in docs/specifications.md. Pin-mux
    and stock still to be confirmed before schematic freeze.
    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
2026-11-03 Add schematic hierarchy definition
    Six sub-sheets (input_supply, power_stage, sensing, mcu, enable,
    comms_debug), each with its responsibilities, contents and
    hierarchical-label interface, plus a signal glossary, connector
    table, conventions and a pre-merge checklist.
    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
2026-11-03 Add external 5 V input and source-select jumper
    input_supply gains J6 (external 5 V bench input) and JP1 (3-pin
    AUX/EXT select onto +5V), so the MCU, firmware, sensing and enable
    logic can be brought up with no 48 V on the board. Documents why a
    jumper is used instead of a diode-OR, and the bring-up order.
    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
2026-11-03 Fix spacing before section break in schematic hierarchy
    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
2026-11-03 Replace 5 V source jumper with a power mux
    input_supply now uses a two-input power multiplexer (TPS2121-class)
    to select between the external 5 V header (priority) and the aux
    regulator, with reverse-current blocking. Removes JP1; updates the
    rationale, priority, switchover and bring-up notes.
    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
2026-11-03 Switch power stage to discrete GaN FETs with a GaN gate driver
    The power stage now uses two discrete enhancement-mode GaN FETs and a
    GaN-specific half-bridge gate driver (LMG1205-class) instead of an
    integrated half-bridge. power_stage gains the driver, split gate
    resistors and gate pull-downs, plus notes on gate- and power-loop
    layout, gate-voltage limits, dead time and FET packaging. README and
    specifications updated to match.
    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
2026-11-03 add kicad files
2026-11-03 Add project-local KiCad libraries
    hexagan symbol and footprint libraries plus a 3D model folder inside
    the KiCad project, registered in sym-lib-table and fp-lib-table with
    ${KIPRJMOD}-relative paths so the project opens identically on every
    machine.
    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
2026-11-03 Add hierarchical sheet skeleton
    Six empty sub-sheets in hardware/gan-buck-converter/sheets/
    (input_supply, power_stage, sensing, mcu, enable, comms_debug), each
    with a title block, placed as sheet symbols on the top sheet with
    page numbers 2-7 to match docs/schematic-hierarchy.md. The hierarchy
    doc now names the real top-sheet file and project folder.
    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
2026-11-03 Add JLCPCB design rules and assembly workflow
    Covers choosing Economic vs Standard PCBA, fabrication house rules
    alongside JLCPCB's limits, part selection (LCSC numbers, Basic parts,
    stock), layout rules for assembly, the order workflow using the KiCad
    JLCPCB Tools plugin, and a pre-order checklist. Flags that the
    LMG1205's DSBGA package may require Standard PCBA.
    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
2026-11-03 Add blank BOM workbook, one tab per schematic sheet
    docs/gan-buck-converter-BOM.xlsx has a tab for each KiCad sub-sheet
    with input columns, dropdowns for JLC part type, assembly and status,
    automatic line numbers and extended cost, a per-sheet total, and a
    flag on JLC-assembled lines missing an LCSC number.
    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
2026-11-03 Add design-note template and a blank note per schematic sheet
    docs/design/ holds one note per KiCad sheet (input_supply,
    power_stage, sensing, mcu, enable, comms_debug), each with sections
    for purpose, a decision log, a calculations table, part selection,
    values published to other sheets, layout notes, verification and
    open questions. Includes an index and a reusable _template.md.
    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
2026-11-03 Modify owner and last updated in power_stage.md
    Updated owner and last updated date in design notes.
2026-11-03 Simplify design-note calculation tables; fill purpose and requirements
    Calculation tables in every note (and the template) are now
    Calculation | Formula | Result | Notes. Each sheet's note now states
    its purpose and requirements, drawn from specifications.md and
    schematic-hierarchy.md, with links back to both.
    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
2026-11-03 Add duty cycle calculation to power stage documentation
2026-11-04 Rewrite firmware requirements as a plain-language guide
    Reworked for readers new to power electronics: explains what the
    board does and the key ideas (PWM, duty cycle, dead time, control
    loop, trips, enable, watchdog), replaces the numbered requirement
    tables with plain lists, adds a state diagram and six golden rules,
    and keeps the step-by-step plan.
    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
2026-11-04 modify kicad files
2026-11-04 Record GaN FET and gate driver choices
    - GaN FETs: Infineon IGC033S10S1 (LCSC C41381300), both positions
    - Gate driver: TI LM5113-Q1 (LCSC C2677036), keeps Economic PCBA
    design/power_stage.md gains the decision log, loss and timing
    calculations, part selection, values published to input_supply and
    mcu, layout notes, verification tests and open questions; the duty
    cycle row is corrected to 12/48. specifications.md, the hierarchy
    doc, the JLCPCB guide and the power_stage BOM tab are updated to
    match.
    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
2026-11-04 Add preferred parts list for passives and indicators
    Basic-library resistors (UNI-ROYAL 0402-1206, common 0603 values with
    LCSC numbers), MLCCs (Samsung CL, YAGEO CC, Fenghua) by size and
    voltage, Extended 100 V ceramics for the 48 V bus, a current-sense
    shunt, ferrite beads and status LEDs, plus selection rules and the
    categories with no Basic option.
2026-11-04 Lock 400 kHz switching frequency and gate-drive passives
    - specifications: fsw 400 kHz nominal (300-500 kHz range), 6.8 uH inductor
    target, LM5113-Q1 corrected to 90 V, switch-node limit noted
    - design/power_stage: decisions 4-6 (frequency, gate-drive passives, DNP
    gate pull-downs), gate-drive and frequency calculations, part
    selection, published values, layout notes, verification tests
    - schematic-hierarchy: power_stage contents match the driver datasheet
    - firmware-requirements: 400 kHz default, HRPWM required
    - BOM: gate-drive parts added to power_stage tab, U301 corrected to 90 V
2026-11-04 Lock converter-stage parts with measured DC-bias derating
    - specifications: 50 mV output ripple target, inductor SLB2212P6R8MTT,
    1 mOhm shunt in series with the inductor
    - design/power_stage: decisions 7-12 (ripple target, inductor, input and
    output capacitors, shunt, J2 and snubber), effective-capacitance,
    ripple, load-step, inductor and shunt calculations, part selection,
    published values, layout notes, verification tests
    - preferred-parts: derating rule uses the manufacturer's curve; Samsung
    DC-bias retention for the 100 V and common low-voltage parts
    - schematic-hierarchy: shunt sits in series with the output inductor
    - BOM: converter-stage parts added to the power_stage tab
2026-11-04 Match docs and BOM to the power_stage schematic
    - Net names: V_IN, V_OUT, I_SH_P / I_SH_N, HS_PWM / LS_PWM (replacing
    VIN, VOUT, ISH_P / ISH_N, GATE_HI / GATE_LO); SW_NODE, HS_DRIVE and
    LS_DRIVE noted as local labels
    - Reference designators follow the schematic's annotation
    - Decision 13: no gate-to-source pull-downs (supersedes 6)
    - Test pads TP_SW, TP_VOUT, TP_VIN, TP_GND1, TP_GND2; net ties at the
    shunt for the Kelvin taps
2026-11-04 Sync power_stage reference designators with the annotated schematic
    - design/power_stage, BOM and schematic-hierarchy follow the sheet's
    300-series annotation (shunt R301, input C301-C310, output C311-C319,
    snubber R302/C320, driver parts C321-C325 and R303-R306, J301)
    - Test pads listed by their schematic names
2026-11-04 Complete power_stage sheet
2026-11-04 Check power_stage BOM against the committed schematic
    - Every LCSC number and quantity matches the schematic
    - Test pads use the schematic's references (TP_SW1, TP_VIN1, TP_VOUT1,
    TP_GND1, TP_GND2)
    - Rows sorted by reference designator
2026-11-04 Add V_IN / V_OUT power symbols; tidy power_stage symbols
    - hexagan library: V_IN and V_OUT global power symbols
    - power_stage: V_IN and V_OUT use the new symbols; +5V, GND and the
    snubber resistor move from the personal ELEC240 library to KiCad's
    power and Device libraries (same geometry)
    - Test points get TestPoint_Pad_D2.0mm footprints and are excluded from
    the BOM and position files; DNP snubber parts R302 and C320 are
    excluded too
    - schematic-hierarchy: use the hexagan power symbols for V_IN / V_OUT
2026-11-04 Add KiCad file types to .gitattributes
2026-11-04 Update README and assign sheet owners
    - README: current status, key specs, sheet owners and status, actual
    repo layout, both project libraries, workflow, team
    - Owners: Reza Rahimzadeh (top, input_supply, power_stage), Connor Jin
    (sensing, enable), Yunxi He (mcu, comms_debug), in the hierarchy doc
    and each design note
2026-11-04 Reframe dead-time proposal as an edge AI optimizer
    Rename to edge-ai-dead-time-optimizer.md. The on-board MLP loss
    surrogate with on-device search is now the core of the proposal, with
    the training/export pipeline, validation by regret on held-out
    operating points, and an out-of-distribution fallback. Fixed dead
    time, a quadratic fit and duty-cycle minimization become baselines.
2026-11-04 Consolidate docs: one home for each kind of information
    - CONTRIBUTING.md: setup, workflow, ownership, schematic conventions,
    library rules and the merge checklist (moved from the README and the
    hierarchy doc)
    - schematic-hierarchy: now only the contract between sheets; owners
    table, conventions and checklist moved out; per-sheet design guidance
    moved into the design notes
    - Design notes: interface lists replaced by the hierarchy doc; absorbed
    the moved guidance (input_supply mux decision and bring-up tests,
    enable pull-downs and fault walkthrough, MCU choice from the specs)
    - specifications: components reduced to headline parts per sheet with
    links; KiCad fields are the record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
2026-11-04 Add voltage-mode control simulation
    New simulations/ folder with a Python model of the voltage-mode loop:
    averaged power-stage model, Type III controller discretized for the
    C2000, digital delay, ADC and PWM quantization, soft-start and a
    10 % -> 90 % load step. README explains each plot for beginners and
    records first findings (20 kHz crossover instead of 25 kHz, load-step
    dip set by the polymer ESR, inductor current overshoot on load steps).
2026-11-04 Use datasheet values and add worst-case check to the simulation
    Inductor, polymer capacitor and GaN FET parameters now come from their
    datasheets. New worst-case section re-checks the controller across ESR,
    inductance, capacitance and input-voltage tolerances (plot 5). The 20 kHz
    design falls to ~3 deg phase margin at the worst corner, so the default
    crossover is now 10 kHz (44 deg / 7.3 dB worst case) with input-voltage
    feedforward. README findings updated, including the polymer datasheet
    not matching the BOM part.
2026-11-04 current sensor
2026-11-05 Design the 48 V input protection and set the input range
    - Input range 40 / 48 / 51 V, set by the SMBJ51CA TVS (82.4 V clamp,
    7.6 V below the gate driver's 90 V limit)
    - J1: KF635 screw terminal, same part as J301
    - Front end: fuse, bidirectional TVS, low-side reverse-polarity FET,
    100 uF damping electrolytic; decisions, calculations, parts,
    published values, layout notes and bench tests in input_supply.md
    - README: sheet status and bench safety rules
2026-11-05 Add input hot-plug simulation and set the specified input range
    - input_hotplug_sim.py: hot-plug ringing with and without C201,
    C201 ripple current, input-filter output impedance
    - voltage_mode_sim.py: input range 40-51 V (was assumed 36-54 V);
    loop margins unchanged thanks to feedforward
2026-11-05 Design the aux regulator, 5 V mux and J6 input
    - Aux regulator: LM5164 (100 V, 1 A) at ~620 kHz with Type-3 ripple
    injection; EN tied to V_IN; output on local net +5V_AUX
    - Power mux: TPS2121 in XCOMP fast-switchover mode (~5 us), with an
    overvoltage cutoff on J6 at ~5.5 V to protect the GaN gate supply
    - J6: keyed JST XH header with an AO3401A reverse-polarity FET; PTC
    dropped (bench supply and mux current limit cover overcurrent)
    - C201 kept: ripple judged against its ambient-derated rating
    - USB-C stays data only
    - Decisions 9-16, calculations, parts, published +5V values, layout
    notes and bench tests in input_supply.md; hierarchy doc, specs and
    README updated
2026-11-05 Add input circuits and aux regulator to input-supply sheet
2026-11-05 Add input current sensing with a second 1 mOhm shunt
    - input_supply decision 17: high-side 1 mOhm shunt R213 (same part as
    power_stage R301), after the fuse and TVS, ahead of V_IN; Kelvin pair
    I_IN_P / I_IN_N to sensing; loss, signal, layout and bench check
    - sensing: I_IN_SENSE requirement (survives the 82.4 V surge); proposed
    decision to share one amplifier part, gain about 100, for both channels
    - schematic-hierarchy: new signals I_IN_P, I_IN_N, I_IN_SENSE and the
    input_supply label table
    - mcu, firmware guide, edge-AI proposal and specifications updated;
    on-board input power is telemetry, not training-label accuracy
    - BOM: R213 on the input_supply tab
2026-11-05 Restore input_supply sheet overwritten in 0eff809
    0eff809 saved a stale, empty copy of input_supply.kicad_sch (KiCad was
    open during a pull). Restore the sheet from 3380966. Sensing changes
    from 0eff809 and f2712e6 are untouched.
2026-11-05 add shunt resistor to input
2026-11-05 Capture MCU circuitry and align project component libraries
2026-11-05 docs: sync input_supply docs and BOM to the finished sheet
    - input_supply.md: refs remapped to the schematic's annotation (bba66e4);
    new decisions #18-22 (LDL1117S33R LDO, no +3V3A, power LED, shunt net
    ties with I_SH_IN_P/N, test points); LDO and LED calculations; layout,
    verification and open questions updated, including schematic field fixes
    - schematic-hierarchy.md: I_SH_IN_P/N, 5V_AUX/5V_EXT local nets, +3V3A removed
    - sensing.md: clamp to +3V3 / GNDA; input shunt pair names
    - specifications.md, README.md: input_supply status
    - BOM input_supply tab filled from the sheet (46 parts, $6.52/board)
2026-11-05 fix shunt resistor on power_stage
2026-11-06 fixed sensor schematic:
2026-11-06 docs(sensing): document sensing sheet as drawn
    Decision log, calculations, part selection, published values, layout
    notes, verification and open questions for every part on
    sheets/sensing.kicad_sch, in the style of power_stage and input_supply.
2026-11-06 docs(enable): document enable sheet as drawn
    sheets/enable.kicad_sch, in the style of power_stage and input_supply.
    Moves the misplaced 'gates off in every fault state' row from the
    decision log to verification test 1.
    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
2026-11-06 Add a hardware shoot-through interlock to the PWM gating
    - enable decision 1: HS_PWM = PWMH AND STAGE_EN AND NOT PWML (and the
    mirror for LS), with an SN74LVC2G04 and two 74LVC1G11; delay
    calculations, parts, layout notes and two new bench tests
    - Fixes the enable note's decision log, which had held the fault-state
    test row; that test is now verification test 1
    - schematic-hierarchy: gating equations and contents updated
    - firmware guide: PWM safety setup (dead-band first, one setup file,
    outputs low on debugger halt, LaunchPad and low-voltage first runs)
    - specifications and BOM enable tab updated
2026-11-06 Capture USB UART and JTAG interfaces and update MCU clock
2026-11-06 Show concise passive values on schematic sheets
2026-11-06 docs(readme): sync status with the captured enable and comms_debug sheets
    - Status: all six sheets captured; list what remains before layout
    - At a glance: shoot-through interlock under protections, new host
    interface row (USB-C serial, JTAG)
    - Sheet table: enable and comms_debug captured; root-sheet pin
    coverage per sheet; sensing label names still to align with mcu
    - Layout: add docs/datasheets/
2026-11-06 docs: record +5V OV and fast input-OV trip decisions; fix doc drift
    - input_supply #23 / power_stage #15: keep the J202 OV cutoff (5.21-5.68 V)
    as a mistake-catcher; +5V max published as 5.5 V with that exception
    - input_supply #24: fast input-overvoltage trip, VIN_SENSE on CMPSS at ~55 V
    (needs sensing filter and mcu pin changes); added to specifications
    - power_stage #14: output shunt net ties NT301/NT302, labels I_SH_OUT_P/N
    - Rename I_SH_P/I_SH_N to I_SH_OUT_P/I_SH_OUT_N, J1/J6 to J201/J202
    - Document gate hold-off via enable R21/R22, pin 6 as the gate return
2026-11-06 fix net ties on shunt resistors
2026-11-06 lib(JLCImport): set pin types for power_stage and input_supply parts
    Passives, FETs, diodes, inductors, fuse, LEDs and connectors are Passive per
    CONTRIBUTING (several were Unspecified, and three capacitors were Input).
    LM5113: VDD/VSS Power input, HI/LI Input. LM5164, TPS2121, LDL1117: GND Power
    input, other pins Passive (typed outputs would conflict with the PWR_FLAGs).
2026-11-06 power_stage: 10 uF VDD bulk, standard pads on the input bank; sync symbol caches
    - C322: 1 uF (C15849) -> 10 uF 0603 (C96446, same part as input_supply C209)
    to meet the C_VDD >= 10 x C_BST rule (was ~0.76 uF effective at 5 V)
    - C303-C308: C_1206_3216Metric instead of the HandSolder pads (power loop)
    - power_stage and input_supply: symbol caches updated to the corrected
    JLCImport pin types; netlists unchanged
    - power_stage.md: decisions #16-#17, VDD bypass calc and part rows
2026-11-07 input_supply: test-pad footprints for TP201-TP205, exclude from BOM, TP205 value
    - TP201-TP205: SOT-23-5 -> TestPoint_Pad_D2.0mm (same pad as power_stage)
    - Excluded from BOM and position files, per CONTRIBUTING
    - TP205 Value 5V_AUX -> GND (it is the ground pad)
    - input_supply.md: open-question field fixes and part row updated
2026-11-07 docs: indicator LED plan (seven discrete 0805 LEDs, colors, placement)
    - New cross-sheet note docs/design/indicator-leds.md: principles, decisions,
    per-LED parts/resistors/currents/locations, firmware blink patterns, layout
    notes, per-sheet schematic checklist and bench tests
    - Linked from design/README, schematic-hierarchy, input_supply open questions
    and firmware-requirements
2026-11-07 add LED system
2026-11-07 docs: sync with the schematic after #6 and the root-sheet pin update
    - Sense signals renamed to match the sheets: I_OUT_SENSE, V_IN_SENSE,
    V_OUT_SENSE, HS_TEMP_SENSE/LS_TEMP_SENSE (+ I_IN_SENSE) in the hierarchy,
    specifications, input_supply, firmware docs and simulations README
    - schematic-hierarchy: current-capture status (all sheet pins synced, root not
    yet wired); connectors USBC1/H1/SW1; 16 MHz crystal; enable section as drawn
    (TPS3813, SUP_OK, NAND interlock); comms_debug parts
    - specifications: sensing, enable, comms_debug component rows
    - README: status line and per-sheet status
    - input_supply: root-sheet and status lines; LED202 footprint question closed
    - indicator-leds: re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
2026-11-07 docs: record the LED changes merged in #7
    - indicator-leds: status, checklist ticked, deviations (48V LED wiring, R209)
    - input_supply: decision #25, LED calc and part rows, 48V wiring and R209
    open questions; status line
    - power_stage: decision #18 and part row for LED301 / R307
    - README: status line
2026-11-07 fix 48V LED wiring issue, swap white LED resistor
2026-11-07 docs: sync the sheet design notes with the schematic as drawn
    input_supply (re-annotated in e85a5c7):
    - every reference remapped to the new annotation (checked part-by-part
    against the schematic's LCSC fields); 48V LED and R211 fix recorded
    (decision #25), open questions resolved; refs as of 808357c
    indicator-leds: implemented; current refs; 48V taps the fuse node (#6)
    mcu: sense inputs on their new pins (8, 9, 13, 14, 15, 23) with CMPSS
    inputs from the F280039C pin table (CMPSS3 high for I_OUT, CMPSS1 for
    V_OUT, CMPSS3 low for V_IN); LED501/R501 and LED502/R502
    enable: recorded as drawn - NAND interlock (U8, #9), SW1 on-board switch
    (#10), ARMED LED601/R601 (#11); timing, parts, layo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
2026-11-07 docs: protection plan - one comparator per trip, thresholds, ADC split
    - specifications: overcurrent ~22 A, output OV 13.2 V, fast input OV ~55 V,
    each on its own CMPSS; UVLO proposal noted; RTDs for overtemperature
    - firmware-requirements 5.3: trip table (comparator, pin, threshold, DAC
    code, response), VDDA reference, trip path, polarity, arming order;
    5.6: ADC split (I_OUT on ADCA and V_OUT on ADCB, each alone)
    - mcu: planned pin moves (V_IN_SENSE 15->18 on CMPSS4, I_IN_SENSE 9->15),
    ADC and comparator per pin; schematic change pending
    - sensing, input_supply: references to the new comparator and thresholds
2026-11-07 add PCB layout PDF
2026-11-07 power_stage: layout, verification and thermal notes from EPC WP010 and Infineon UG122052
    - Decision #19 (proposed): 4-layer "optimal power loop" layout, solid GND
    return on inner layer 1, thin L1-L2 prepreg, interleaved SW/GND vias
    - Decision #20 (proposed): no heatsink on rev A, but reserve a top-side
    heatsink zone and thermal vias; decide after test 3
    - Calculations: Miller-bump caveat, FET loss split, still-air junction
    rise (38 K/W), loop inductance from ringing
    - Verification: test 1 and 4 no longer assume a passive probe on the
    high-side gate; >= 1 GHz probing; new tests 12 (low-side gate bump)
    and 13 (loop inductance); thermal pass criterion proposed
    - Open questions: 0603 H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
2026-11-11 docs: update for wired top sheet and mounting holes
    - README and schematic-hierarchy: root sheet is wired; note sheet display
    names, mounting holes H101-H104 on GND, and the main-specifications block
    - specifications: add mounting row
    - input_supply, sensing, enable notes: mark root-sheet wiring and the
    LS_TEMP_SENSE direction fix as resolved
    - README safety: nylon standoffs, since board GND is not the supply negative
    - CONTRIBUTING: top sheet uses the 100 reference range
2026-11-11 add power tree to top sheet
2026-11-11 docs: describe the top sheet's power tree
    - schematic-hierarchy: add the power tree to the top-sheet contents, with
    each rail's voltage, maximum current and what sets it
    - README: mention the power tree in the sheet table
2026-11-11 Revise converter schematic and prepare layout review
2026-11-12 Revise schematic and pre-layout analyses
2026-11-12 Use plated, unconnected mounting holes
    Switch H101-H104 from NPTH holes to plated MountingHole_3.2mm_M3_Pad
    footprints with each pad on no net (no-connect flags on the top sheet).
    Plating gives the screw heads a durable bearing surface; leaving the
    pads unconnected keeps Q201 as the only path between J201- and GND.
    Add a top-sheet note against tying the holes to GND, and update the
    README, specifications, schematic hierarchy and input_supply notes.
2026-11-12 Update buck converter design and placed PCB
2026-11-12 Update docs and BOM for the capacitor change and re-annotation
    Rename the 145 re-annotated references across the design notes,
    hierarchy doc, firmware pin-map note and BOM, and add
    docs/reannotation-2026-11-12.md with the old-to-new tables.
    Record the capacitor reduction as power_stage decision #24 (three
    10 uF input parts, two 22 uF ceramics and two 270 uF polymers on the
    output), with the calculations, parts table, layout notes and
    verification tests updated. Flag the simulations and the input
    hot-plug model as needing a rerun.
    Remove the JLCPCB plugin cache (jlcpcb/project.db) and ignore it.
2026-11-12 Rerun simulations for the new capacitor banks; drop old-name notes
    Voltage-mode simulation: model the output bank as two 270 uF, 10 mOhm
    polymers plus two 22 uF ceramics, and move the Type III first pole onto
    the polymer ESR zero (59 kHz). Nominal phase margin 63 deg, worst case
    47 deg; load-step dip about 280 mV.
    Hot-plug simulation: model the three-part power-stage input bank.
    Nominal peak 54.6-56.6 V; C203 ripple up to 0.68 A rms.
    Update input_supply, power_stage and the simulations README with the
    new results and the NCC PXJ catalog figures for the polymer.
    Remove the re-annotation mapping table and every note that referred to
    earlier reference names.
2026-11-12 Streamline docs and remove out-of-date material
    - README: drop the top-sheet safety-notes item and the out-of-date
    block diagram (old connector, driver, supervisor and oscillator);
    refresh the status line and repository layout.
    - Move every committed datasheet and application note into
    docs/datasheets/ with descriptive names, and fix the links to them.
    - Remove the stale schematic PDF export.
    - Design notes: drop resolved and historical open-question entries,
    commit hashes and the completed LED change checklist; keep only
    open items.
2026-11-12 Add block diagram and theoretical efficiency estimate
    - docs/block-diagram.svg: board block diagram drawn from the current
    schematic, with every part reference checked against it; shown in
    the README.
    - simulations/efficiency_estimate.py: component-level loss budget
    (datasheet losses only, no layout parasitics) across load, input
    voltage and switching frequency, with plots. 150 W, 48 V, 400 kHz:
    97.9 % power stage, 97.2 % whole board, 4.35 W total loss.
    - Record the estimate in specifications.md, power_stage.md and the
    simulations README.
2026-11-13 Add JLC XT connectors and document tentative PCB layout
2026-11-13 Add LTspice switching simulation of the power stage
    Schematic and netlist of the 48 V to 12 V stage with both IGC033S10S1
    FETs (Infineon's L1 model, git-ignored because the download is gated),
    a behavioural LM5113 driver written from the datasheet, bootstrap and
    the capacitor banks. The README records the results, the switch-node
    ringing and gate-bump findings from a parasitic sweep, and every
    assumption in the model.
    Cross-checked in ngspice; not yet run in LTspice itself.
2026-11-13 Add the Infineon CoolGaN 100 V G3 library to the LTspice simulation
    The folder now runs as checked out. README setup and status updated to match.
